wntrblm/Castor_and_Pollux/hardware/mainboard/gemini.png

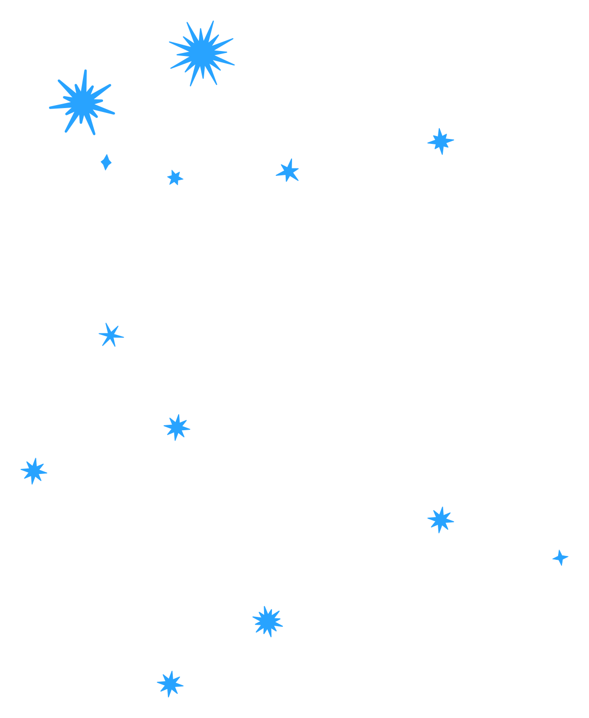
hardware/mainboard/gemini.png
