wntrblm/Castor_and_Pollux/hardware/interposer/interposer.step

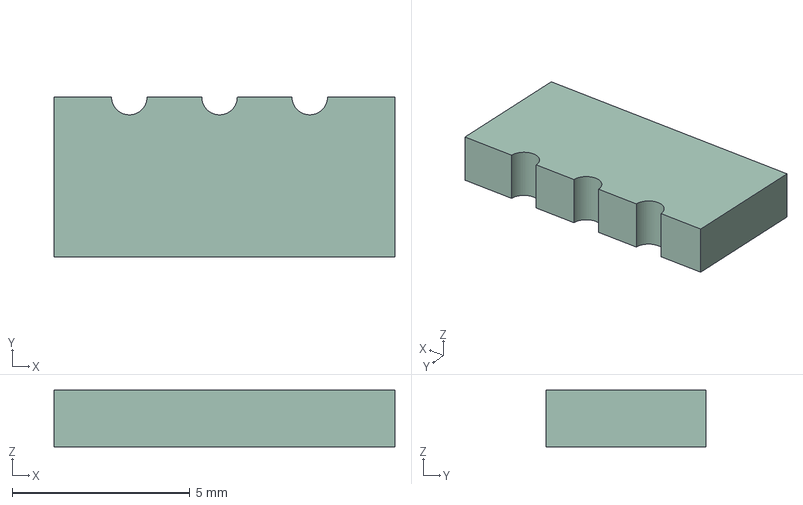
[picture p2: CAD file, 2023-03-20]
hardware/interposer/interposer.step
9.60 x 4.50 x 1.60 mm
