wntrblm/Castor_and_Pollux/hardware/jackboard/jackboard.step

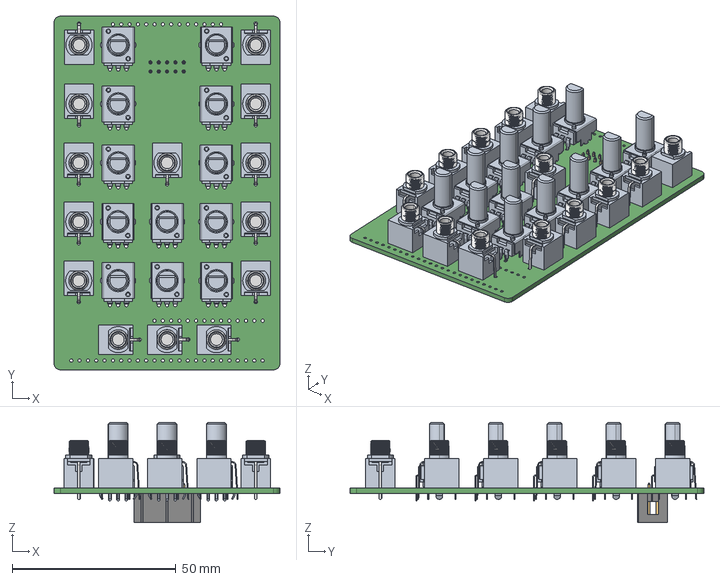
[picture p3: CAD file, 2020-07-21]
hardware/jackboard/jackboard.step
69.0 x 108.0 x 30.6 mm
