wntrblm/Castor_and_Pollux/user_guide/docs/index.md

# Manual

[Castor & Pollux][store page] is a Roland Juno-inspired oscillator. It contains two digitally controlled analog oscillators implemented using a faithfully modernized version of the original Juno 106 design. Like its inspiration, it can give you that wonderful 80's sound with independent and mixed ramp, pulse, and sub outputs. But the twins don't stop there- the second oscillator can be used to layer in thick detuned sounds, harmonically complex hard synced waveshapes, or as a fully independent second oscillator.

[TOC]

[store page]: https://winterbloom.com/store/winterbloom-castor-and-pollux

## Specifications

-   Available [assembled][store page] or as a [kit][kit store page]
-   14 HP
-   `+12 V @ 100 mA`, `-12 V @ 35 mA`
-   `25 mm` deep
-   2 separate oscillators
-   7 octave range
-   9 total outputs with waveform outputs and onboard mixers
-   Pitch CV input jacks (`0 V` to `6 V`) and pitch knobs (`-1` to `+1 octave`, configurable)
-   Pulse width CV input jacks and knobs
-   Hard sync
-   Hardware chorusing
-   Internal low-frequency oscillator (LFO)
-   [ModularGrid page][modulargrid page]

[kit store page]: https://winterbloom.com/shop/castor-and-pollux-kit
[modulargrid page]: https://www.modulargrid.net/e/winterbloom-castor-pollux

## Getting support and help

We want you to have a wonderful experience with your module. If you need help or run into problems, please reach out to us. Email is the best way for product issues, whereas Discord and GitHub are great for getting advice and help on how to customize your module or create new patches.

-   Send us [an email][email]
-   File a bug [on GitHub](https://github.com/wntrblm/Castor_and_Pollux/issues)
-   Reach out on our [Discord][discord]

## Version differences

Illustration of Castor & Pollux I and Castor & Pollux II

Castor & Pollux has two different versions in the wild with significant changes between them. Fortunately, both versions are fundamentally the same brains with different user interfaces. Changes made by Castor & Pollux II include:

-   Replacing the pitch trimpots with large knobs
-   Replacing the pulse width, LFO, and crossfade trimpots with knobs
-   Moving the input and output jacks to the bottom edge of the module
-   Moving the individual waveform outputs to a separate expander
-   Consolidating the two separate circuit boards into a single board
-   Adding additional [ESD] protection to all input jacks
-   Adding an additional LED

Both versions use the same firmware and behave the same way. This manual applies to both versions, however, the illustrations shown here depict Castor & Pollux II. We made sure that all interface elements use the same symbols and labels between the versions. If you run into trouble, don't hesitate to [reach out].

[ESD]: https://en.wikipedia.org/wiki/Electrostatic_discharge
[reach out]: #getting-support-and-help

## Installation

Illustration of power connection

To install this into your Eurorack setup, connect a Eurorack power cable from your power supply to the back of the module. **Note that even though there's a keyed power connector on the module, double check that the red stripe is on the side labeled `red stripe`!** Once you've connected the power cable, secure your module to your rack rails using screws.

## Overview

Castor & Pollux has two separate but _intertwined_ oscillators. It's possible to control each oscillator independently, but they truly shine when used together. Castor & Pollux's design is focused around the connection between these two oscillators and modulating their parameters using the internal LFO.

Illustration of Castor & Pollux's interface with elements for the separate oscillators highlighted

Castor & Pollux's front panel is arranged so that Castor's inputs, outputs, and controls are on the **left** whereas the corresponding elements are mirrored on the **right** for Pollux. The center contains controls for the internal LFO and crossfade mixer:

Each oscillator, ++"⍺"++ and ++"β"++, is controlled by its associated knobs and CV input jacks:

Illustration of the knobs and input jacks

-   The large pitch knob and pitch CV input control the oscillator's **pitch** (frequency).
-   The smaller pulse width knob and pulse width CV input control the oscillator's **pulse width**.

You can learn more about these inputs in the [pitch behavior](#pitch-behavior) section.

Each oscillator has a single output jack, ++"★"++, and corresponding mixing knobs:

Illustration of the oscillator's outputs

Each oscillator generates three waveshapes: _saw_, _pulse_, and _sub_. The three mixing knobs control how much of each waveshape is present in the oscillator's output. You can read more about the sound of each waveshape in the [waveshapes](#waveshapes) section.

Next, the _crossfade mixer_ combines the output of the two oscillators together:

Illustration of the crossfade mixer and its output jack

The crossfader's knob, ++"Σ"++, determines which oscillator is more prominent in the mix at the crossfade output, `♊️`. The [oscillator stacking](#oscillator-stacking) section has more details and sound samples of combining the oscillators together.

Next up, in the very middle there's the LFO knob, ++"φ"++:

Illustration of the LFO knob

This [internal LFO](#internal-low-frequency-oscillator) can be used to modulate several parameters in interesting ways depending on the [mode](#modes-tweaking).

Last, but not least, there is a single button in the center that's used for changing modes and enabling the tweak overlay:

Illustration of the button

You can learn more about the different modes and tweaking in the [modes & tweaking section](#modes-tweaking).

## First steps

If you're not sure where to start with Castor & Pollux this section has a few patches to get you up and running. Grab your patch cables and follow along.

### Patch one

First, dip your toes in by putting together this patch:

Illustration of the first patch

-   Turn all the knobs and trimpots fully counter-clockwise
-   Turn the ramp mix trimpot for Castor fully clockwise
-   Patch Castor's output jack to your rack's output or headphones module

You should hear a low, rumbly bass sound. Turn Castor's pitch knob (the big knob at the top left) and you'll hear Castor sweep through its range. This is called _coarse_ behavior and it's explained in more detail in the [pitch](#pitch-behavior) section.

You can keep playing around with this patch by moving the mix trimpots for each of the waveshapes to hear how they sound. You can also jump down to the [waveshapes](#waveshapes) section to learn more about those.

### Patch two

Ready for more? Try out this patch:

Illustration of the second patch

-   Turn Castor's pitch knob and pulse knob to 12 o' clock
-   Turn at least one of Castor's mix trimpots clockwise
-   Patch some V/oct CV from a sequencer, controller, or other source into Castor's pitch CV input jack.
-   Patch Castor's output jack to your rack's output or headphones module

Castor should now be playing notes based on the CV you're sending it. You can turn Castor's big pitch knob to tune/detune relative to the input. This is called _fine_ behavior and it's also explained in more detail in the [pitch](#pitch-behavior) section.

### Patch three

Okay, one last patch and you'll be ready for anything:

Illustration of the third patch

-   Turn Castor's pitch knob and pulse knob to 12 o' clock
-   Turn Pollux's pitch knob and pulse knob to 12 o' clock
-   Turn at least one of Castor's mix trimpots clockwise
-   Turn at least one of Pollux's mix trimpots clockwise
-   Turn the LFO knob fully counter-clockwise
-   Turn the crossfade knob to 12 o' clock
-   Patch some V/oct CV from a sequencer, controller, or other source into Castor's pitch CV input jack.
-   Patch the crossfade output jack to your rack's output or headphones module

This is where things get fun- at this point, Castor & Pollux should both be playing (roughly) the same pitch and they're both coming through the crossfade output jack. Now, slowly wiggle Pollux's pitch knob. This is the most basic form of [oscillator stacking](#oscillator-stacking) and it's your gateway to the big, raw, and fun sounds of Castor & Pollux.

Now that you have a feel for Castor & Pollux, check out the rest of the manual to learn all about its various features, behaviors, and sounds.

## Pitch behavior

Due to the intertwined nature of Castor & Pollux's oscillators, the effect of the pitch CV jack and knobs take on different _behaviors_ in different circumstances.

!!! fairy "Customization"
    You can modify Castor & Pollux's pitch behavior using the [settings editor](#editing-module-settings).

### Coarse

Illustration of coarse pitch behavior

When [nothing](#jack-detection) is patched into Castor's pitch CV jack, `Coarse` behavior is used. Castor's pitch is determined by its pitch knob which sweeps through six octaves and quantizes to the nearest semitone.

### Fine

Illustration of fine pitch behavior

If there is a signal patched into Castor's pitch CV jack, `Fine` behavior is used. The input CV should be between `0 V` and `6 V`. The pitch knob offsets the input CV by `±1 octave`. The pitch knob has a sort of ["virtual notch"](#tuning) at the 12 o' clock position to help you dial in the frequency you're looking for.

Pollux also uses `Fine` behavior but _follows_ Castor if nothing is patched into its pitch CV jack. Pollux doesn't ever use `Coarse` behavior.

### Multiply

Illustration of multiply pitch behavior

Finally, Pollux uses `Multiply` behavior when in [Hard Sync](#hard-sync) mode. In this case, Pollux follows Castor and the knob adds up to three octaves.

### Jack detection

Castor & Pollux detects whether a signal is patched into the pitch jacks by checking if the signal is above `0 V`. In many cases this works well, however, you may run into issues if you use a sequencer or controller that often sends `0 V` signals. Castor & Pollux will think that a jack isn't detected and erroneously switch to a different [pitch behavior](#pitch-behavior). If this is something you're running into you can turn off jack detection using the [settings editor](#editing-module-settings).

## Tuning

Castor & Pollux is an analog oscillator with a digital brain. It's calibrated during assembly to accurately track `1 V / octave` on the **pitch CV jacks** and you can use the **pitch knobs** to adjust the tuning of each oscillator.

To make tuning easier, Castor & Pollux provides two ways of using the pitch knob to dial in the perfect frequency.

<div class="card interactive">
    <div class="output">
        <label for="linear_tune">Linear response</label>
        <canvas id="linear_tune_canvas" width="640" height="50" class=""></canvas>
        <output id="linear_tune" name="linear_tune">440 Hz</output>
        <label for="non_linear_tune">Non-linear response</label>
        <canvas id="nonlinear_tune_canvas" width="640" height="50" class=""></canvas>
        <output id="non_linear_tune" name="non_linear_tune" class="teal">440 Hz</output>
    </div>
    <form id="tuning-form">
        <label for="tuning_slider">pitch knob</label>
        <input type="range" id="tuning_slider" name="tuning_slider"
                min="-1.0" max="1.0" step="0.001" value="0.0">
    </form>
</div>

First, the pitch knobs have a "virtual notch" because of their **non-linear** response: they're less sensitive in the middle of their range than the edges. It's usually easier to understand this visually, so try out the little illustration above and notice that with the non-linear response it's much easier to tune to frequencies around `440 Hz`. This non-linear response only happens when the oscillator is using the `Follow` [pitch behavior](#pitch-behavior). You can configure how strong this effect is using the [settings editor](#editing-module-settings).

Illustration of tweak mode pitch tuning

Second, the [tweak](#modes-tweaking) overlay allows extra-fine control over tuning. Holding down the button and turning the pitch knob allows you to apply an additional `±2.5 semitone` offset. This offset is applied to the oscillator regardless of the [pitch behavior](#pitch-behavior) or the current [mode](#modes-tweaking).

## Waveshapes

Just like the Juno, Castor & Pollux generates three waveshapes: ramp, pulse, and sub.

The ramp wave looks like this:

<div class="interactive">
    <canvas id="ramp" width="640" height="480" class="waveform teal"></canvas>
</div>

click the image to start and stop the animation
{.image-caption}

!!! fairy "Simulation vs reality"
    These are _simulations_ of perfect waveshapes. Castor & Pollux's waveshapes are generated by analog circuitry and they don't quite look _exactly_ like these examples. That's a good thing - the analog weirdness is what adds character to the module.

The ramp sounds like this:

<winter-audio-player title="ramp wave" src="resources/ramp_octaves.mp3"></winter-audio-player>

<winter-audio-player title="ramp with filter" src="resources/ramp_filtered.mp3"></winter-audio-player>

The pulse wave depends on the pulse width CV and knob. You can vary the pulse width in this animation to see how it affects the waveshape:

<div class="interactive">
    <canvas id="pulse" width="640" height="480" class="waveform purple"></canvas>
    <form id="pulse-form">
        <label for="pulse-width">pulse width</label>
        <input type="range" id="pulse-width" name="width"
                min="0" max="1.0" step="0.01" value="0.5" data-bind data-bind-type="float">
    </form>
</div>

You can also use [internal low-frequency oscillator](#internal-low-frequency-oscillator) to modulate the pulse width in [LFO PWM mode](#lfo-pwm).

Here are some examples of the pulse wave's sounds:

<winter-audio-player title="pulse wave" src="resources/square_octaves.mp3"></winter-audio-player>

<winter-audio-player title="pulse with pulse-width modulation" src="resources/square_pwm.mp3"></winter-audio-player>

<winter-audio-player title="pulse with filter" src="resources/square_filtered.mp3"></winter-audio-player>

Finally, there's the sub waveshape. It's a square wave that's one octave lower. Here's what it looks like:

<div class="interactive">
    <canvas id="sub" width="640" height="480" class="waveform red"></canvas>
</div>

And here are some sound samples of the sub waveshape:

<winter-audio-player title="sub wave" src="resources/sub_octaves.mp3"></winter-audio-player>

<winter-audio-player title="sub with filter" src="resources/sub_filtered.mp3"></winter-audio-player>

These waveshapes can be mixed together to produce much more complex and interesting variants - try playing with the sliders under this animation to see how it affects the waveshape:

<div class="interactive">
    <canvas id="mix" width="640" height="480" class="waveform teal2"></canvas>
    <form id="mix-form">
        <div class="slider">
            <input type="range" id="ramp_mix" name="ramp_mix"
                    min="0" max="0.5" step="0.01" value="0.5" data-bind data-bind-type="float">
            <label for="ramp_mix">ramp volume</label>
        </div>
        <div class="slider">
            <input type="range" id="pulse_mix" name="pulse_mix"
                    min="0" max="0.5" step="0.01" value="0.25" data-bind data-bind-type="float">
            <label for="pulse_mix">pulse volume</label>
        </div>
        <div class="slider">
            <input type="range" id="pulse_width_mix" name="pulse_width"
                    min="0" max="1.0" step="0.01" value="0.5" data-bind data-bind-type="float">
            <label for="pulse_width_mix">pulse width</label>
        </div>
        <div class="slider">
            <input type="range" id="sub_mix" name="sub_mix"
                    min="0" max="0.5" step="0.01" value="0.25" data-bind data-bind-type="float">
            <label for="sub_mix">sub volume</label>
        </div>
    </form>
</div>

Here are some sound samples of various mixes:

<winter-audio-player title="ramp & sub" src="resources/ramp_and_sub.mp3"></winter-audio-player>

<winter-audio-player title="sub & pulse" src="resources/ramp_and_square_with_pwm.mp3"></winter-audio-player>

<winter-audio-player title="various mixes" src="resources/waveform_mixing.mp3"></winter-audio-player>

## Oscillator stacking

Because Castor & Pollux has two oscillators, you can combine them together to build much more complex sounds. When there is no input into the second oscillator's pitch CV jack, it follows the pitch of the first oscillator. You can use the pitch knob of the second oscillator to _detune_ the second oscillator and cause interesting interactions with the first oscillator. You'll take your output from the **combined output** (marked by the symbol `♊︎`) and you can control the relative volume of the two oscillators using the **crossfader** (marked by the symbol `Σ`).

You can play around with this interactive animation to see how detuning and mixing changes the final waveshape:

<div class="interactive">
    <canvas id="stacked" width="640" height="480" class="waveform purple2"></canvas>
    <form id="stacked-form">
        <div class="slider">
            <input type="range" id="stacked_detune" name="detune"
                    min="-1" max="1" step="0.01" value="0.25" data-bind data-bind-type="float">
            <label for="stacked_detune">detuning</label>
        </div>
        <div class="slider">
            <input type="range" id="stacked_mix" name="mix"
                    min="0" max="1.0" step="0.01" value="0.5" data-bind data-bind-type="float">
            <label for="stacked_mix">crossfader (Σ)</label>
        </div>
    </form>
</div>

This animation just uses the ramp waveshape, but the crossfader takes the mix from each oscillator's mixer, so you can combine many different waveshapes. Here are some sound samples of oscillator stacking:

<winter-audio-player title="stacked complex waveforms" src="resources/stacked_complex.mp3"> </winter-audio-player>

<winter-audio-player title="stacked sub & ramp" src="resources/twilight.mp3"> </winter-audio-player>

<winter-audio-player title="stacked sub & pulse" src="resources/steps.mp3"> </winter-audio-player>

## Internal low-frequency oscillator

Castor & Pollux's built-in low-frequency oscillator can be used to modulate various parameters depending on the current [mode](#modes-tweaking).

Illustration of LFO waveshape

By default, the internal LFO is a straightforward triangle wave. However, the [settings editor](#editing-module-settings) allows you to change the LFO's waveshape between triangle, sine, sawtooth, and square, as well as combine a _second_ waveshape with the first to create interesting LFO effects.

## Modes & tweaking

Castor & Pollux has four different _modes_ that change the  module's overall functionality:

Illustration of modes

-   [Chorus](#chorus) mode, the default mode, uses the internal LFO to modulate Pollux's frequency. This is indicated with a *teal* animation.
-   [LFO PWM](#lfo-pwm) mode uses the internal LFO to modulate the pulse with of both oscillators. This is indicated with an *orange* animation.
-   [LFO FM](#lfo-fm) mode uses the internal LFO to modulate the frequency of both oscillators. This is indicated with a *green* animation.
-   [Hard Sync](#hard-sync) mode produces metallic sounds by syncing Pollux's ramp core to Castor's. This is indicated with a *pink* animation.

Illustration of tapping the button

To cycle between modes, **tap** the button in the middle and the module will play a short animation to show that it has switched modes.

Illustration of holding the button

On the other hand, **holding** the button turns on the tweak overlay. This gives you access to additional parameters depending on the mode. When moving in and out of the tweak overlay, the knobs get "latched" so that they don't immediately cause changes - similar how many synthesizers work when loading patches. The parameter only starts changing once you've moved the knob. In all modes, the pitch knobs control the extra-fine [tuning](#tuning).

### Chorus

Castor & Pollux's default mode is the _Chorus_ mode. This mode is inspired by the original Juno's analog chorus circuit, however, instead of applying the chorus affect _after_ sound generation, Castor & Pollux's chorusing works by varying the frequency of the second oscillator using its [internal low-frequency oscillator](#internal-low-frequency-oscillator). This means you have to [use both oscillators](#oscillator-stacking) to hear this effect and it works best if Pollux is _following_ Castor's pitch.

Illustration of chorus controls

The LFO knob, `φ`, determines the intensity of chorusing from none when fully counter-clockwise to its maximum at fully clockwise. The crossfade mixer, `Σ`, also has an impact on the intensity of the chorus.

Illustration of chorus tweak controls

When holding the tweak button, the LFO knob, `φ`, controls the LFO's frequency.

You can play around with this interactive animation to see how the chorusing amount changes the final waveshape. You'll need to click the animation to start it otherwise you won't really be able to see the chorusing effect.

<div class="interactive">
    <canvas id="chorusing_" width="640" height="480" class="waveform red2"></canvas>
    <form id="chorusing-form">
        <div class="slider">
            <input type="range" id="chorusing_amount" name="amount"
                    min="0" max="1" step="0.01" value="0.25" data-bind data-bind-type="float">
            <label for="chorusing_amount">chorusing amount (φ)</label>
        </div>
    </form>
</div>

Here are some sound samples of chorusing:

<winter-audio-player title="chorusing" src="resources/chorusing.mp3"></winter-audio-player>

### LFO PWM

LFO PWM mode uses the internal LFO to modulate the _pulse width_ of each oscillator. This only affects the _pulse_ [waveshape](#waveshapes).

Illustration of the LFO PWM controls

The LFO knob, `φ`, determines the _frequency_ of the internal LFO. Meanwhile, each oscillator's pulse width knob controls the depth of modulation from none when fully counter-clockwise to its maximum at fully clockwise. Any signal patched into the pulse width jack is summed with the knob.

Illustration of the LFO PWM tweak controls

When holding the tweak button, each oscillator's pulse width knob controls the _center_ of the pulse width modulation.

### LFO FM

LFO FM mode uses the internal LFO to modulate the _pitch_ for each oscillator. This is similar to the [Chorus mode](#chorus), except it applies to both oscillators instead of just Pollux.

Illustration of LFO FM controls

The LFO knob, `φ`, determines the _frequency_ of the internal LFO. Meanwhile, each oscillator's pulse width knob controls the depth of pitch modulation from none when fully counter-clockwise to its maximum at fully clockwise.

Unlike the LFO PWM mode, the pulse width jack has no impact on modulation.

Illustration of LFO FM tweak controls

When holding the tweak button, each oscillator's pulse width knob controls the oscillator's pulse width.

### Hard sync

[_Hard sync_][hard sync] is a feature seen in several synthesizer voices that have two or more oscillators. However, it's not a feature seen on the original Juno because each voice only had one oscillator. Luckily, Castor & Pollux has two oscillators!

Illustration of hard sync where the first waveform resets the second waveform

_Hard sync_ mode syncs Pollux's oscillator to Castor's frequency - Pollux's output retains the same _base frequency_ as Castor but the waveshape changes dramatically with Pollux's pitch. In other words, it'll sound like the same note but have a much different, usually metallic, timbre.

Since hard sync only affects Pollux, you'll have to use either Pollux's output or the crossfade output to hear the change in timbre.

Here are some sound samples of hard sync:

<winter-audio-player title="hard sync" src="resources/hard_sync.mp3"></winter-audio-player>

Hard sync mode's controls are the same as [chorus mode](#chorus) except that Pollux's pitch knob uses the [Multiply behavior](#pitch-behavior):

!!! fairy "Hey, listen!"
    Due to the way hard sync works, you shouldn't set the second oscillator to a _lower_ frequency than the first. It'll just result in the sound growing softer since the second oscillator doesn't have enough time to output a complete wave cycle.

[hard sync]: https://en.wikipedia.org/wiki/Oscillator_sync

## Expander

Illustration of C&P & expander next to each other

Castor & Pollux II includes a small expander that provides individual output jacks for each oscillator's [waveshapes](#waveshapes).

Illustration of connecting the expander to C&P

To use the expander, connect the small ribbon cable to the back of Castor & Pollux in the header labeled `Expander`. Connect the other end to the matching header on the back of the expander. Secure the expander to your case using screws.

!!! fairy "Lost cable?"
    Happens to the best of us. [Contact us][email] to get a replacement or grab a 10-pin 2x5 Socket-Socket 1.27mm IDC cable (also called a SWD cable) like these from [Adafruit][adafruit cable] and [SparkFun][sparkfun cable].

[adafruit cable]: https://www.adafruit.com/product/1675
[sparkfun cable]: https://www.sparkfun.com/products/15364

## Connecting with USB

You can connect Castor & Pollux to your computer using a standard micro USB cable, which lets you [edit settings](#editing-module-settings) and [update the firmware](#updating-the-firmware).

Illustration of connecting Castor & Pollux to USB

The micro USB port is located on the backside of the module. Once you've connected a cable, be careful not to put too much stress on the connector as it's possible to damage the connector with enough force.

!!! fairy "Power"
    Castor & Pollux II is happy to run on USB power when editing settings and updating firmware, but Castor & Pollux I needs power from your rack power supply while connected to USB.

## Editing module settings

Even though Castor & Pollux uses analog circuitry to make its beautiful sounds, there is a little microcontroller brain inside that's orchestrating everything. There are lots of settings you can tweak over USB, such as the LED brightness, the range of the pitch knobs, quantization, and more.

Connect your module to your computer using [a USB cable](#connecting-with-usb) and then head over to the [web-based settings editor](settings.md) to tweak to your heart's content. You don't need to install any software or drivers.

## Updating the firmware

1. [Download the latest firmware from GitHub][firmware release]. It's the `.uf2` file.
1. Connect your module to your computer using [a USB cable](#connecting-with-usb).
1. Place Castor & Pollux in bootloader mode by quickly pressing the `Reset` button twice. The reset button is the small button next to the USB port. Once in bootloader mode, you should see an external drive on your computer named `GEMINIBOOT`.
1. Copy the `.uf2` file from step one to the `GEMINIBOOT` drive. The module should restart by itself.

[firmware release]: https://github.com/wntrblm/Castor_and_Pollux/releases/latest

## Open source hardware & software

Castor & Pollux is completely open source and hacking is encouraged.

-   The [firmware][firmware source] is available under the [MIT License]. Note that the firmware uses some third-party libraries that are under different, but compatible terms. Read the full text of the license for more details.
-   The [hardware designs][hardware source] are available under the permissive [CERN-OHL-P v2] license, and is designed using [KiCAD], which is also free and open source. You can open the hardware files using KiCAD, or you can download a PDF of the [schematics].

Open Source Hardware Association mark Castor & Pollux is [certified open source hardware][oshwa certification].

[firmware source]: https://github.com/wntrblm/Castor_and_Pollux/tree/main/firmware
[hardware source]: https://github.com/wntrblm/Castor_and_Pollux/tree/main/hardware
[schematics]: https://github.com/wntrblm/Castor_and_Pollux/raw/main/hardware/mainboard/mainboard.pdf
[MIT License]: https://github.com/wntrblm/Castor_and_Pollux/tree/main/firmware/LICENSE
[CERN-OHL-P v2]: https://cern-ohl.web.cern.ch/
[KiCAD]: https://kicad.org/
[oshwa certification]: https://certification.oshwa.org/us001060.html

## Warranty, disclaimers, and limits

Modules purchased from Winterbloom have a warranty of six months from the date of purchase. This warranty covers any manufacturing defects in the module. It does not cover damage due to incorrect handling, storage, power, overvoltage events, or modifications.

Please [contact us][email] if you are experiencing issues with your module. Modules returned under warranty will either be refunded, replaced, or repaired at our discretion. You will be responsible for the cost of returning the module to Winterbloom.

Because Eurorack has a vast number of possible combinations of power supplies, modules, cases, and accessories, it is impossible for us to guarantee compatibility with every possible configuration. We make a reasonable effort to test modules with several power supplies, cases, and other modules.

We encourage tinkering, however, we will not refund, repair, or replace any products that have been modified.

We have stress tested Castor & Pollux under the following conditions. These are provided for reference only; we do not guarantee that the module will function under these conditions.

-   Continuous run time: at least `48 hours`
-   Overvoltage from power supply: at least `±18 V`
-   Reverse voltage from power supply: at least `±18 V`
-   Undervoltage from power supply: as low as `±10 V`
-   Over and under voltage on inputs: at least `±8 V`
-   Output connected to another output: at least `±8 V`
-   Output shorted to ground: at least `60 minutes`

## Errata

### Ramp table swap

**Affected units**
:   This applies to All Castor & Pollux II units shipped prior to February 7th, 2024. Castor & Pollux I units are not affected.

**Description**
:   Due to an error during calibration, the internal ramp calibration tables for the two oscillators are swapped. This table is used to correct the amplitude of the ramp waveform, so when the tables are swapped the waveform appears distorted.
<figure data-layered>
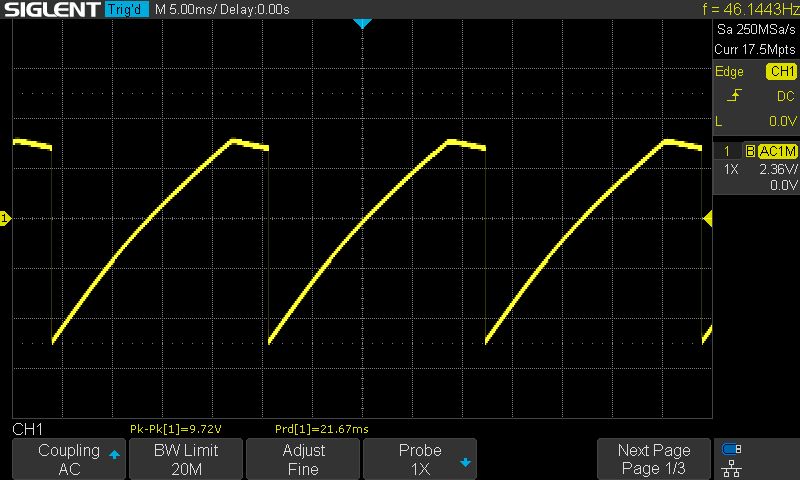
[picture p4: user_guide/docs/images/ramp-distorted.png]
Distorted
  
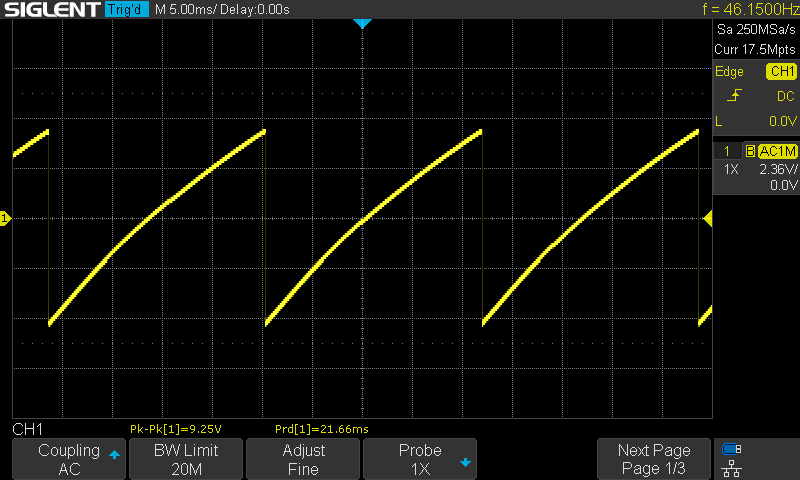
[picture p5: user_guide/docs/images/ramp-correct.png]
Correct
  
</figure>

**Corrective action**
:   This errata can be resolved with just a computer and USB cable. Connect your unit to your computer [via usb](#connecting-with-usb), open the settings editor using [this specific link](settings.md#ramp), press the "connect" button, then scroll all the way to the bottom and press the "swap ramp calibration" button. If this does not work for you, please reach out to us at support@winterbloom.com for assistance.

## Acknowledgments and thanks

Castor & Pollux would not be possible without the help of the Adafruit, support from Microchip, and the volumes of literature documenting and analyzing the Juno's DCO design. We would also like to acknowledge the following individuals for their outstanding support:

- Jeremy Blake
- Kris Kaiser
- Stephen McCaul
- Sarah Ocean
- Izaak Hollander

[discord]: https://discord.gg/UpfqghQ
[email]: mailto:support@winterbloom.com

<link rel="stylesheet" href="styles/waveforms.css">
<script type="module" src="scripts/waveforms.js"></script>
