wntrblm/Castor_and_Pollux/user_guide/docs/build.md

# Castor & Pollux kit build guide

[TOC]

## Before you build

Welcome to the build guide for Castor & Pollux's DIY kit. We hope you have a great time putting this module together and a wonderful time using it.

Please **read all instructions** thoroughly before starting. If you have questions or run into trouble please reach out to us on [discord] or drop us an email at support@winterbloom.com

This build is a **intermediate level** kit. You should be comfortable soldering through-hole components and working near surface mount components. If you're not, we encourage you to try out some other kits first, like our [Big Honking Button kit](https://winterbloom.com/store/winterbloom-big-honking-button-kit). Even if you've got some experience, we recommend taking a look at [Adafruit's guide to excellent soldering](https://learn.adafruit.com/adafruit-guide-excellent-soldering) to refresh your knowledge.

By the way, we program, test, and calibrate the main circuit board before sending it to you, so you don't have to worry about any of that- once you're done building you'll be good to go!

This build takes around **one hour** to complete.

[discord]: https://discord.gg/UpfqghQ

## Tools and materials required

Before jumping in, make sure you have:

* Safety glasses. Yes, really.
* Proper ventilation - at least open a window or two.
* A soldering iron, like [this one](https://www.adafruit.com/product/180).
* Solder, we can recommend [Adafruit's 60/40 **no-clean** rosin core solder](https://www.adafruit.com/product/145).
* A small flat head screwdriver, like [this one](https://lovemyswitches.com/2mm-flat-head-screwdriver-for-knob-set-screws/).

!!! fairy
    We suggest using solder with "no clean" flux. If you use a different kind of flux, be sure to carefully clean the flux residue off based on the guidelines provided by the manufacturer of your solder. Take special care with the LEDs and potentiometers, as they can be damaged by water and flux cleaners.

## Kit contents

Your kit should contain the following items. If any are missing please email us at support@winterbloom.com.

<winter-image-map src="../images/kit/kit-contents.svg">
    <winter-image-map-item id="faceplate">Faceplate</winter-image-map-item>
    <winter-image-map-item id="mainboard">Mainboard</winter-image-map-item>
    <winter-image-map-item id="expander-board">Expander board</winter-image-map-item>
    <winter-image-map-item id="expander-faceplate">Expander faceplate</winter-image-map-item>
    <winter-image-map-item id="rubber-bands">Rubber bands (2)</winter-image-map-item>
    <winter-image-map-item id="expander-cable">Expander cable</winter-image-map-item>
    <winter-image-map-item id="button">Tactile switch</winter-image-map-item>
    <winter-image-map-item id="cap">Tactile switch cap</winter-image-map-item>
    <winter-image-map-item id="power-header">Eurorack power header</winter-image-map-item>
    <winter-image-map-item id="jack-nuts">Nuts for 1/8" jacks (13)</winter-image-map-item>
    <winter-image-map-item id="jacks">1/8" jacks (13)</winter-image-map-item>
    <winter-image-map-item id="small-knobs">Small knobs (4)</winter-image-map-item>
    <winter-image-map-item id="big-knobs">Big knobs (2)</winter-image-map-item>
    <winter-image-map-item id="trimpots">Tall trimmer pots (6)</winter-image-map-item>
    <winter-image-map-item id="pots">9mm pots (6)</winter-image-map-item>
    <winter-image-map-item id="pot-washers-and-nuts">Washers and nuts for 9mm pots (6)</winter-image-map-item>
</winter-image-map>

- (1) Mainboard
- (1) Faceplate
- (1) Expander board
- (1) Expander faceplate
- (1) Expander cable
- (13) 1/8" jacks
- (13) Hex nuts for the 1/8" jacks
- (6) Tall trimmer pots
- (6) 9mm pots
- (6) Washers and nuts for the 9mm pots
- (4) Small knobs
- (2) Large knobs
- (1) Tactile switch
- (1) Tactile switch cap
- (1) Eurorack power header
- (2) Rubber bands

## Power header

Your first task is to solder the 10-pin Eurorack power connector to the mainboard.

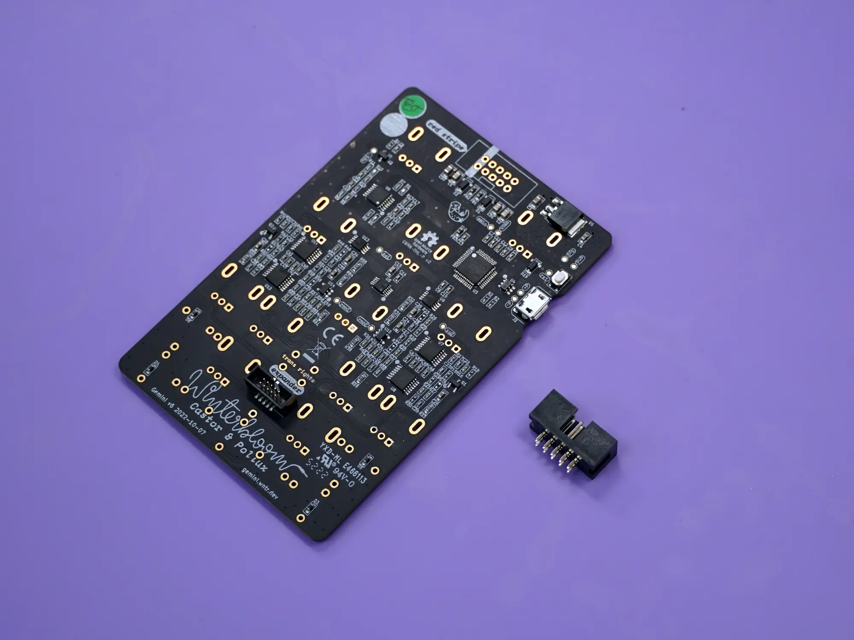
[picture p6: user_guide/docs/images/kit/4 - mainboard and power header.webp]
Power header and mainboard


The power connector goes on the **back** side of the board. When placing **note the notch in the outline on the board**. You'll need to make sure the **slot on the connector matches where the notch is on the outline**.

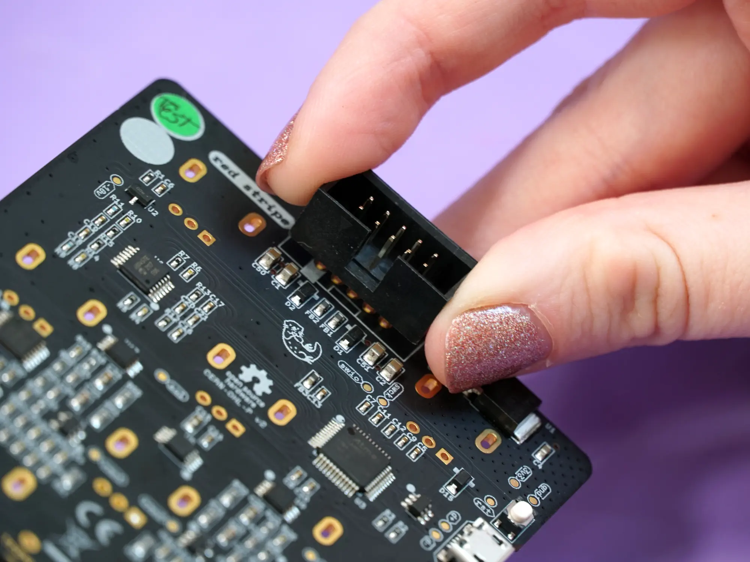
[picture p7: user_guide/docs/images/kit/5 - power header.webp]
Power connector placed


Once placed, make sure to push it flush against the board and then solder the 10 pins on the front side of the board. Be careful here and avoid touching the small components near the pins with your iron.

<winter-carousel>
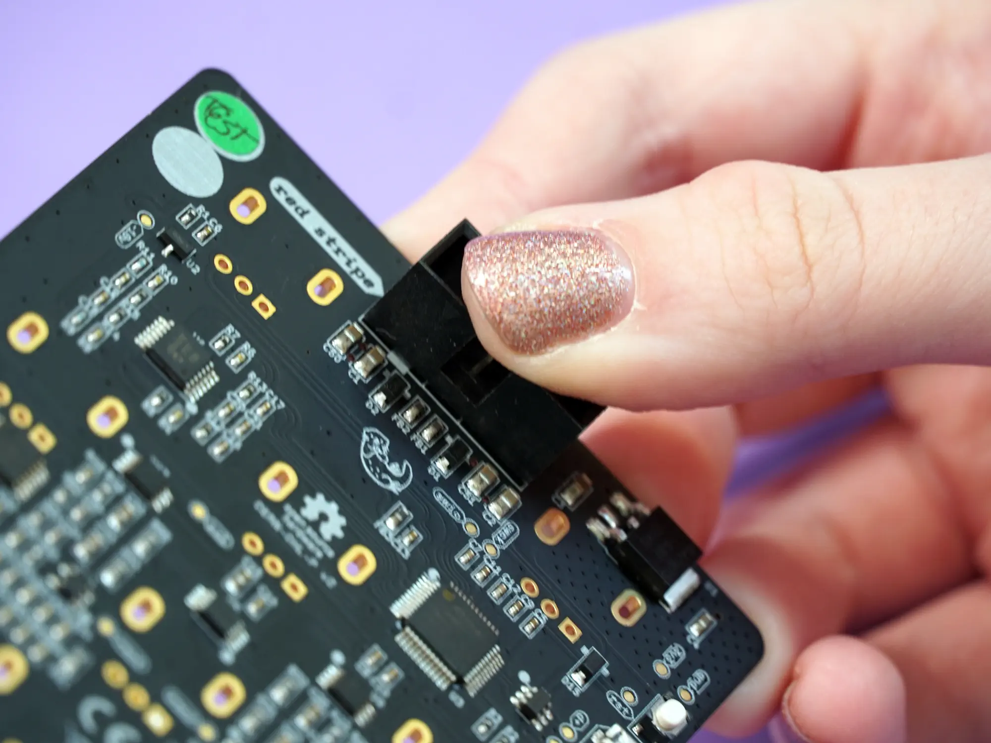
[picture p8: user_guide/docs/images/kit/6 - power header.webp]
  
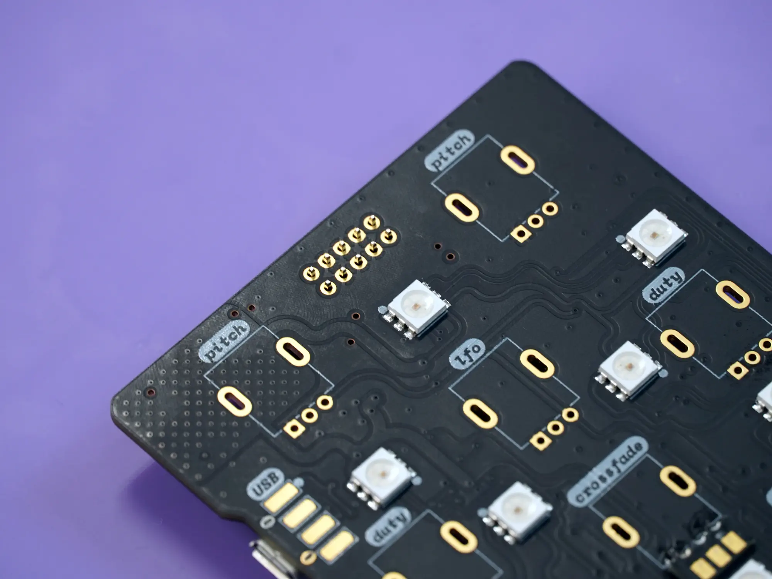
[picture p9: user_guide/docs/images/kit/7 - power header.webp]
  
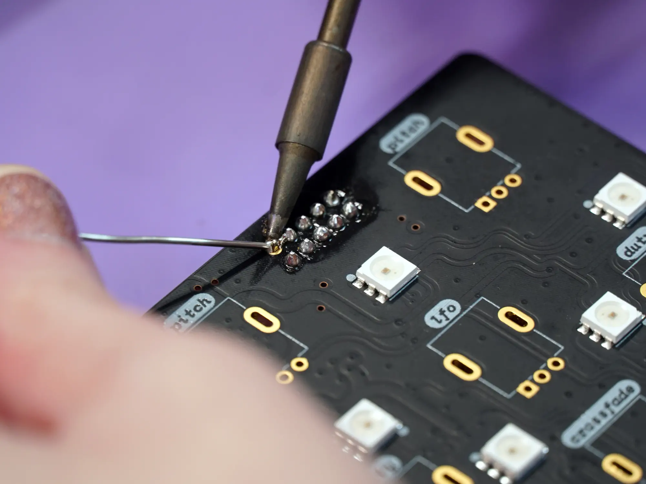
[picture p10: user_guide/docs/images/kit/8 - power header.webp]
  
</winter-carousel>

!!! warning "Watch out for those LEDs!"
    Avoid touching the LEDs with your iron- they really don't like being melted and they're very hard to replace.

## 9mm pots

The next task is placing and soldering the six 9mm pots on the mainboard.

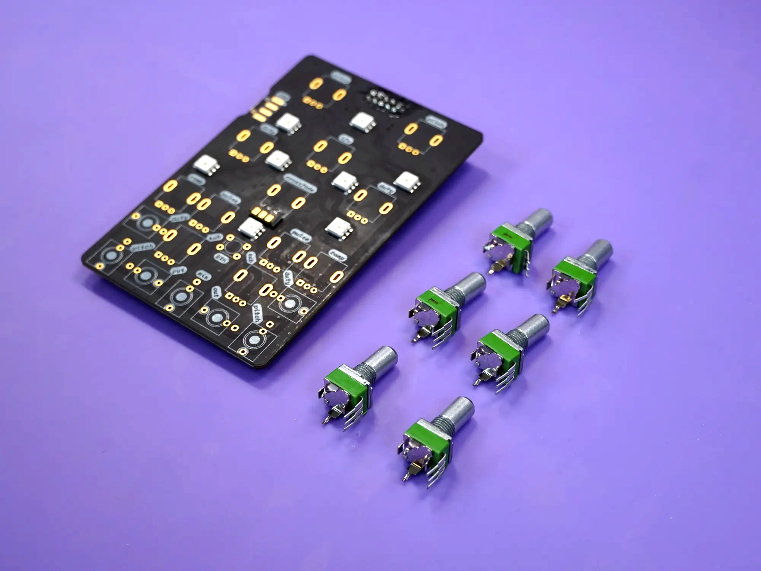
[picture p11: user_guide/docs/images/kit/11 - mainboard and pots.webp]
Pots and mainboard


This step requires **special care and attention** to make sure that the front panel aligns correctly. Please make sure everything is correct before soldering anything in place.

One of the six pots has been modified - its pins are shorter and bent outwards. Find this one and place it aside for the moment.

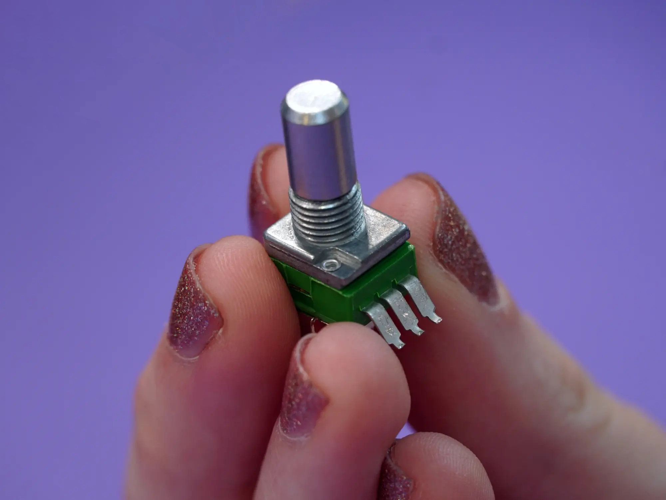
[picture p12: user_guide/docs/images/kit/10 - special pot.webp]
Special pot


Place five of the six pots onto the mainboard in the spots labeled `pitch`, `duty`, and `lfo`. You may need to bend or straighten the mounting legs on the pots to get them in place.

<winter-carousel>
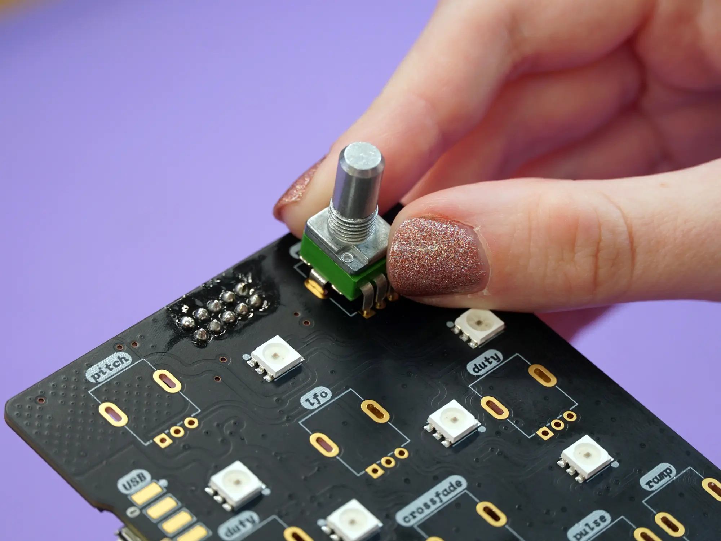
[picture p13: user_guide/docs/images/kit/12 - pots.webp]
  
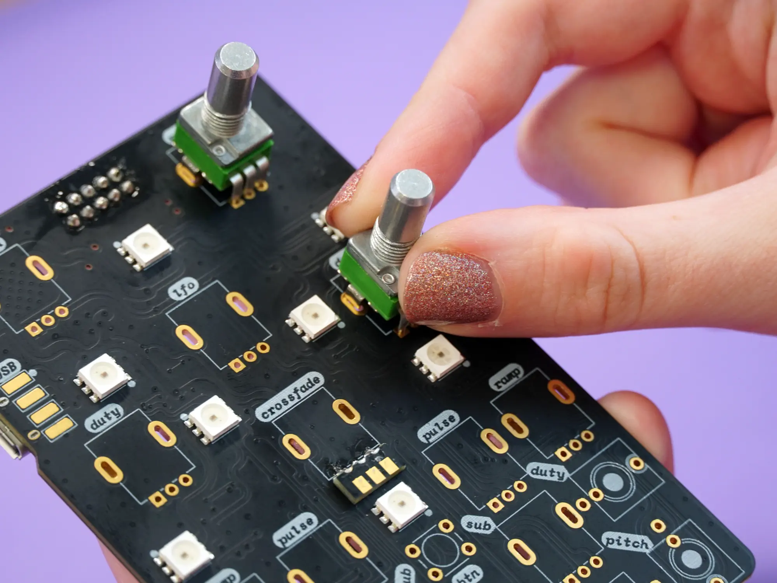
[picture p14: user_guide/docs/images/kit/13 - pots.webp]
  
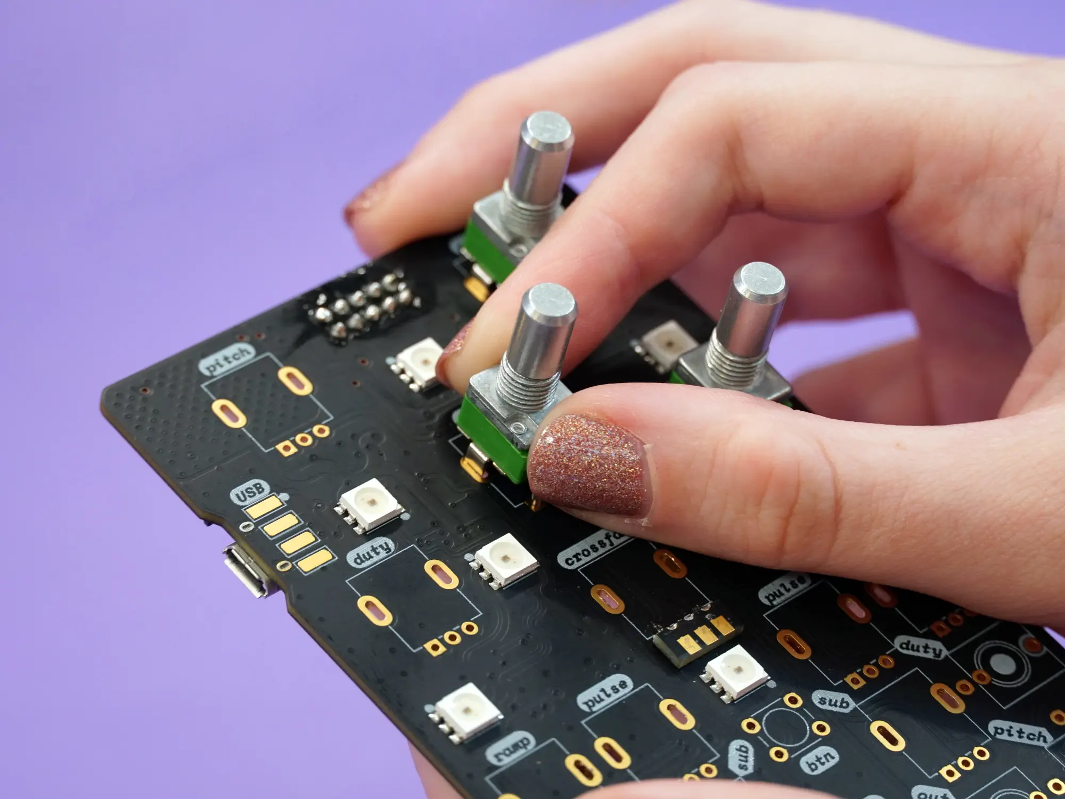
[picture p15: user_guide/docs/images/kit/14 - pots.webp]
  
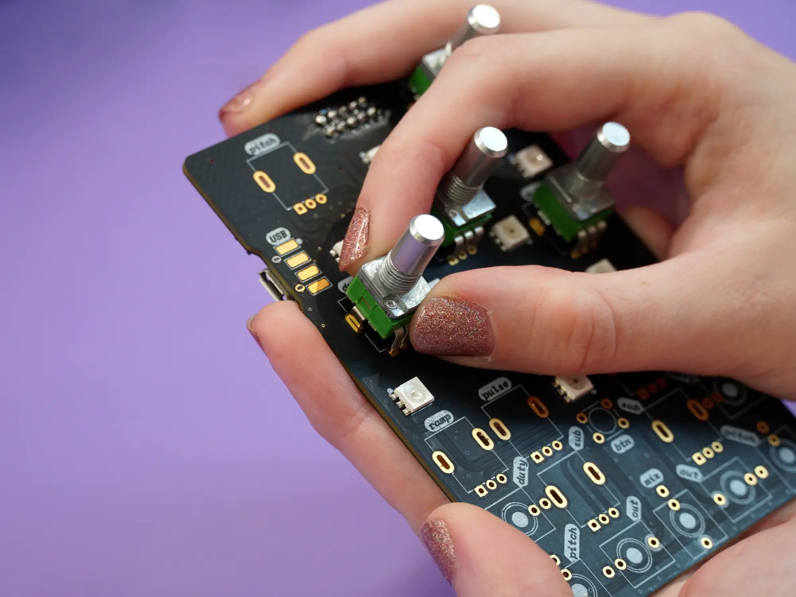
[picture p16: user_guide/docs/images/kit/15 - pots.webp]
  
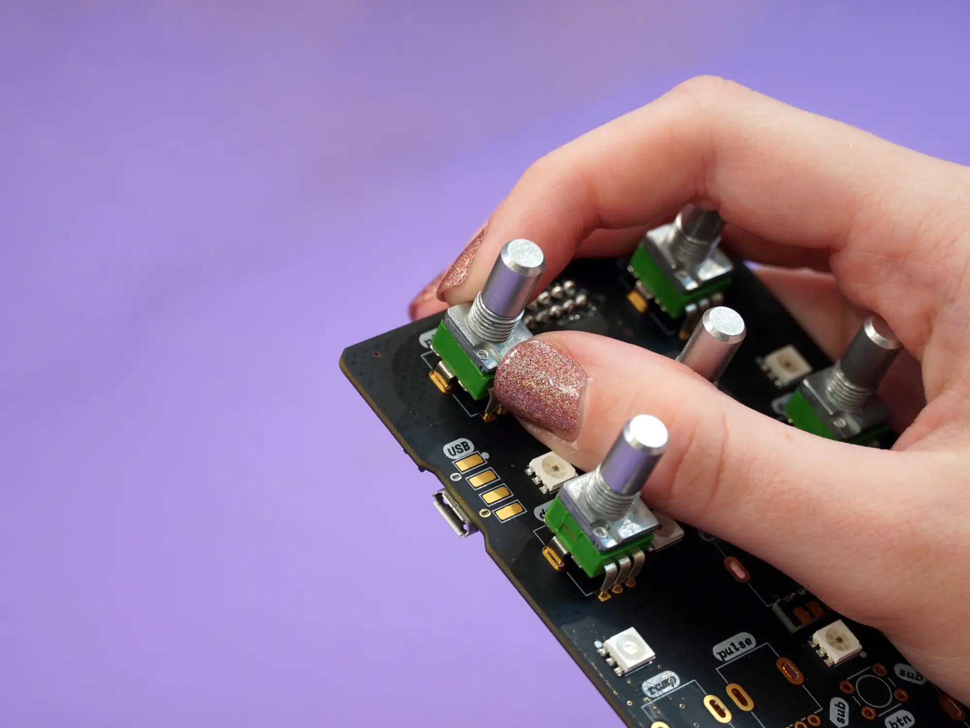
[picture p17: user_guide/docs/images/kit/16 - pots.webp]
  
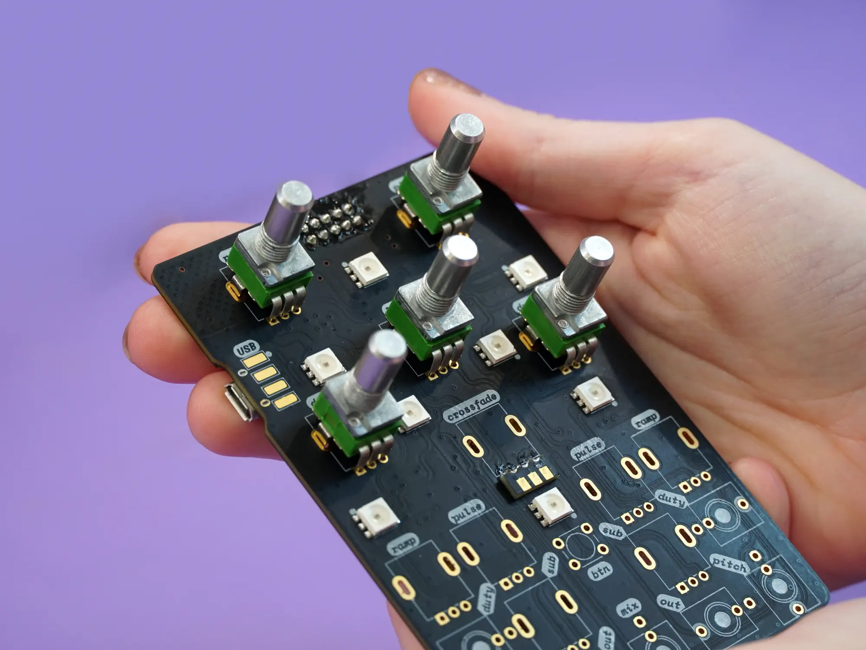
[picture p18: user_guide/docs/images/kit/17 - pots.webp]
  
</winter-carousel>

Take the remaining, modified pot and place it on the spot labeled `crossfade`. This pot will not be as secure as the others, but make sure the pins line up with the pads on the as board shown below.

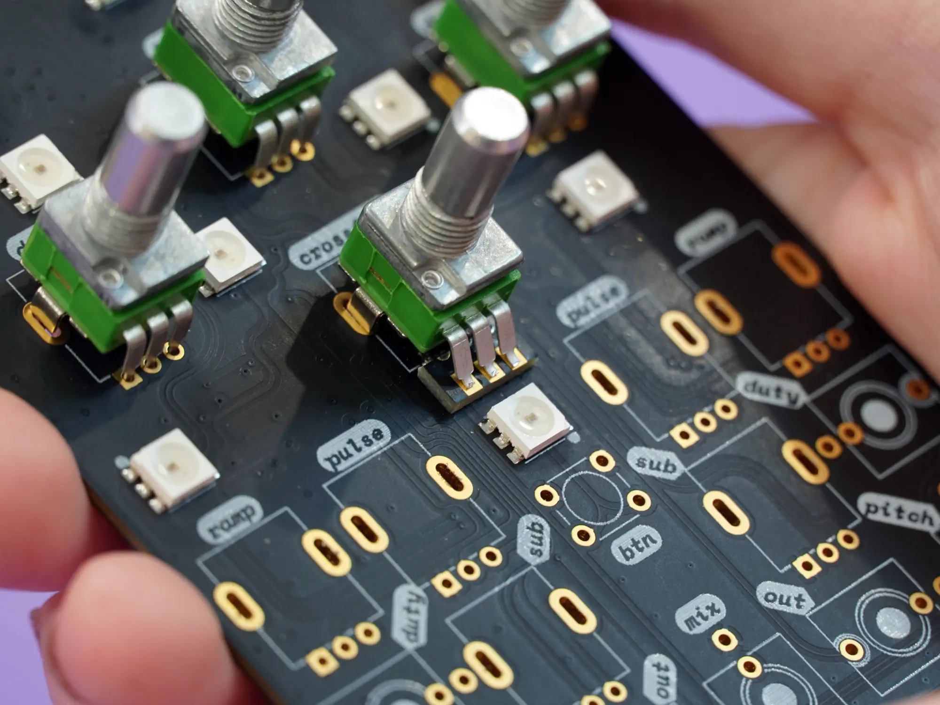
[picture p19: user_guide/docs/images/kit/18 - special pot.webp]
Special pot placed


Next, take one of the 1/8" jacks and place it into the spot at the center bottom edge of the board labeled `mix`:

<winter-carousel>
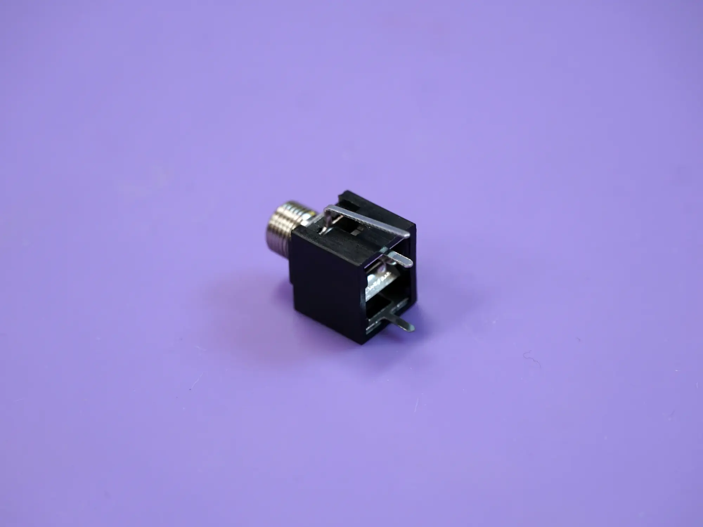
[picture p20: user_guide/docs/images/kit/19 - jack.webp]
  
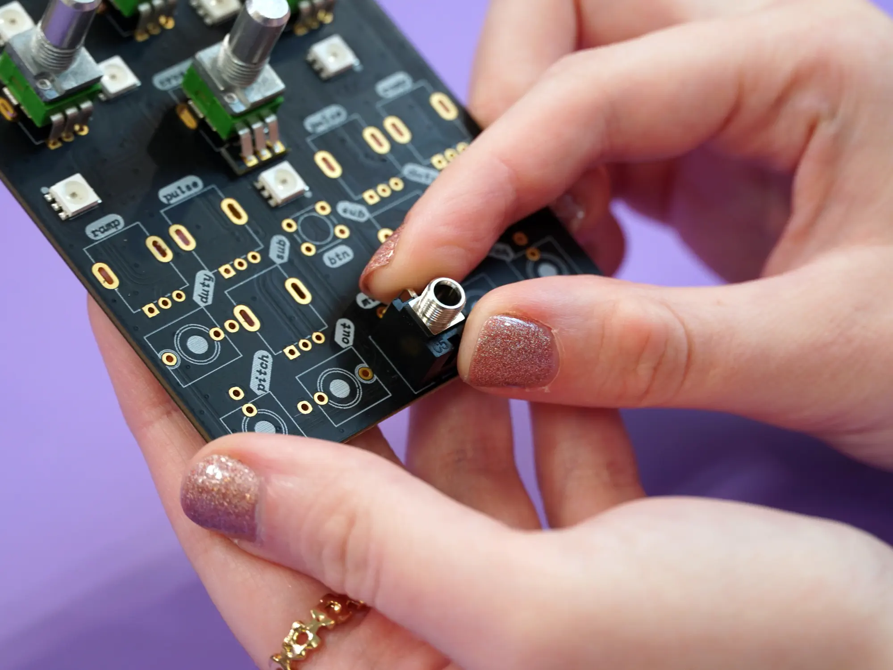
[picture p21: user_guide/docs/images/kit/20 - jack.webp]
  
</winter-carousel>

Next, carefully place the faceplate onto the front of the module. Make sure all of the pots and the jack are aligned and resting in their respective holes.

<winter-carousel>
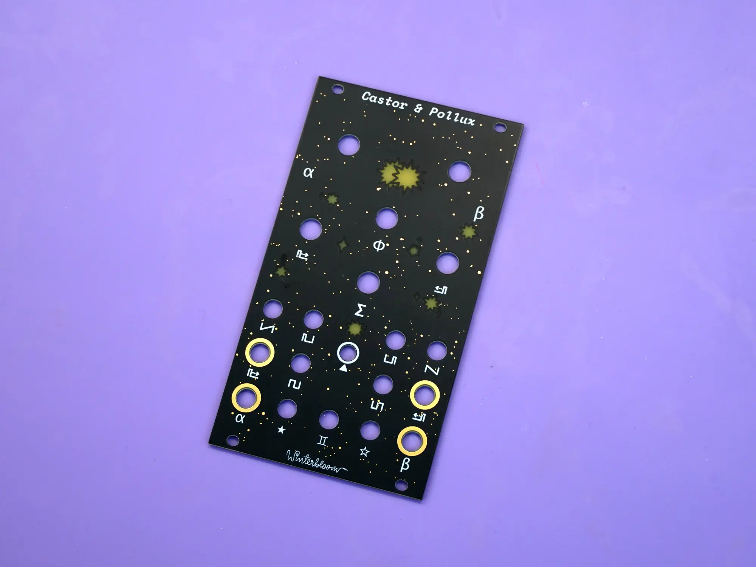
[picture p22: user_guide/docs/images/kit/21 - panel.webp]
  
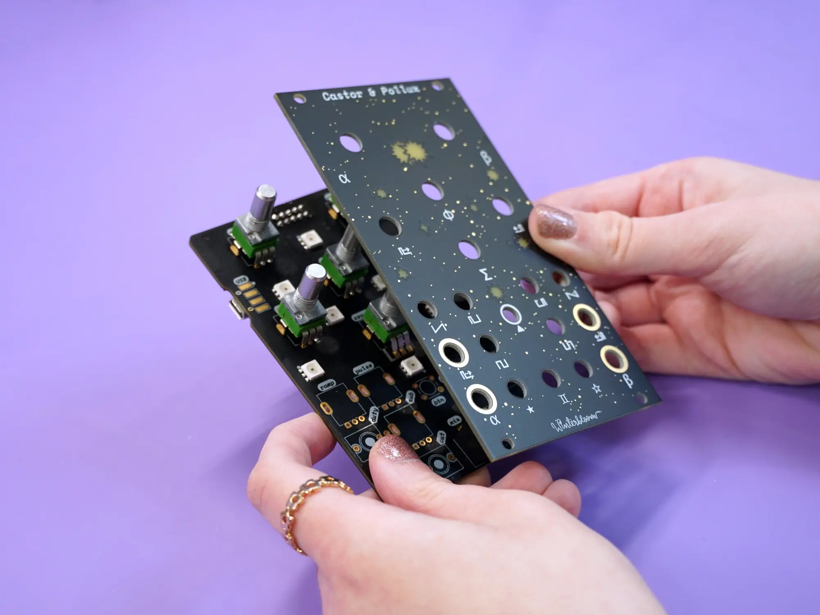
[picture p23: user_guide/docs/images/kit/30 - panel.webp]
  
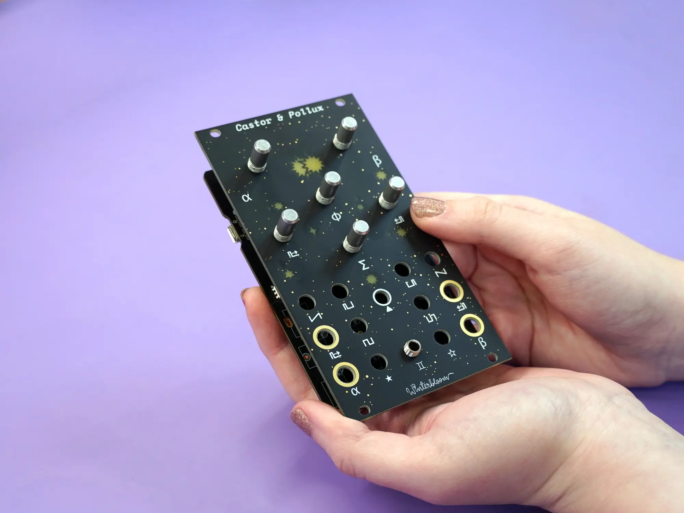
[picture p24: user_guide/docs/images/kit/22 - panel.webp]
  
</winter-carousel>

Take one of the rubber bands and wrap it around the board and faceplate twice to hold the faceplate in place during the next few steps.

<winter-carousel>
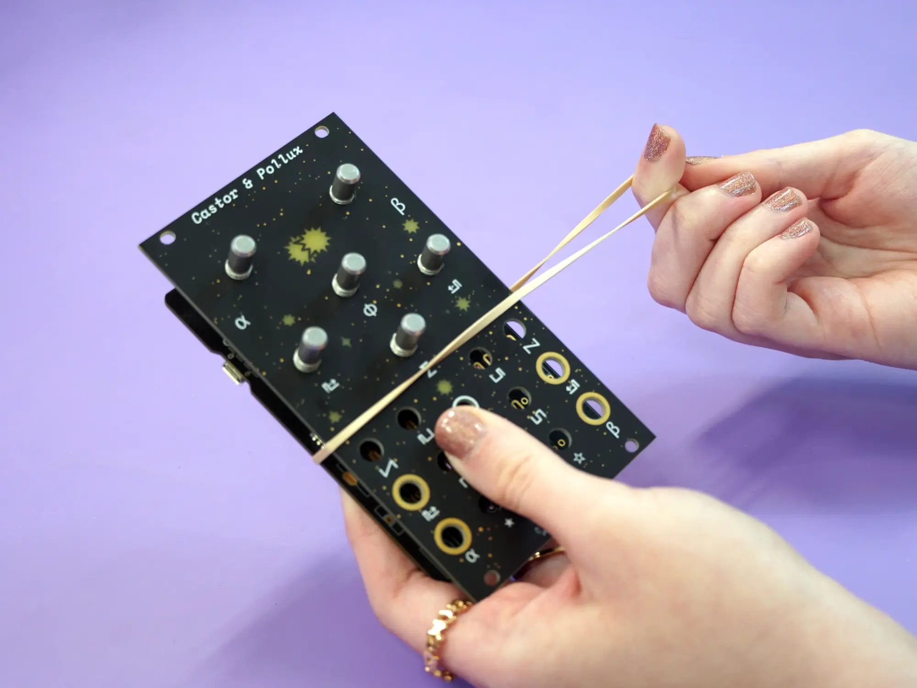
[picture p25: user_guide/docs/images/kit/23 - rubber band.webp]
  
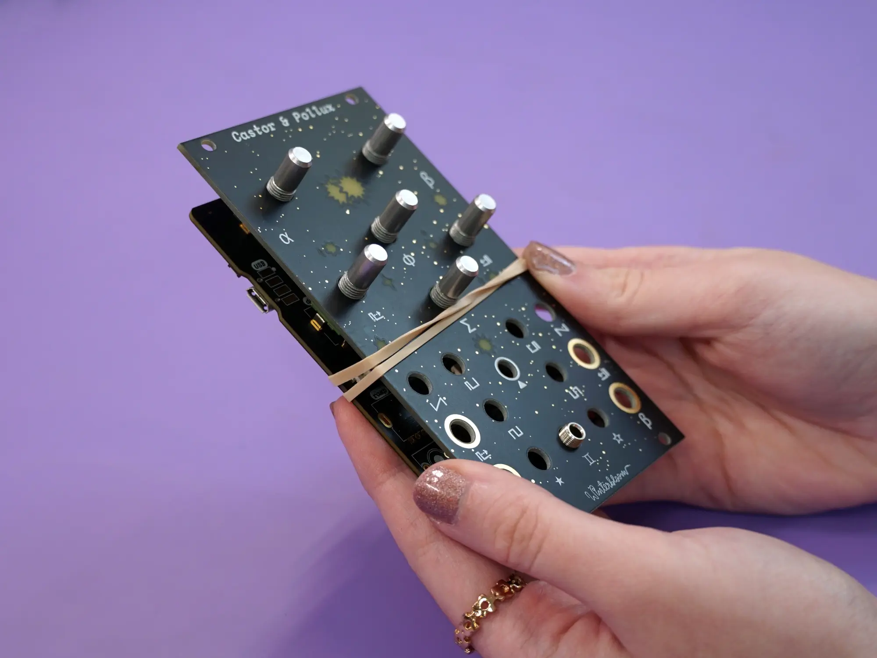
[picture p26: user_guide/docs/images/kit/24 - rubber band.webp]
  
</winter-carousel>

Flip the whole thing upside-down and solder the pots and jack in place.

<winter-carousel>
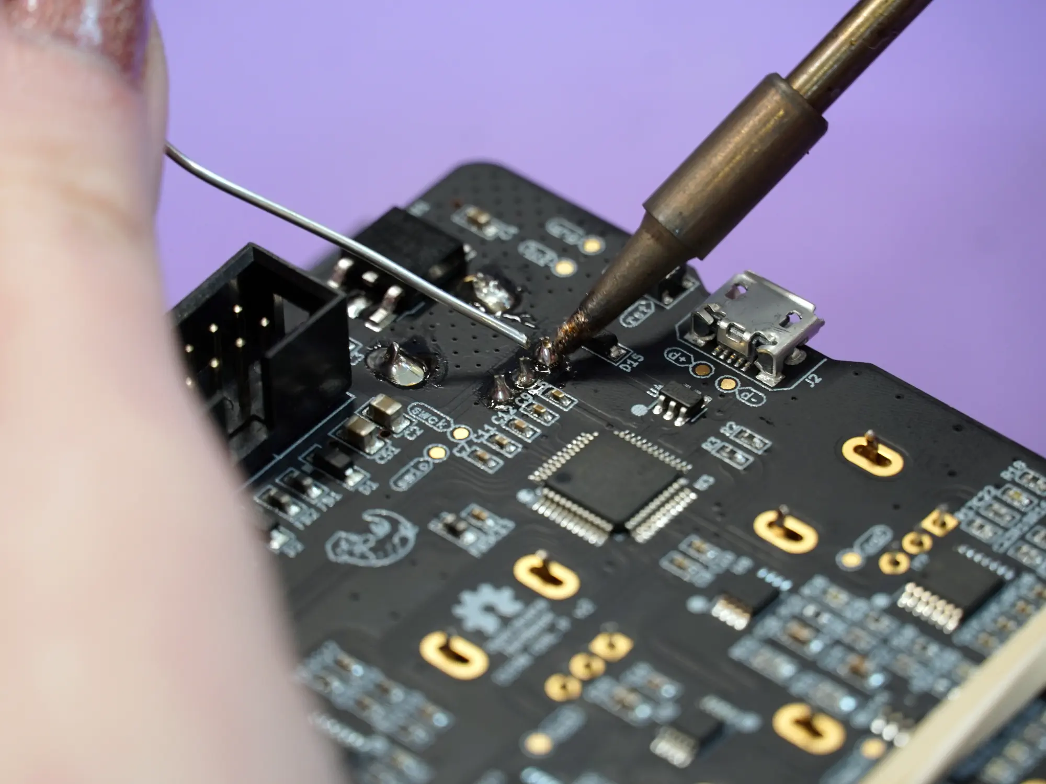
[picture p27: user_guide/docs/images/kit/25 - soldering.webp]
  
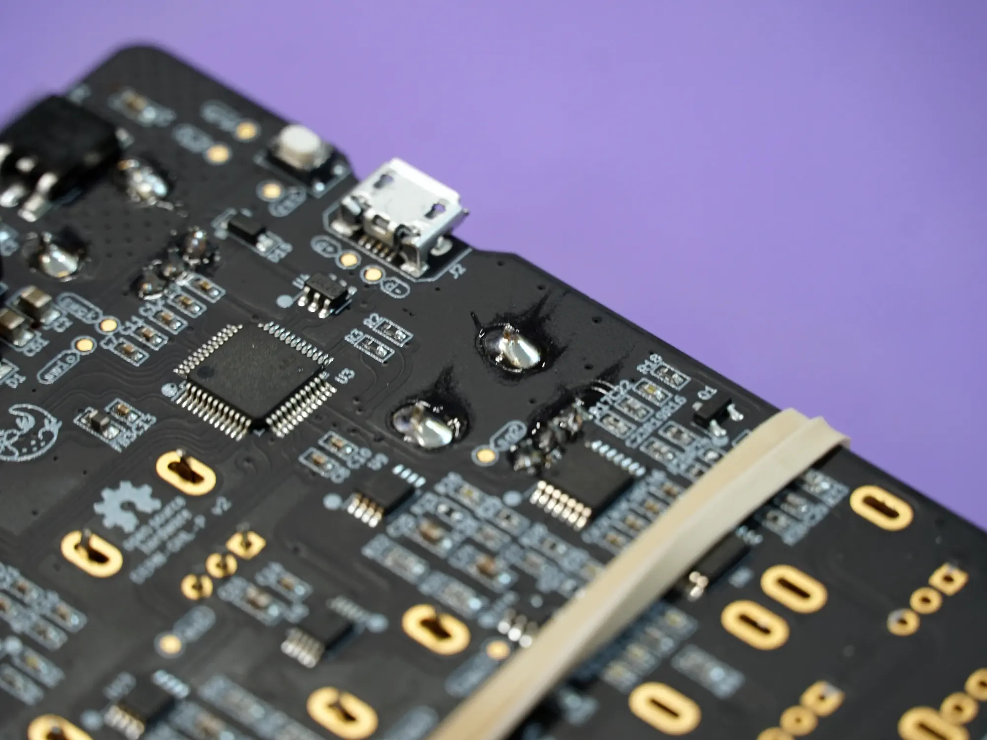
[picture p28: user_guide/docs/images/kit/26 - soldering.webp]
  
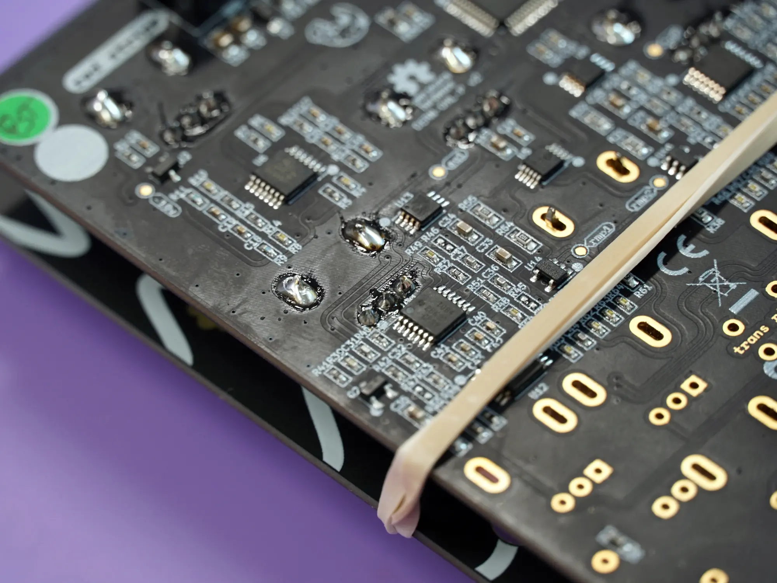
[picture p29: user_guide/docs/images/kit/27 - soldering.webp]
  
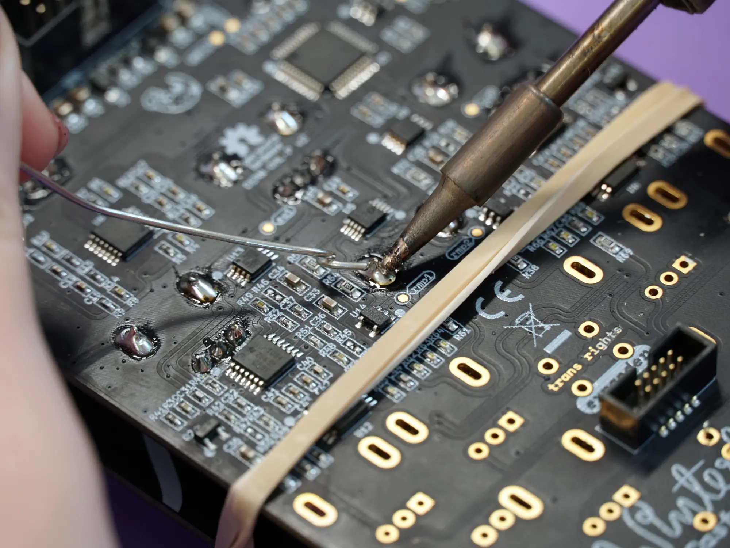
[picture p30: user_guide/docs/images/kit/28 - soldering.webp]
  
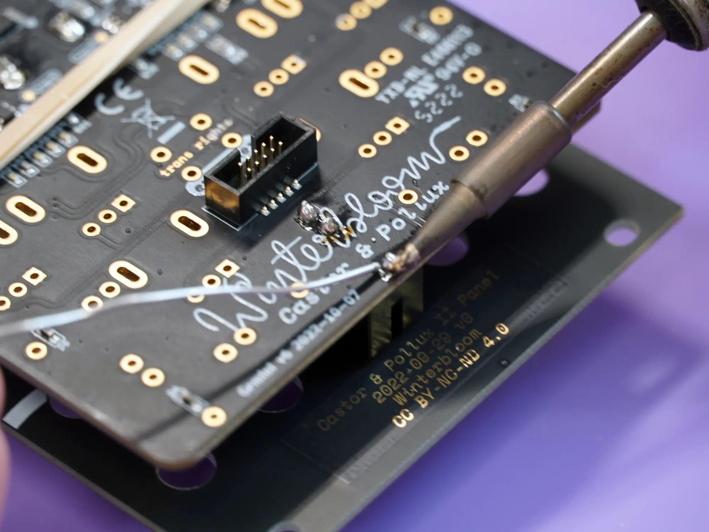
[picture p31: user_guide/docs/images/kit/29 - soldering jack.webp]
  
</winter-carousel>

!!! warning
    Take extra care not to hit any of the surface mount components with your iron.

Next, flip the assembly rightside-up and remove the rubber bands and faceplate.

Removing the faceplate

Finally, solder the legs of the modified pot to the pads on the board. Take care not to accidentally bridge the legs together. If you find that the legs are misaligned, you can flip the board back over and melt the solder on the mounting legs and twist it back into alignment.

<winter-carousel>
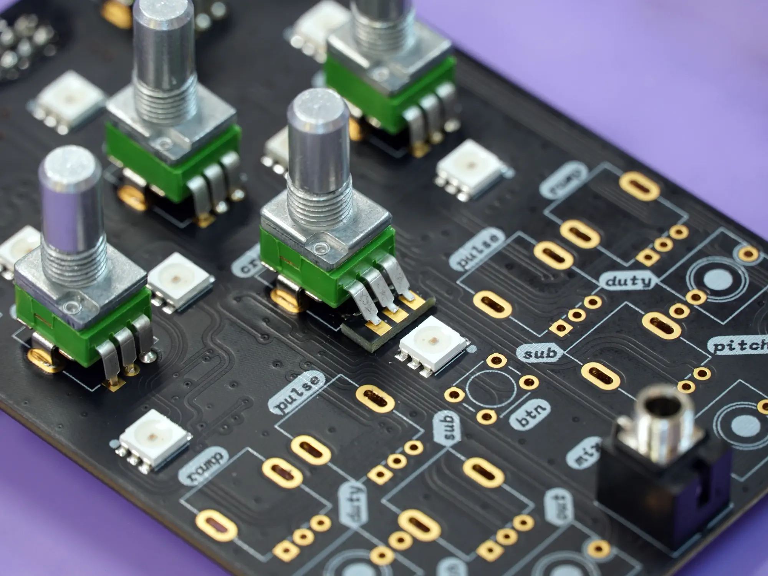
[picture p32: user_guide/docs/images/kit/31 - special pot.webp]
  
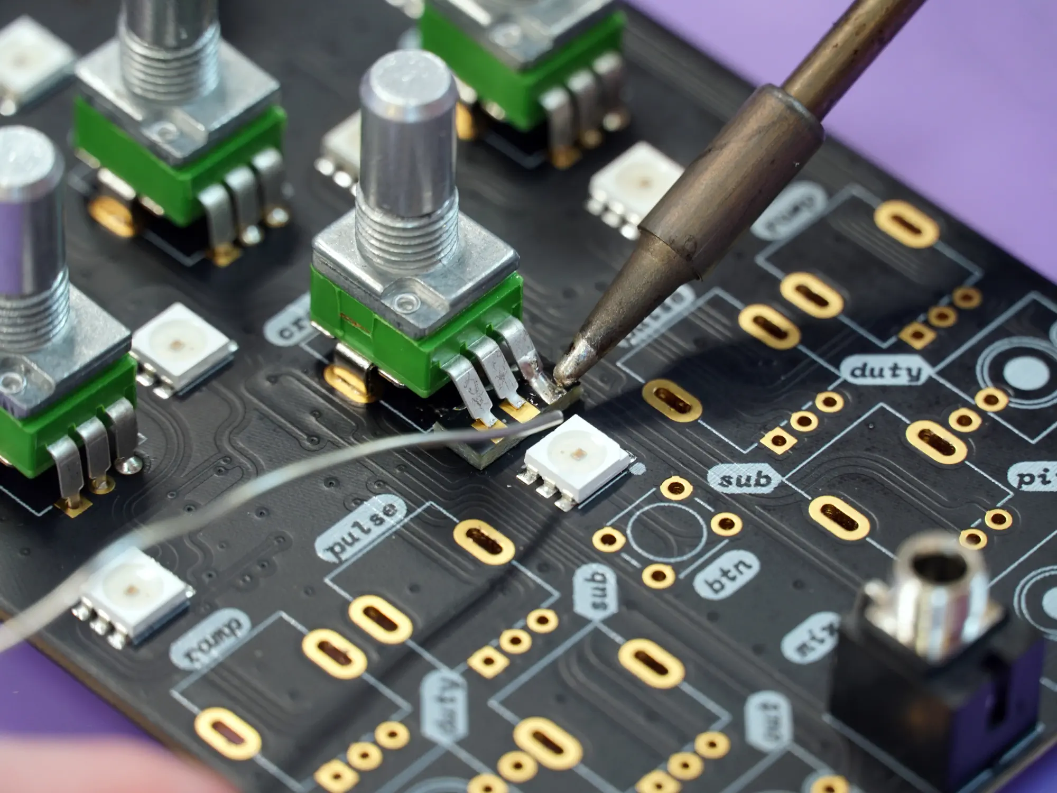
[picture p33: user_guide/docs/images/kit/32 - soldering special pot.webp]
  
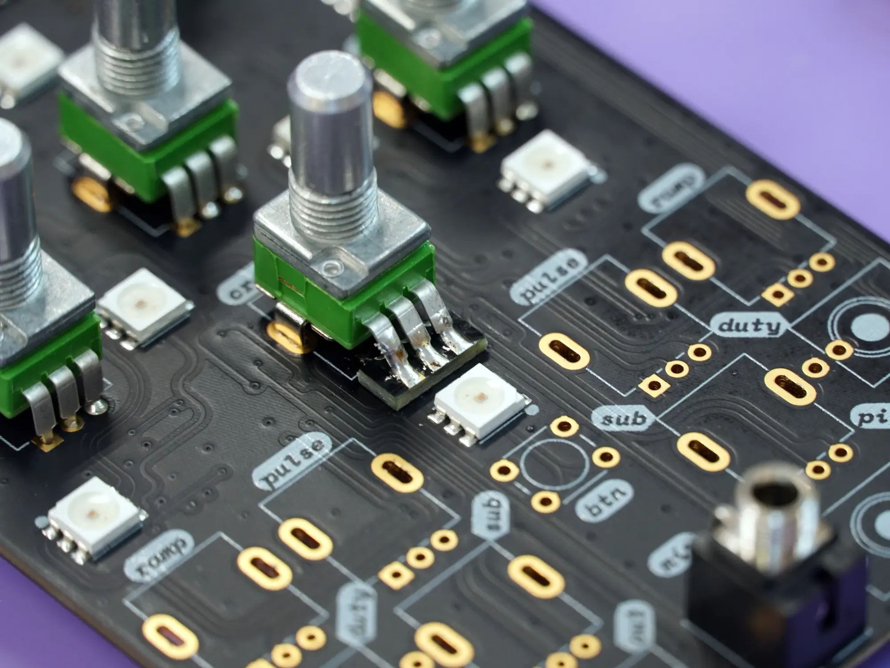
[picture p34: user_guide/docs/images/kit/33 - soldering special pot.webp]
  
</winter-carousel>

## Tactile switch

Next up is the tactile switch and its cap.

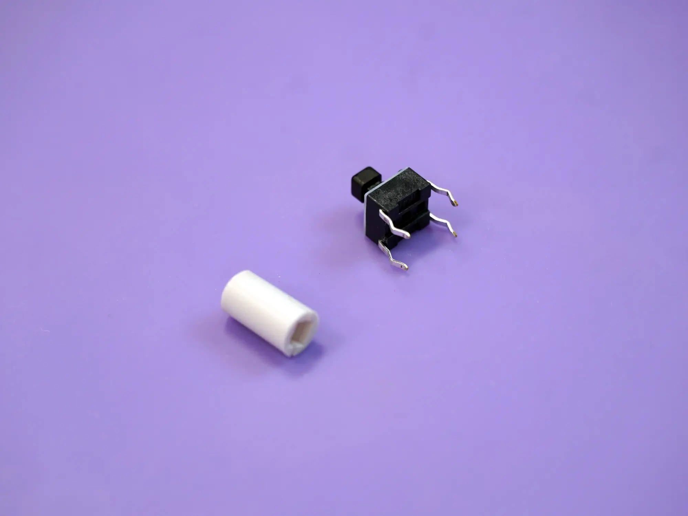
[picture p35: user_guide/docs/images/kit/34 - button.webp]
Tactile switch and cap


Place the tactile switch on the spot labeled `btn` on the mainboard. Make sure it's fully inserted against the board.

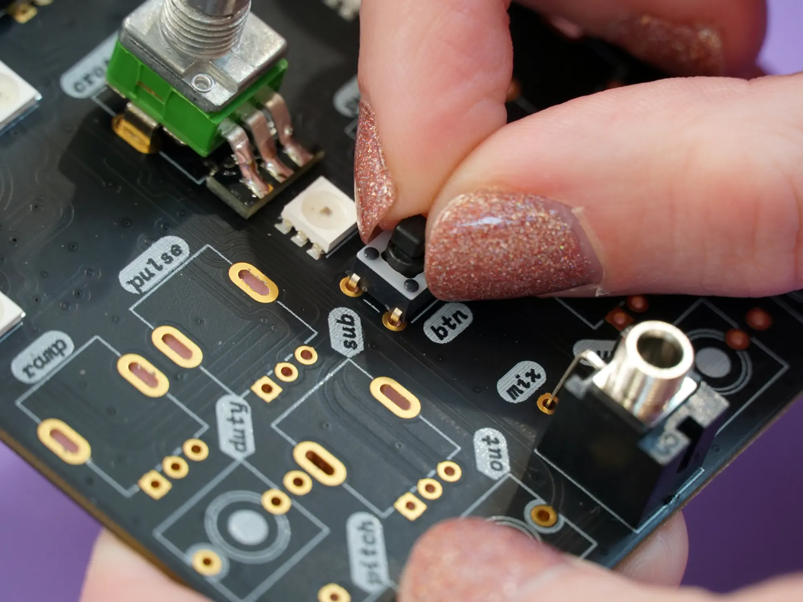
[picture p36: user_guide/docs/images/kit/35 - button.webp]
Tactile switch placed


Next, place the cap on top of the tactile switch and press in firmly to completely seat it on the switch.

<winter-carousel>
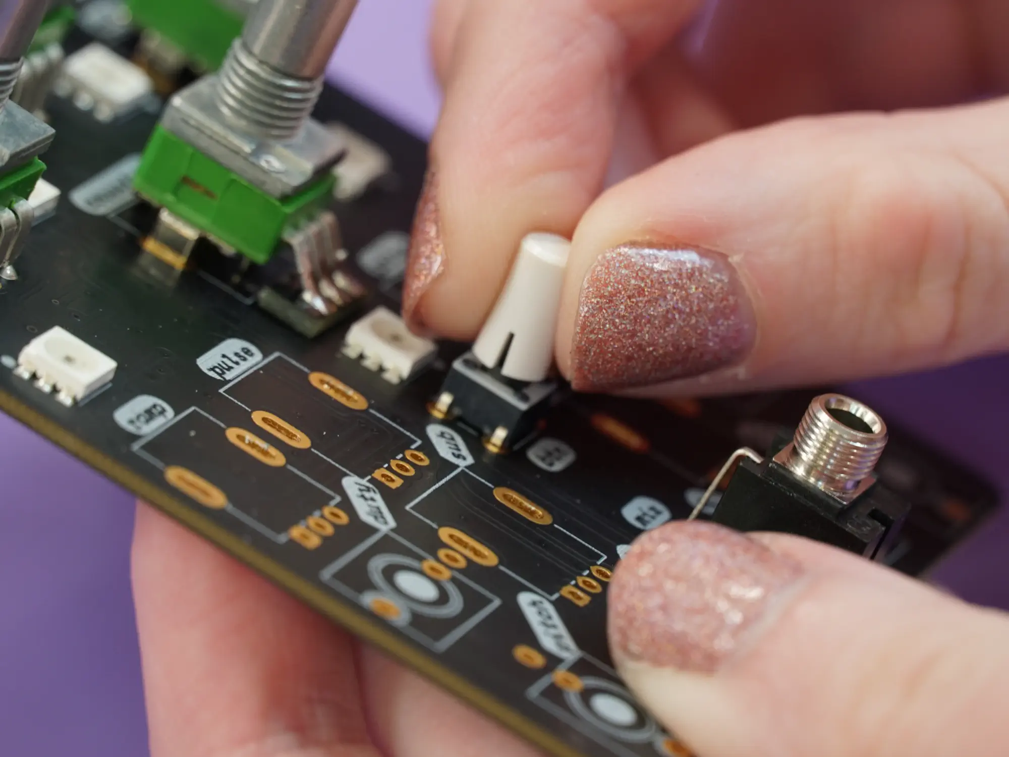
[picture p37: user_guide/docs/images/kit/36 - button.webp]
  
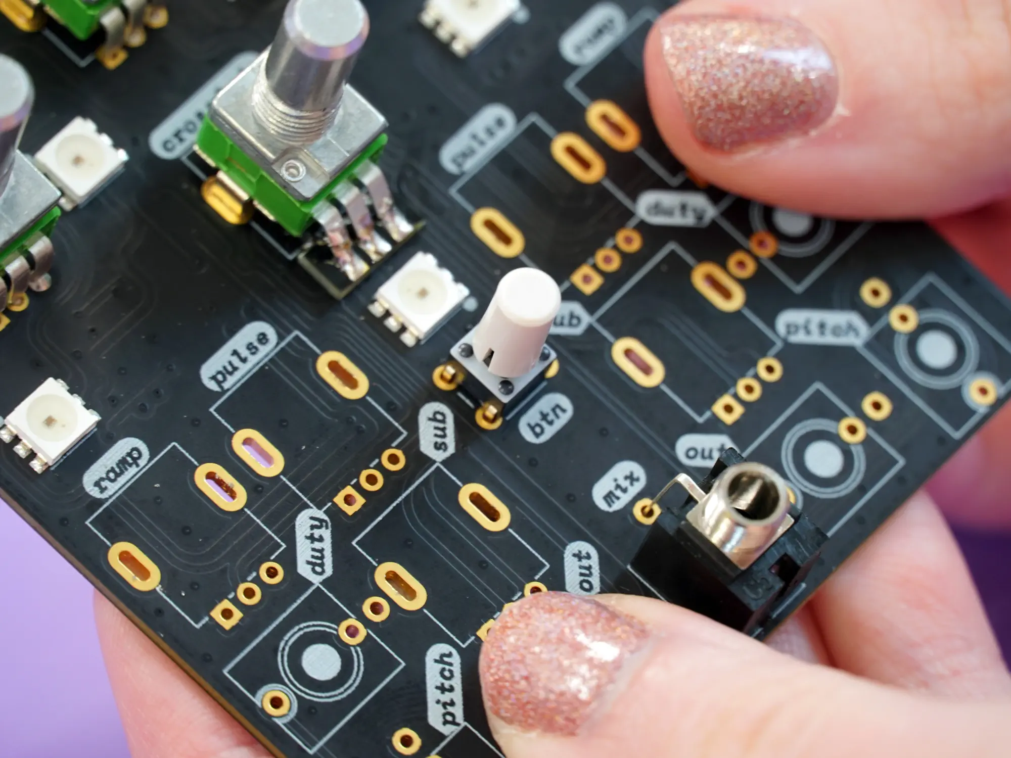
[picture p38: user_guide/docs/images/kit/37 - button.webp]
  
</winter-carousel>

## Jacks and trimpots

Next up is all six trimpots and six of the 1/8" jacks.

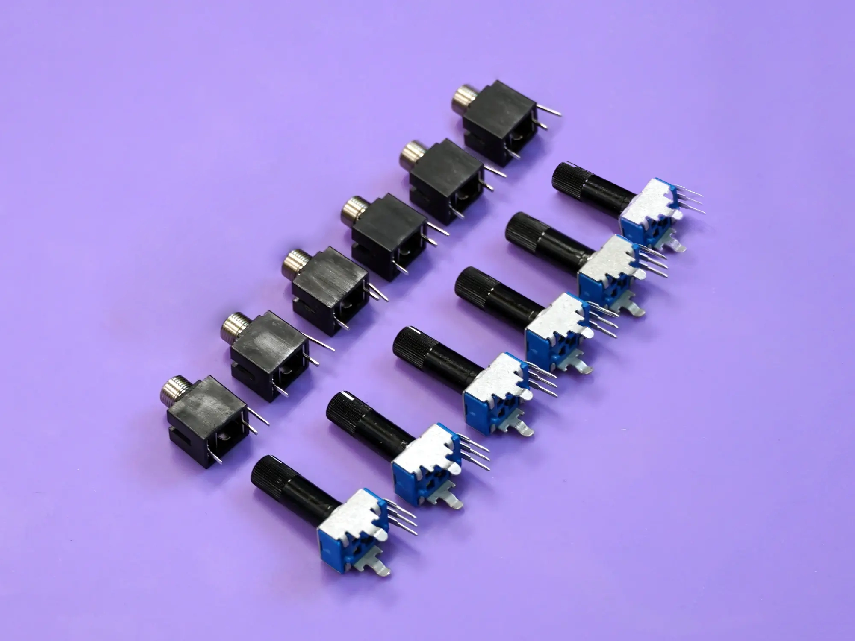
[picture p39: user_guide/docs/images/kit/38 - jacks and pots.webp]
Jacks and trimpots


Start from the **right** side of the board and place the pots and jacks for `ramp`, `pulse`, `duty`, `sub`, `pitch`, and `out`.

<winter-carousel>
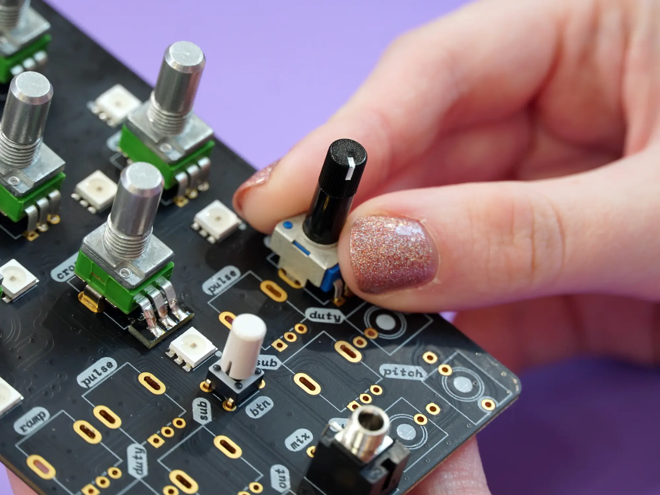
[picture p40: user_guide/docs/images/kit/39 - trimpots.webp]
  
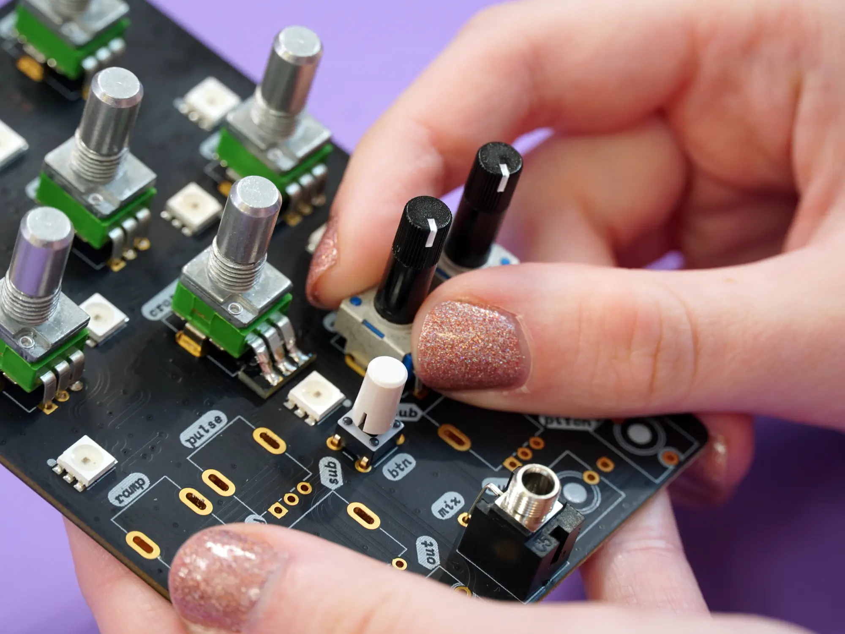
[picture p41: user_guide/docs/images/kit/40 - trimpots.webp]
  
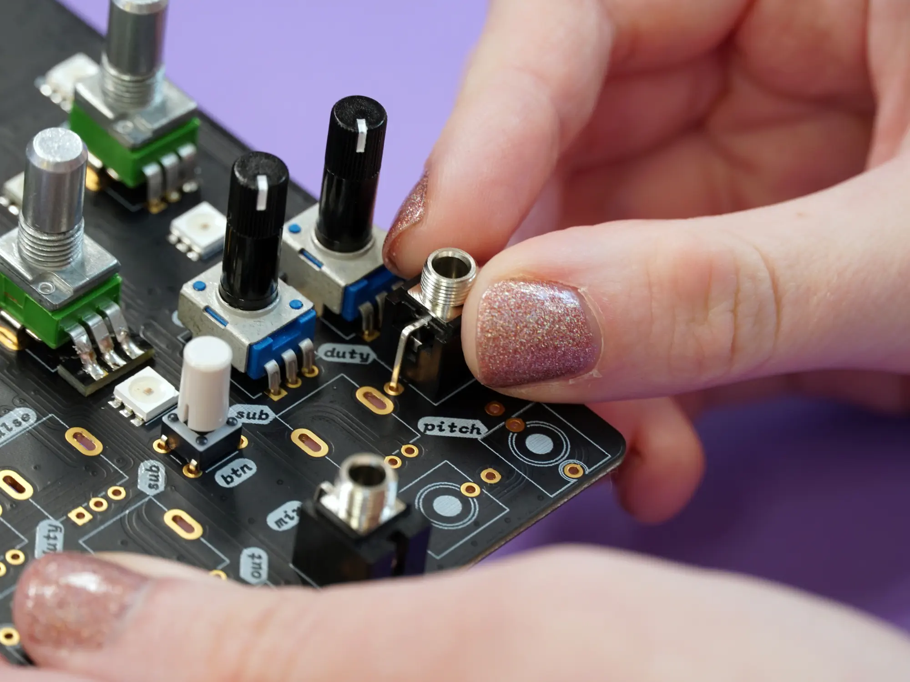
[picture p42: user_guide/docs/images/kit/41 - jacks.webp]
  
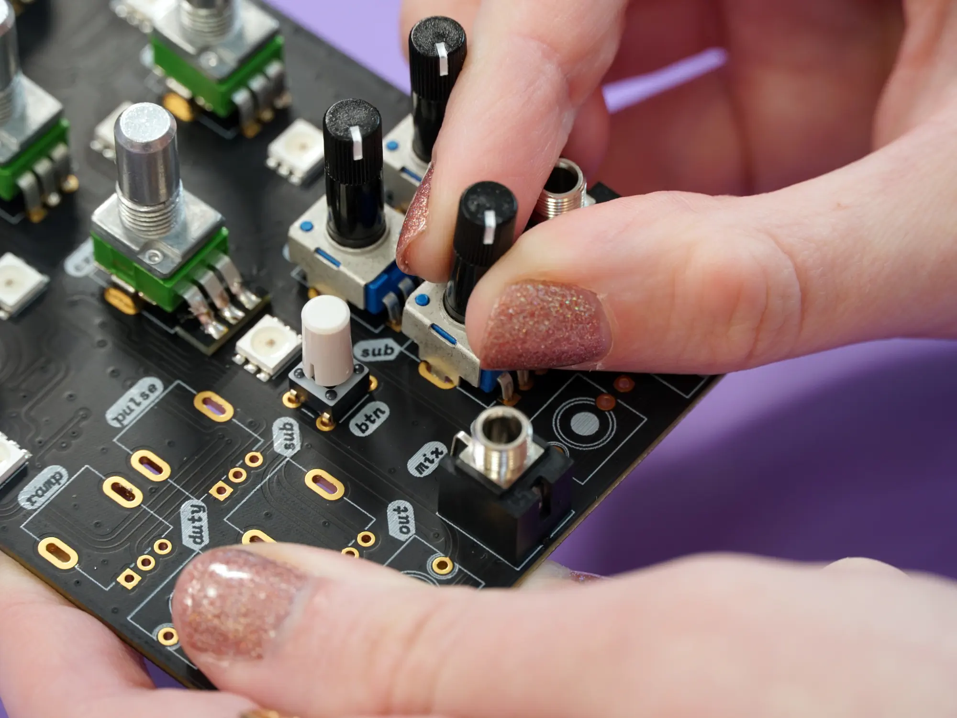
[picture p43: user_guide/docs/images/kit/42 - trimpots.webp]
  
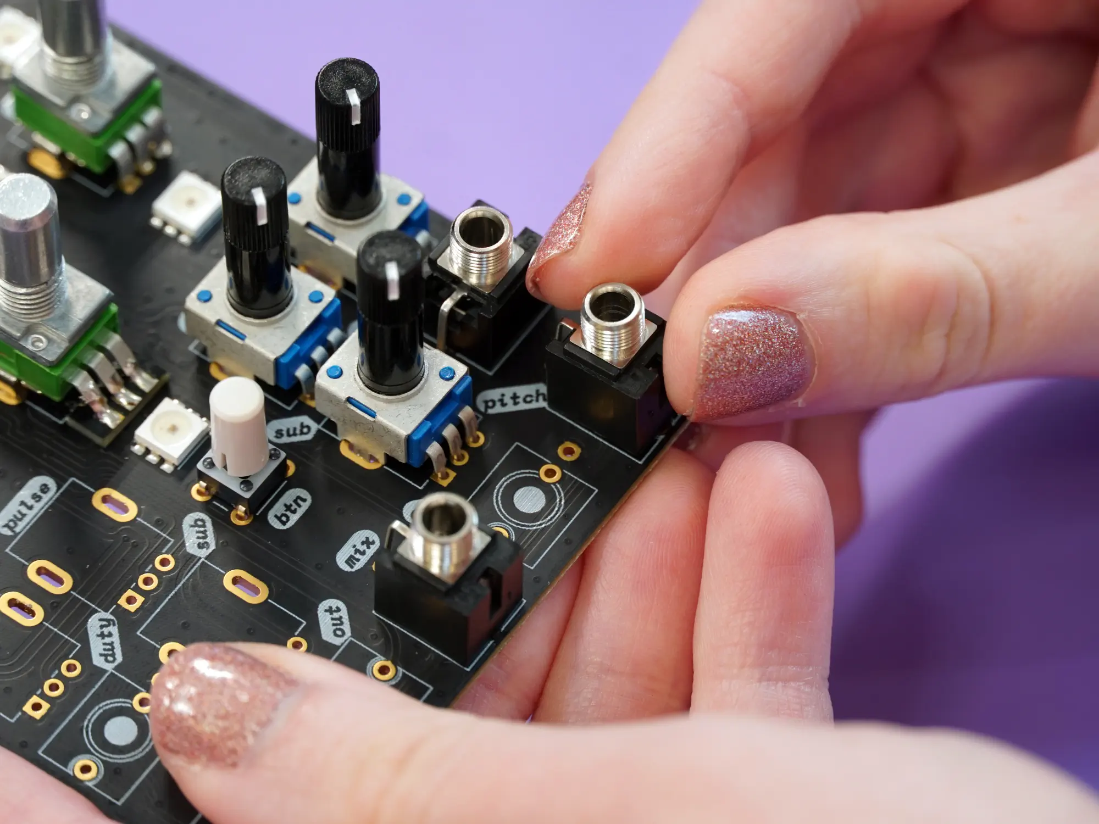
[picture p44: user_guide/docs/images/kit/43 - jacks.webp]
  
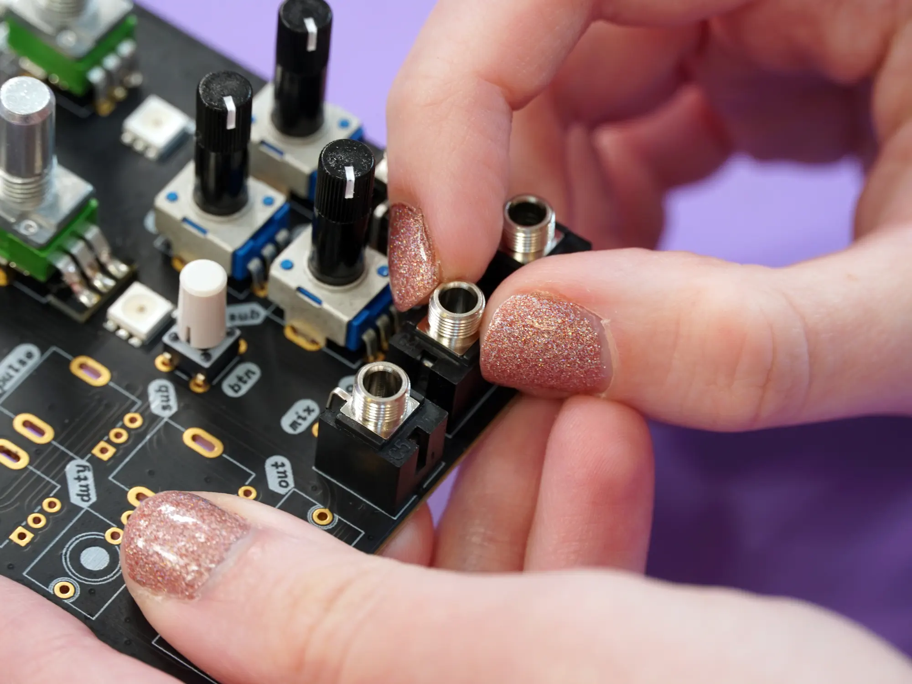
[picture p45: user_guide/docs/images/kit/44 - jacks.webp]
  
</winter-carousel>

Continue on the left side with the pots and jacks for `pulse`, `ramp`, `sub`, `duty`, `out`, and `pitch`.

<winter-carousel>
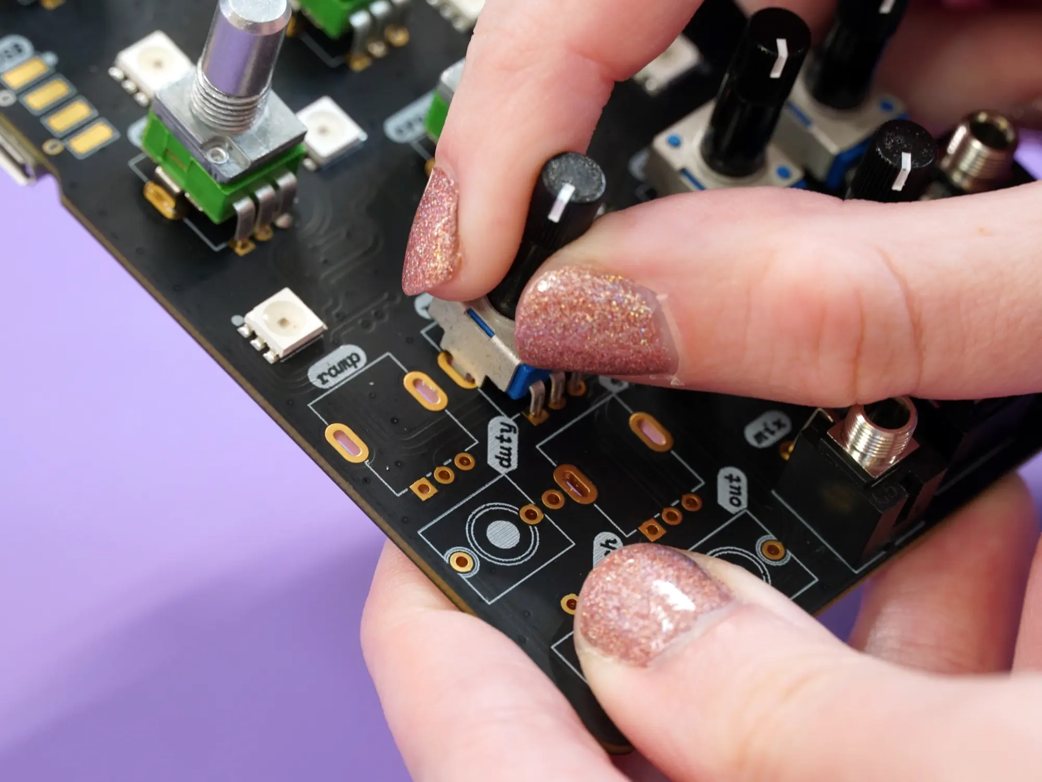
[picture p46: user_guide/docs/images/kit/45 - trimpots.webp]
  
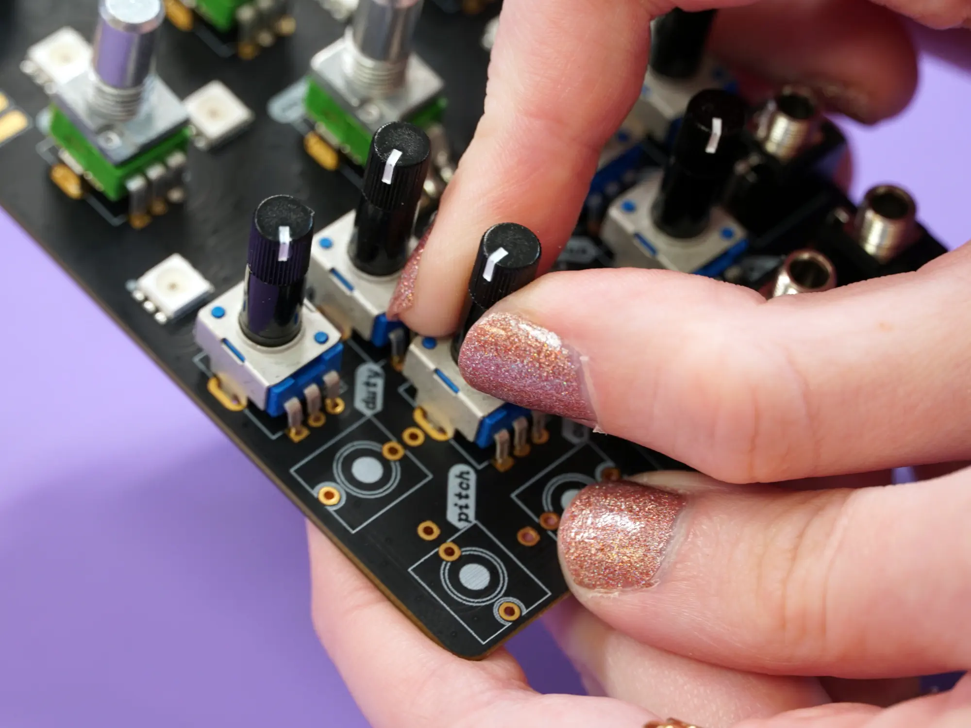
[picture p47: user_guide/docs/images/kit/46 - trimpots.webp]
  
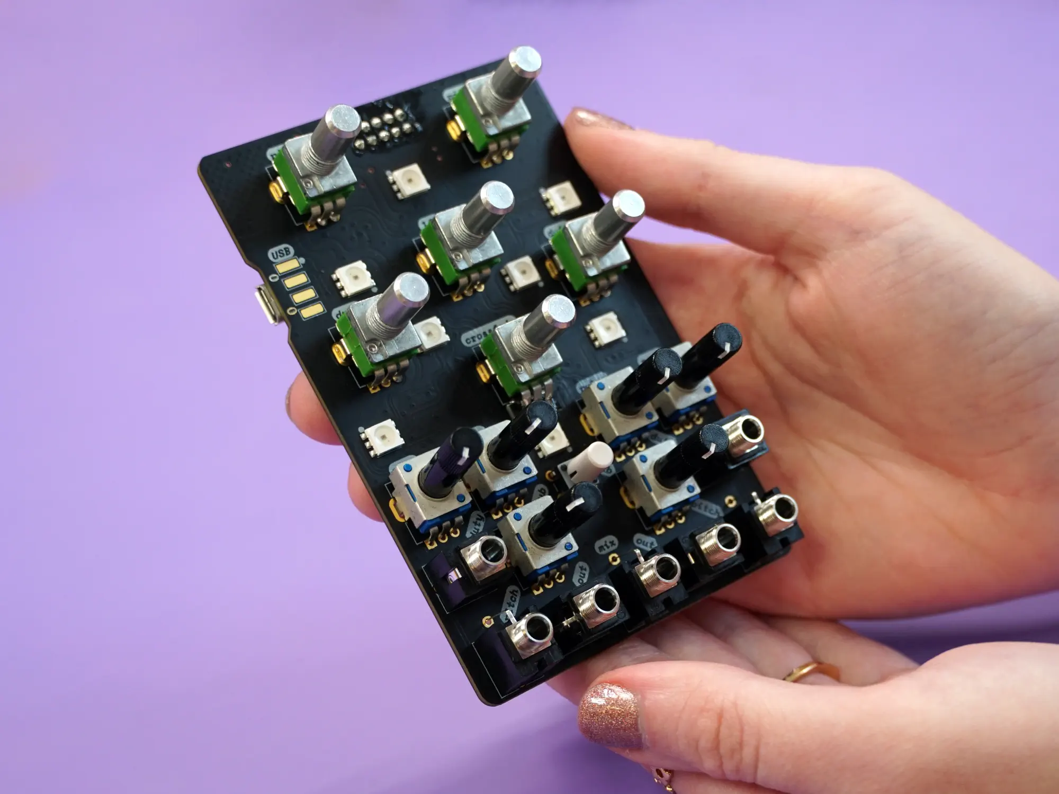
[picture p48: user_guide/docs/images/kit/47 - placements.webp]
  
</winter-carousel>

Next, place the faceplate and rubber band just as you did earlier.

<winter-carousel>
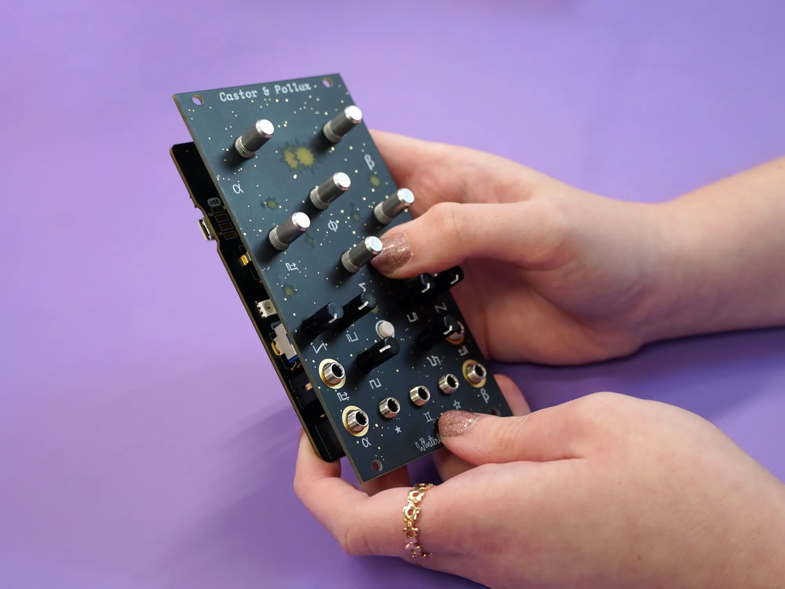
[picture p49: user_guide/docs/images/kit/48 - panel.webp]
  
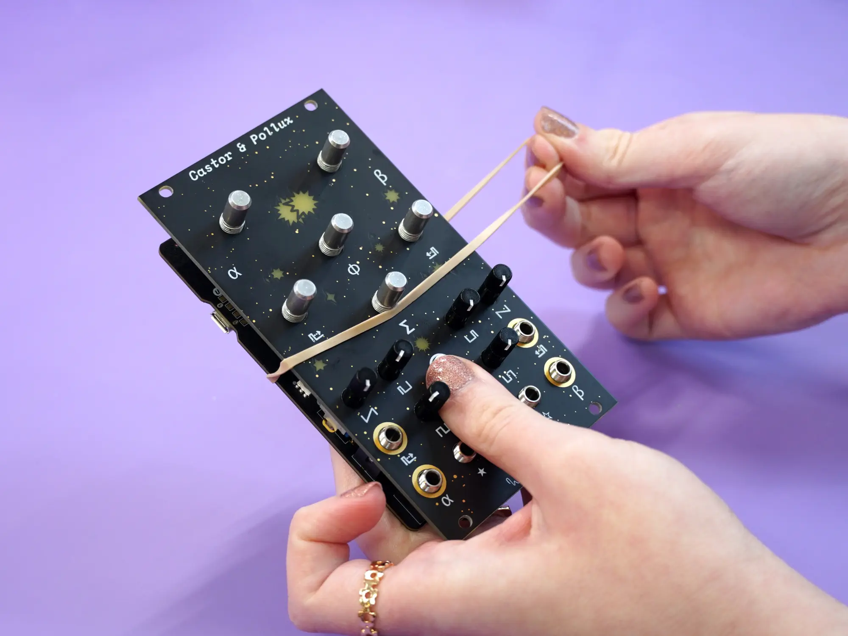
[picture p50: user_guide/docs/images/kit/49 - rubber band.webp]
  
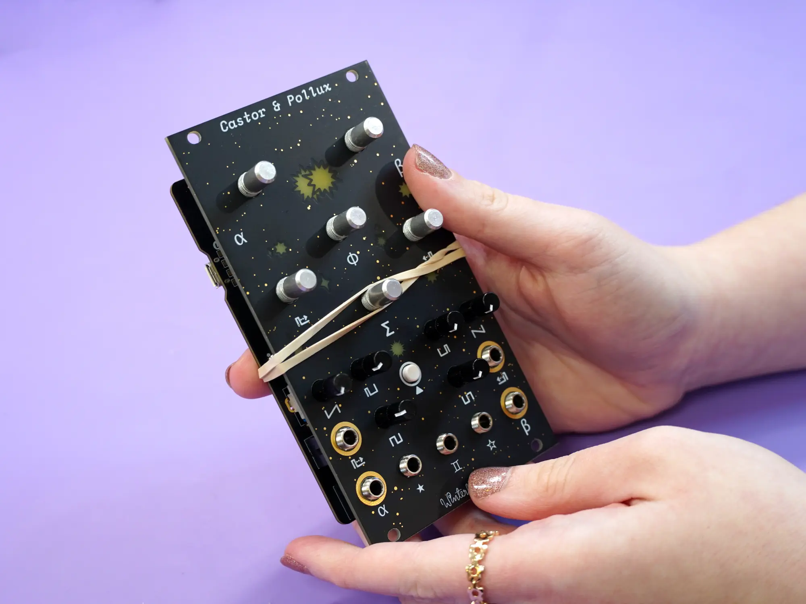
[picture p51: user_guide/docs/images/kit/50 - rubber band.webp]
  
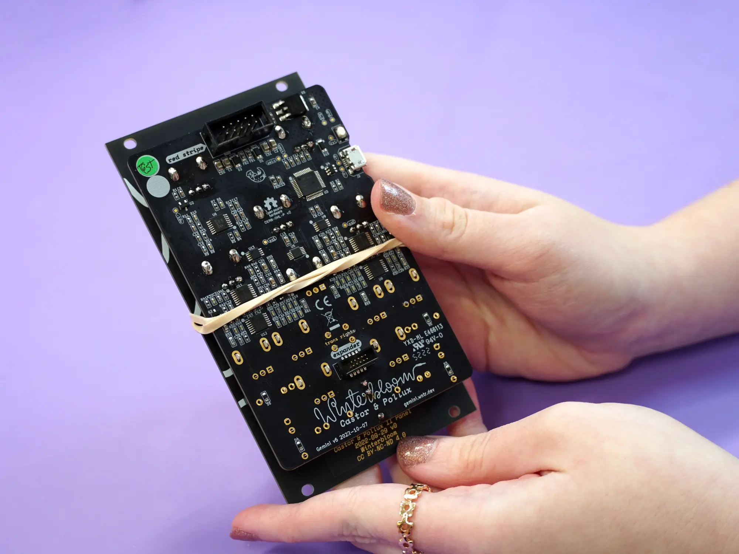
[picture p52: user_guide/docs/images/kit/51 - rubber band.webp]
  
</winter-carousel>

Flip the module upside-down and solder the pots and jacks into place.

<winter-carousel>
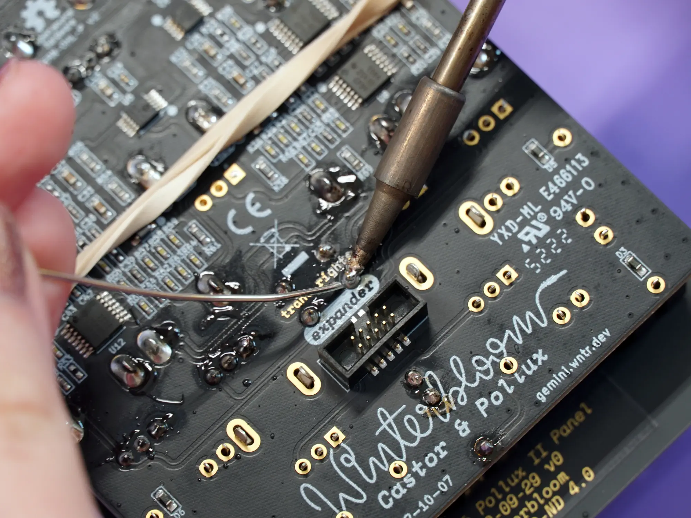
[picture p53: user_guide/docs/images/kit/52 - soldering.webp]
  
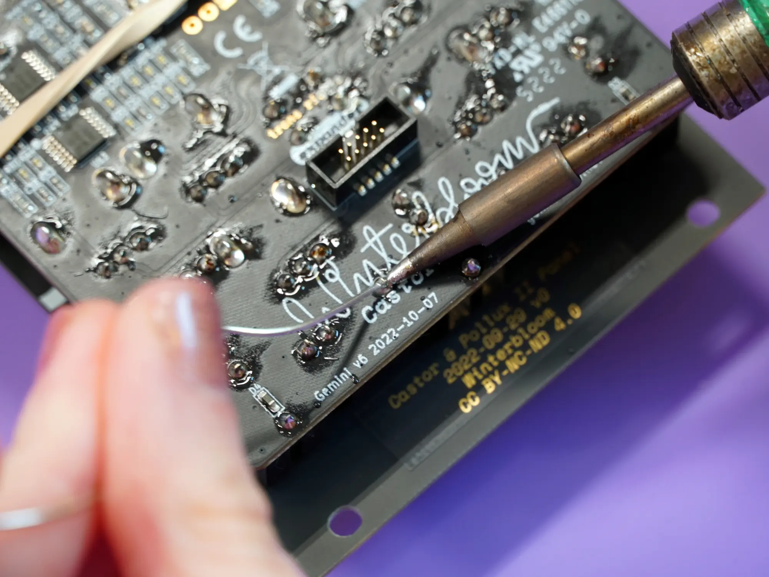
[picture p54: user_guide/docs/images/kit/53 - soldering.webp]
  
</winter-carousel>

## Nuts

Now that everything is soldered in place the next step is to secure the faceplate using nuts. Start with the six larger nuts and washers for the 9mm pots.

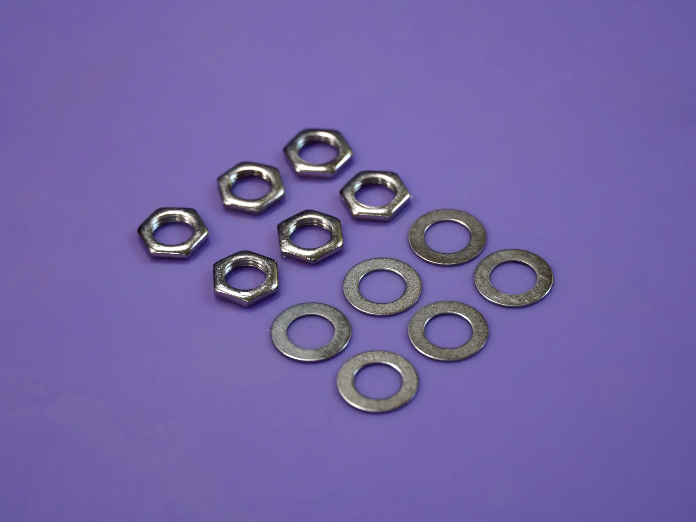
[picture p55: user_guide/docs/images/kit/54 - nuts and washers.webp]
9mm pot nuts and washers


Place a washer on the shaft of each of the six 9mm pots.

<winter-carousel>
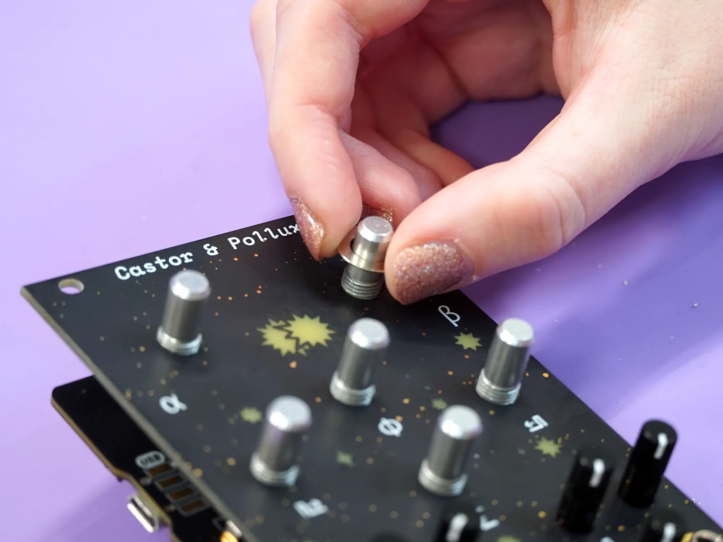
[picture p56: user_guide/docs/images/kit/55 - washer.webp]
  
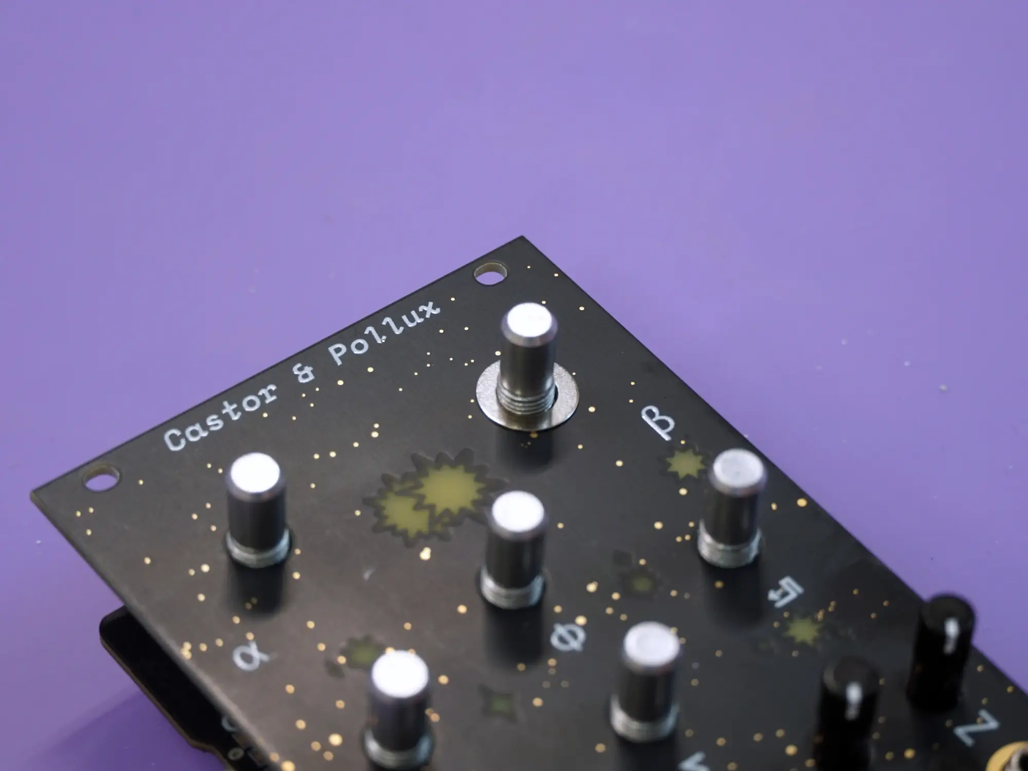
[picture p57: user_guide/docs/images/kit/56 - washer.webp]
  
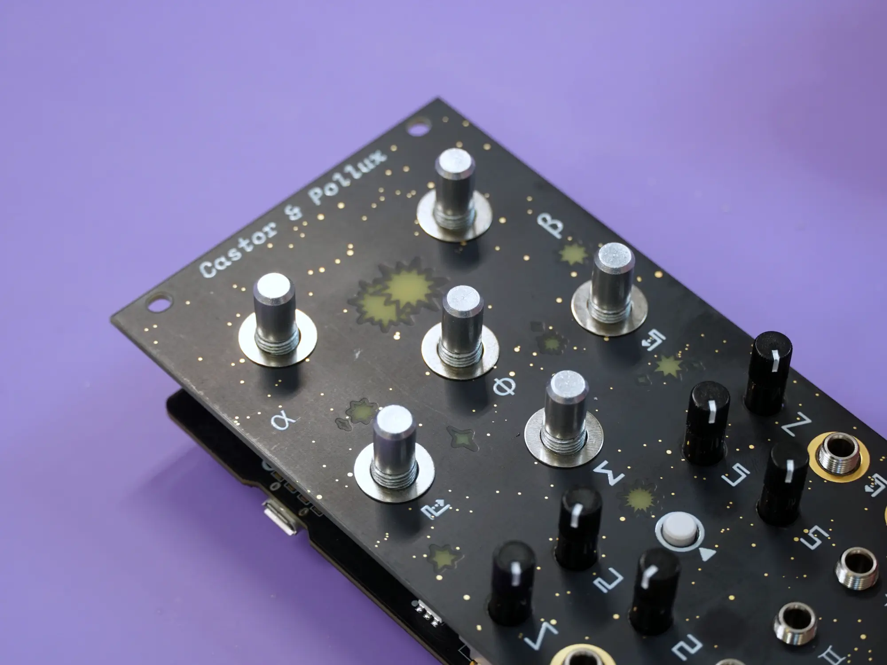
[picture p58: user_guide/docs/images/kit/57 - washers.webp]
  
</winter-carousel>

With the washers in place, place the nuts onto the shafts and tighten them in place.

<winter-carousel>
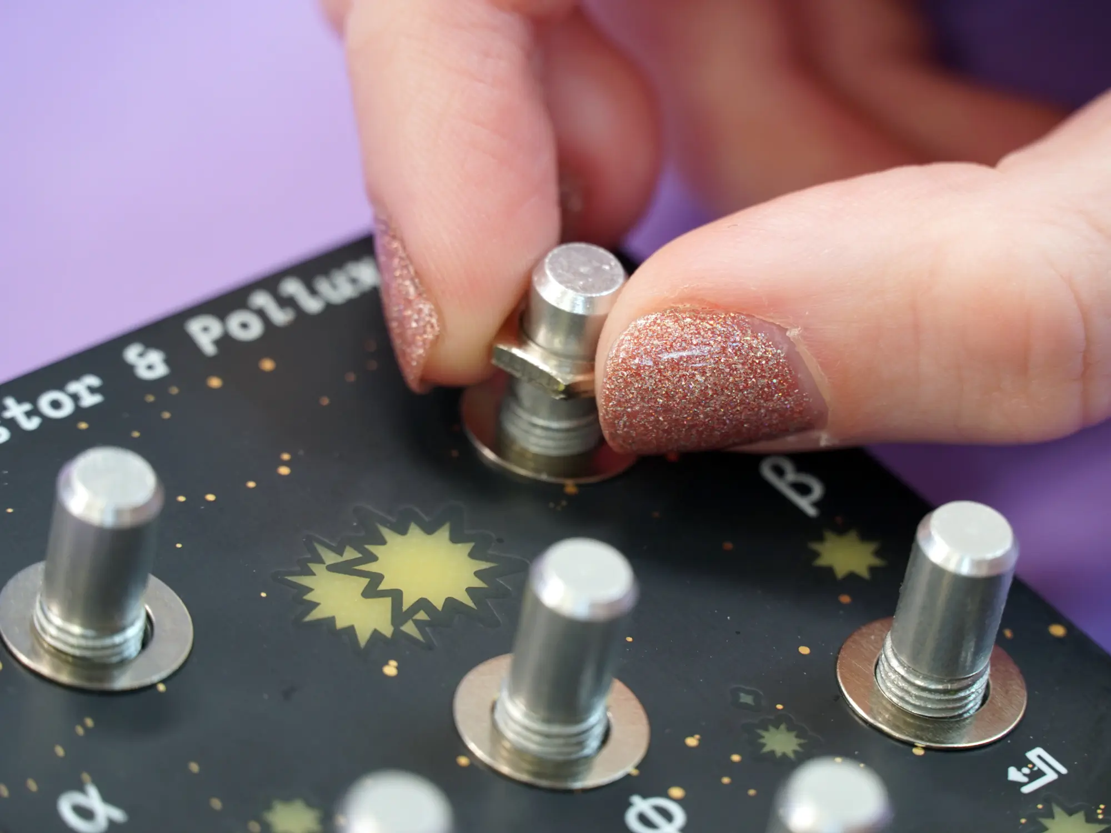
[picture p59: user_guide/docs/images/kit/58 - nut.webp]
  
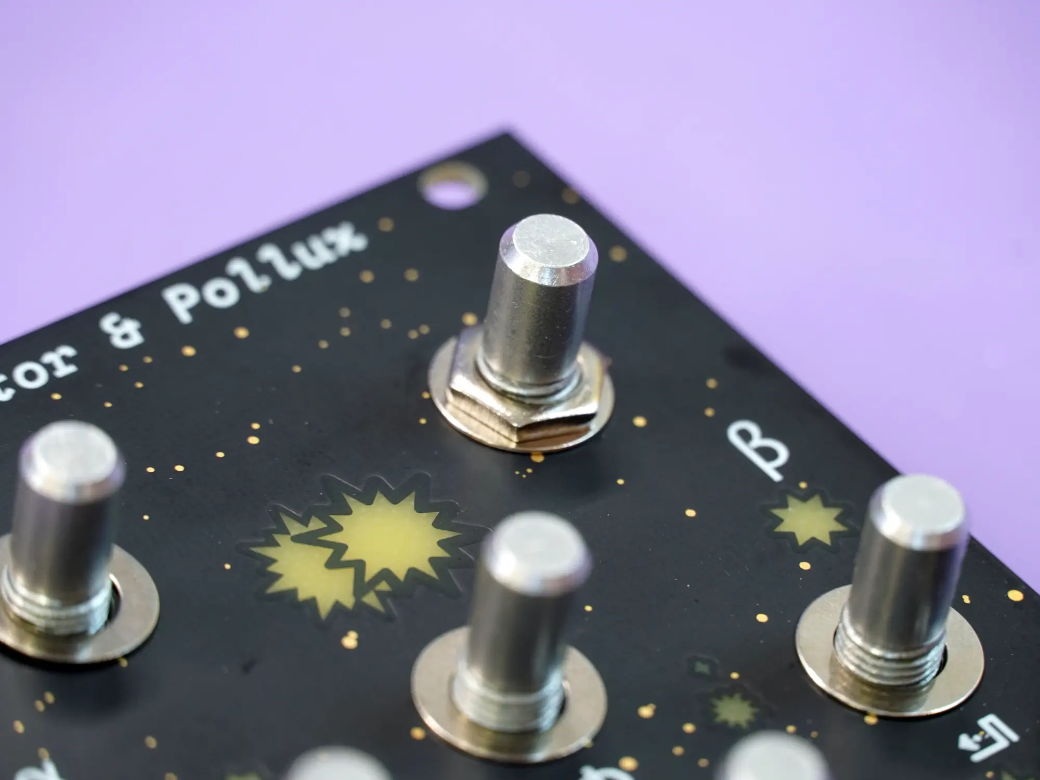
[picture p60: user_guide/docs/images/kit/59 - nut.webp]
  
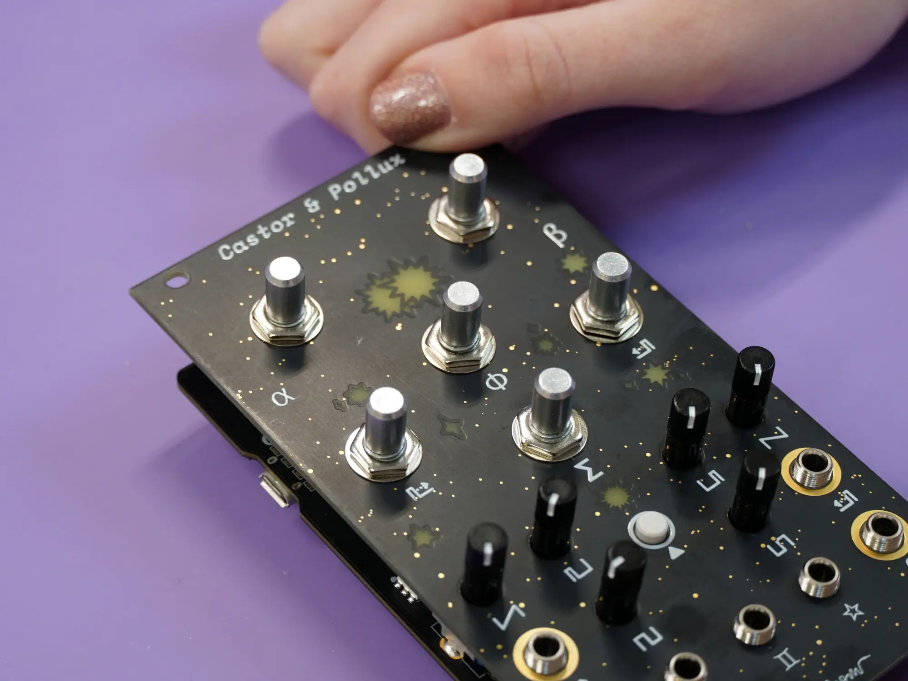
[picture p61: user_guide/docs/images/kit/60 - nuts.webp]
  
</winter-carousel>

Next up is the seven hex nuts for the 1/8 jacks.

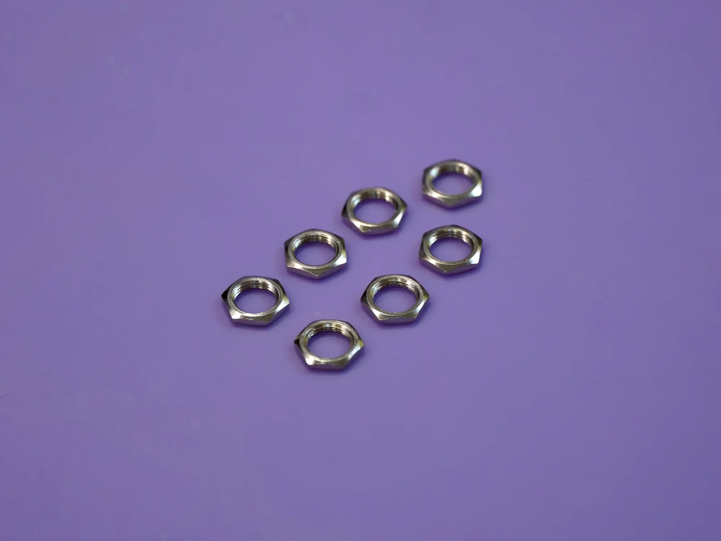
[picture p62: user_guide/docs/images/kit/61 - nuts.webp]
Hex nuts for 1/8" jacks


Place the nuts on each jack and tighten them in place.

<winter-carousel>
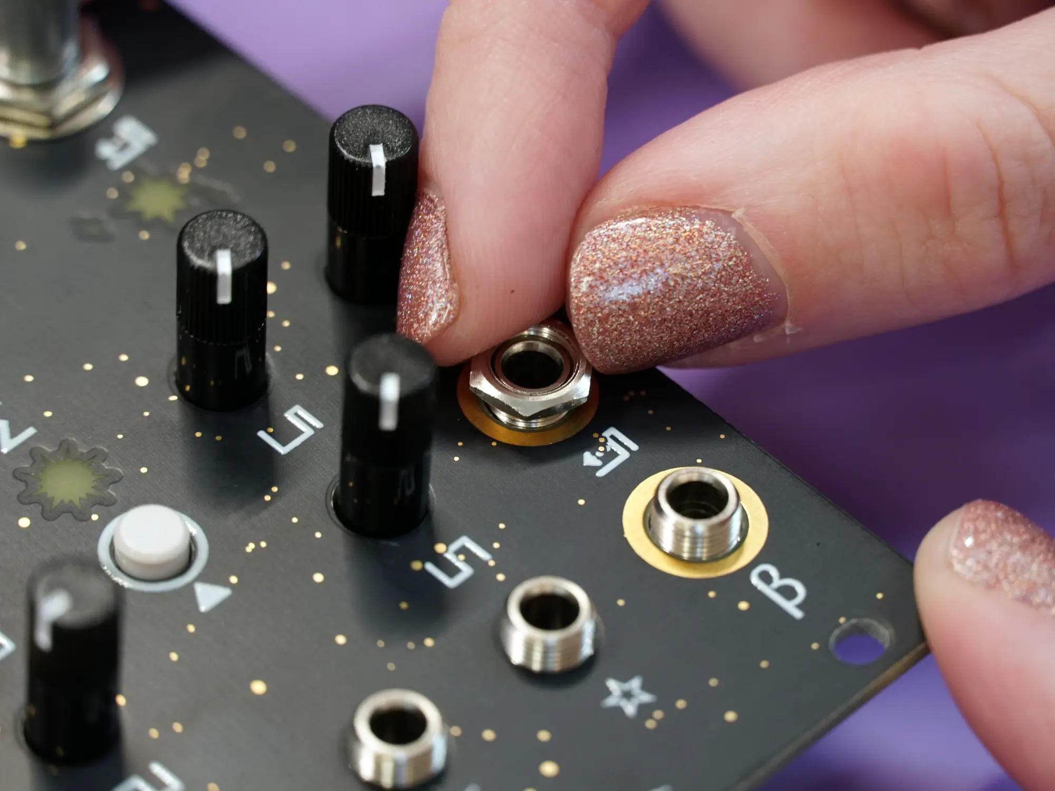
[picture p63: user_guide/docs/images/kit/62 - nut.webp]
  
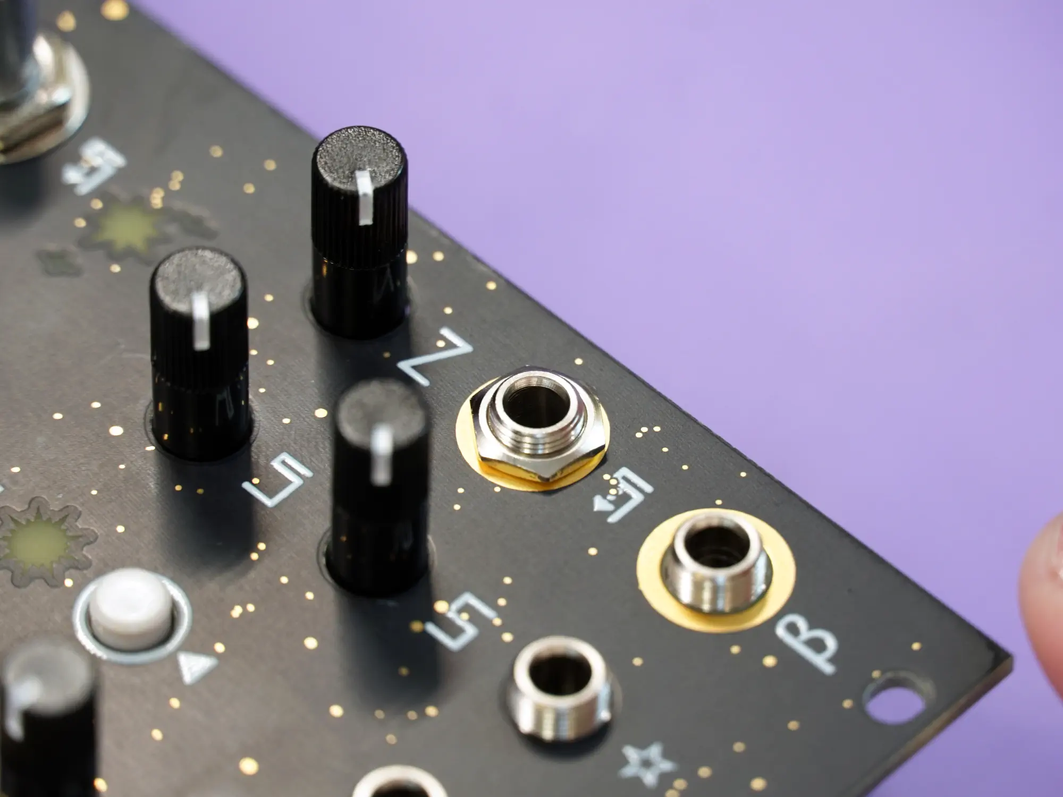
[picture p64: user_guide/docs/images/kit/63 - nut.webp]
  
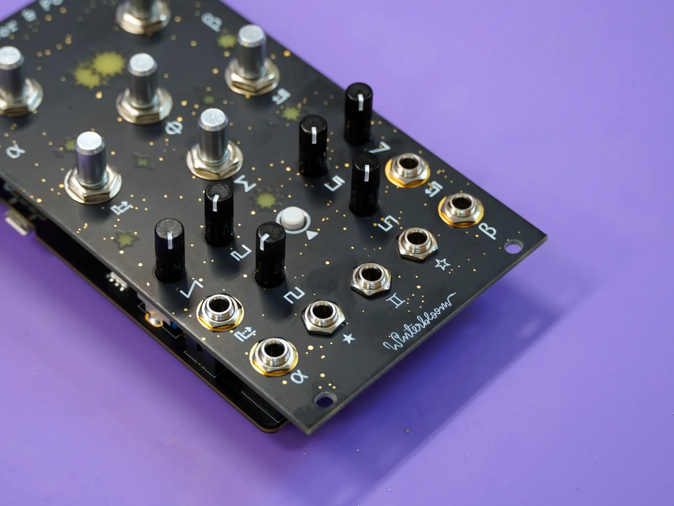
[picture p65: user_guide/docs/images/kit/64 - nuts.webp]
  
</winter-carousel>

## Knobs

The final step for the main module is attaching the six knobs.

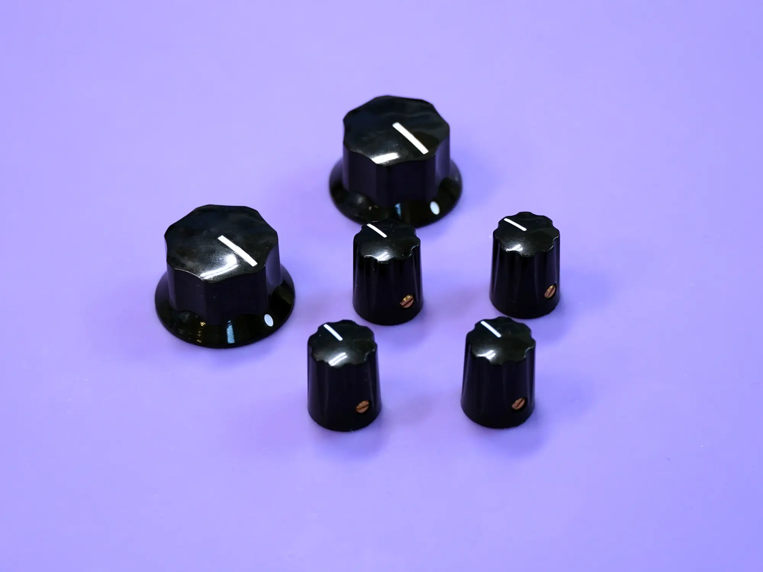
[picture p66: user_guide/docs/images/kit/65 - knobs.webp]
Two large knobs and two small knobs


Start by loosening the set screw on each of the knobs using a small flat head screwdriver.

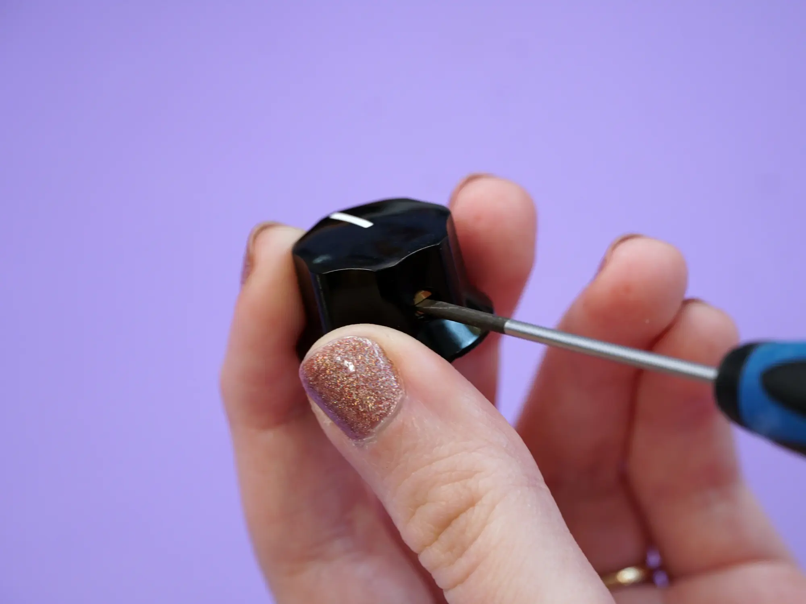
[picture p67: user_guide/docs/images/kit/66 - knob.webp]
Loosening the set screw


Next, turn all of the potentiometers fully counterclockwise. Place the two large knobs on the top two shafts with the indicator line at the 7 o' clock position. Tighten the set screws to secure the knobs in place.

<winter-carousel>
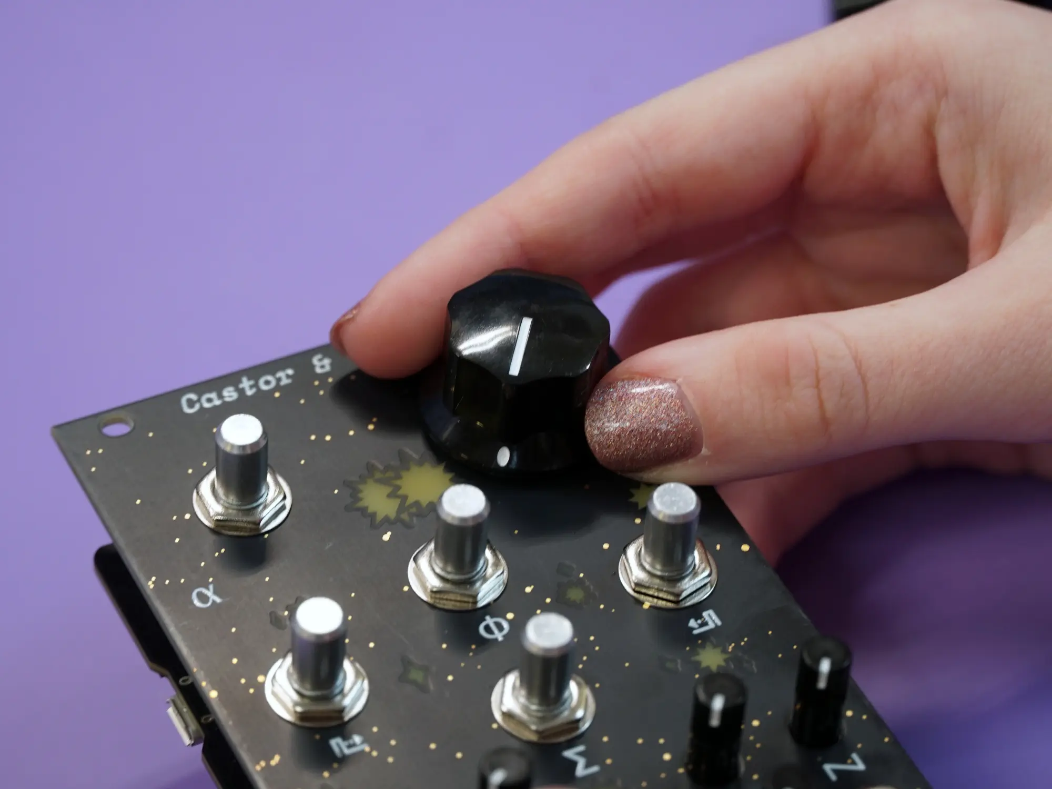
[picture p68: user_guide/docs/images/kit/67 - knob.webp]
  
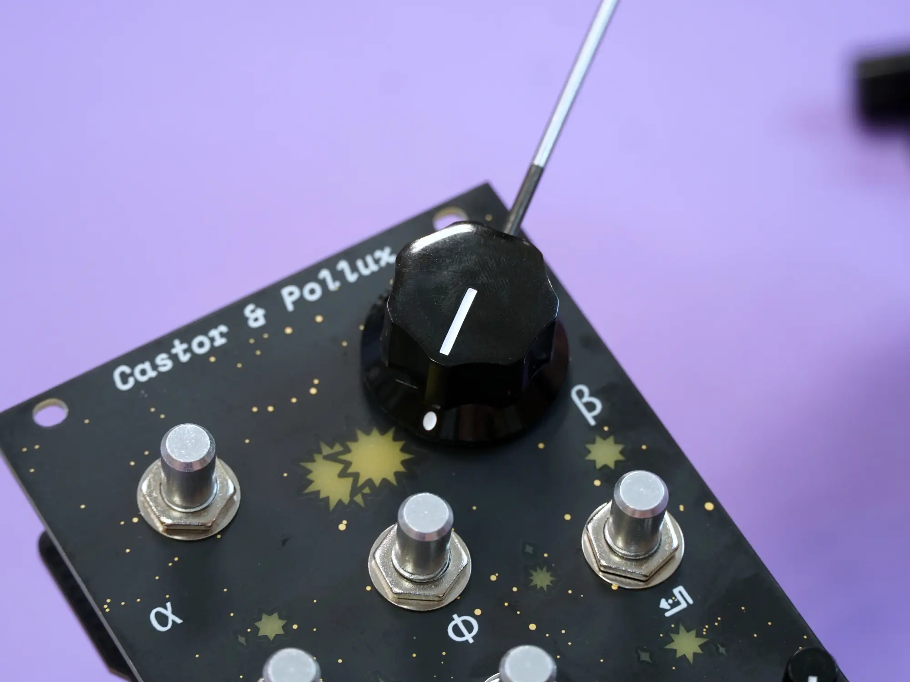
[picture p69: user_guide/docs/images/kit/68 - knob.webp]
  
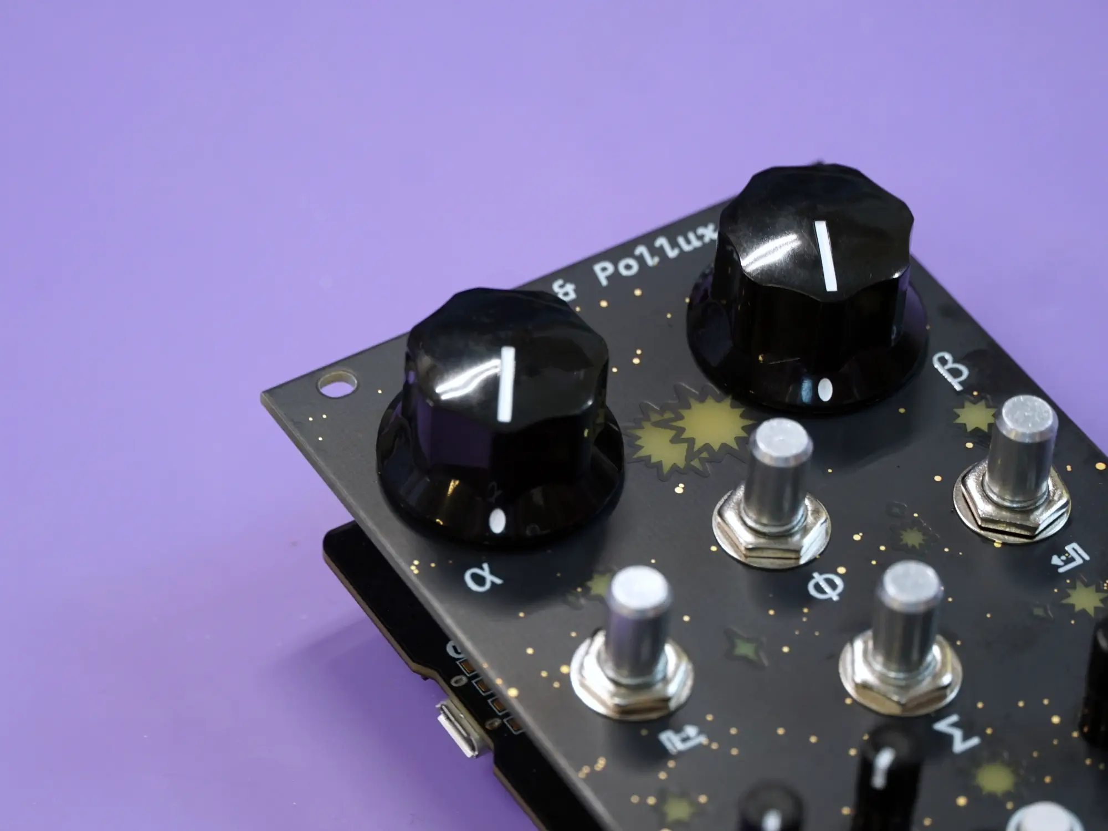
[picture p70: user_guide/docs/images/kit/69 - knobs.webp]
  
</winter-carousel>

Repeat the same process for the four smaller knobs.

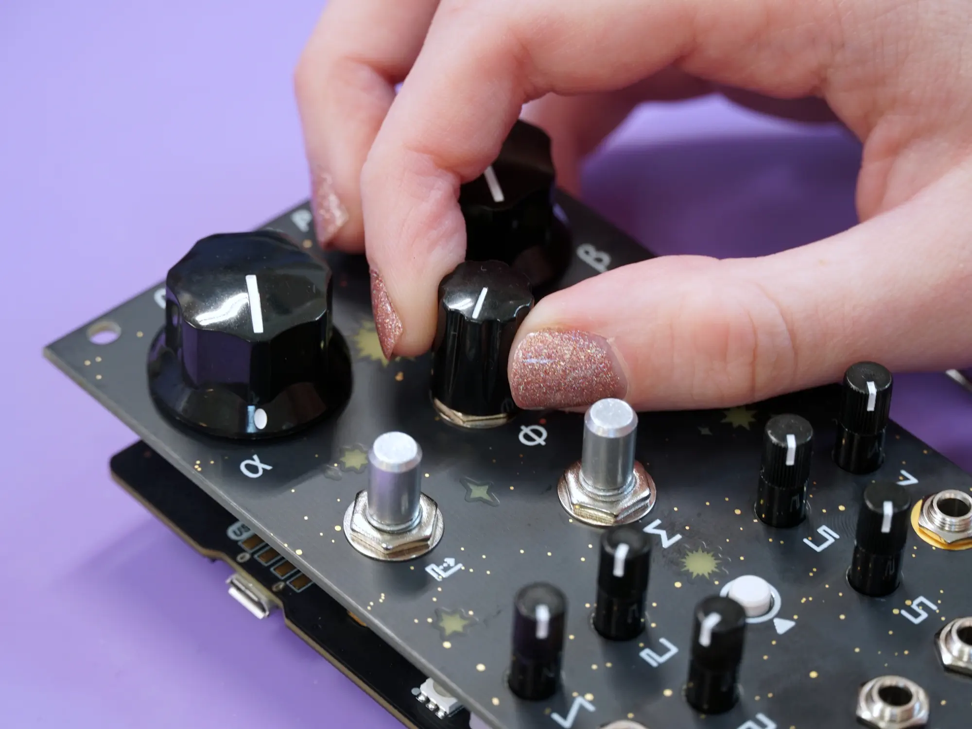
[picture p71: user_guide/docs/images/kit/70 - knob.webp]
Placing the smaller knobs


## Module completed

Congrats, you finished building your very own Castor & Pollux!

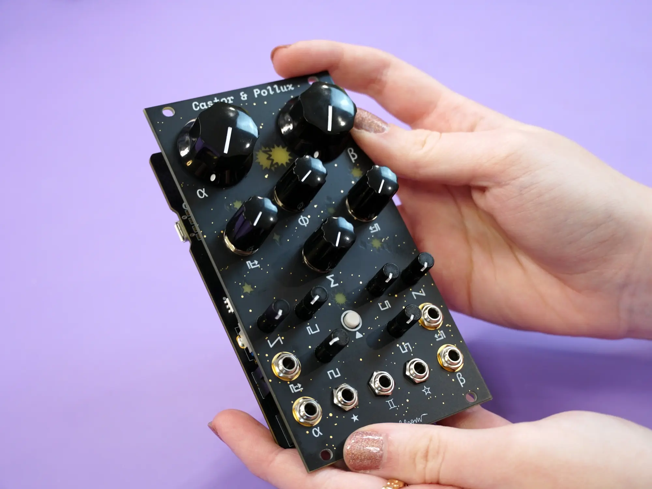
[picture p72: user_guide/docs/images/kit/71 - finished.webp]
Completed module


Continue reading to finish assembling the expander if you'd like. Don't forget to go check out the [User's Guide](index.md). We'd love to see your work, feel free to tag us on social media - we're `@wntrblm` on [Twitter](https://twitter.com/wntrblm) and [Instagram](https://instagram.com/wntrblm).

## Expander

To assemble the expander, you'll need the expander faceplate, six 1/8" jacks, six nuts for the jacks, and the expander board.

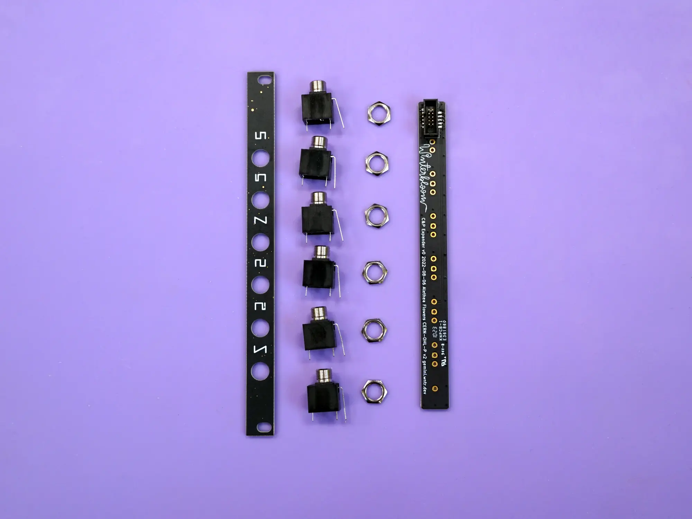
[picture p73: user_guide/docs/images/kit/72 - expander parts.webp]
Expander parts


Start by placing all six of the 1/8" jacks onto the front side of the expander board.

<winter-carousel>
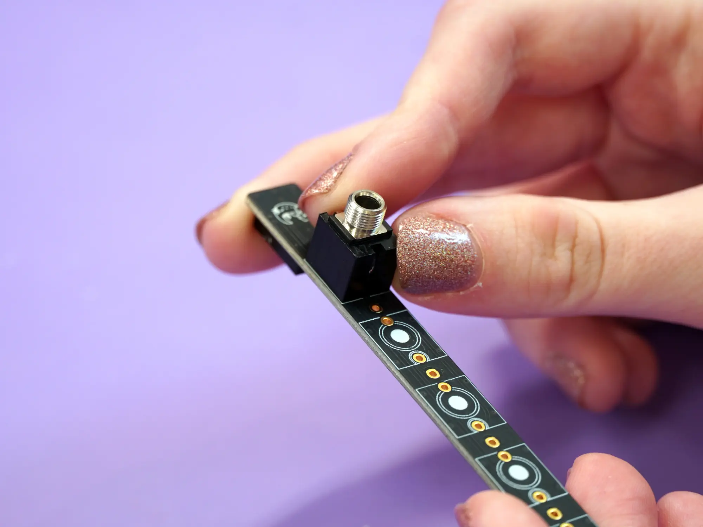
[picture p74: user_guide/docs/images/kit/73 - jack.webp]
  
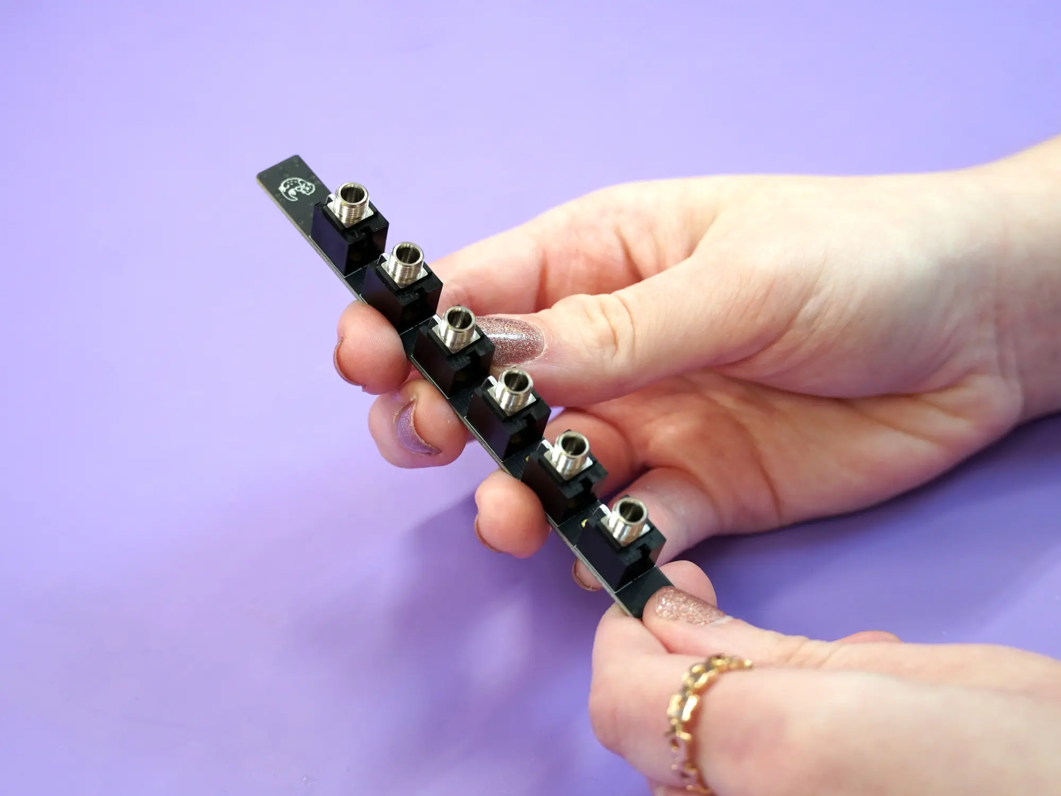
[picture p75: user_guide/docs/images/kit/74 - jacks.webp]
  
</winter-carousel>

Next, place the faceplate onto the jacks and temporarily hold it in place using a rubber band.

<winter-carousel>
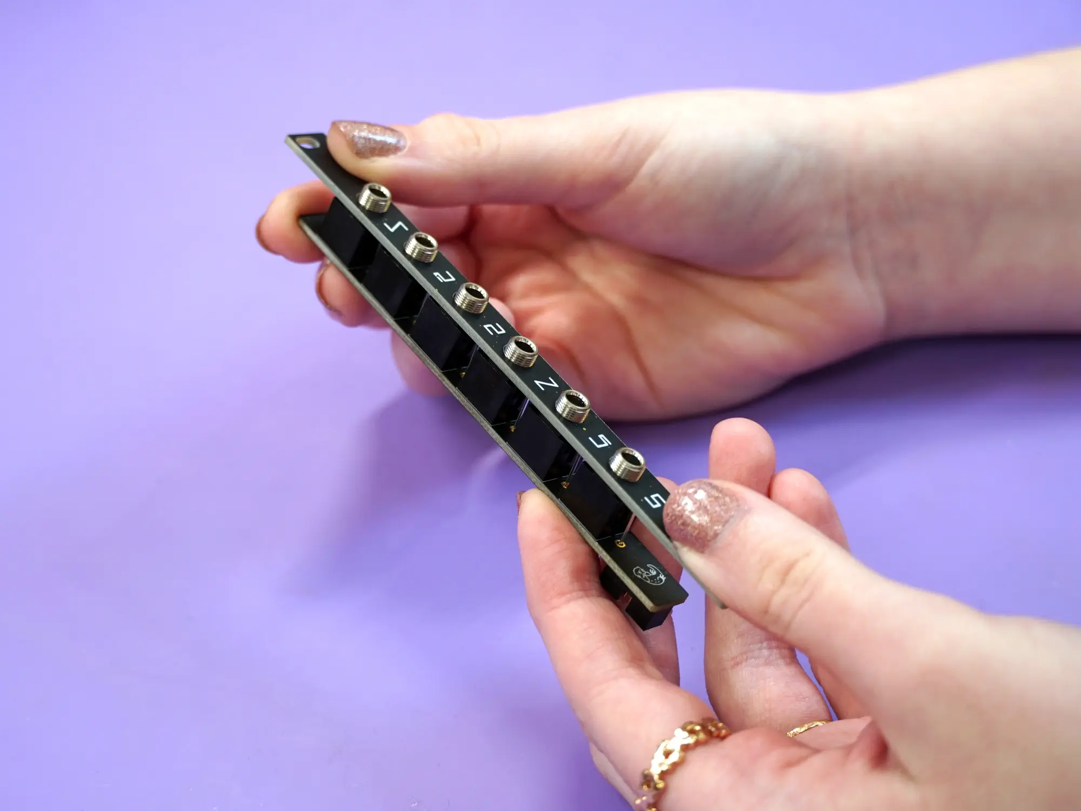
[picture p76: user_guide/docs/images/kit/75 - panel.webp]
  
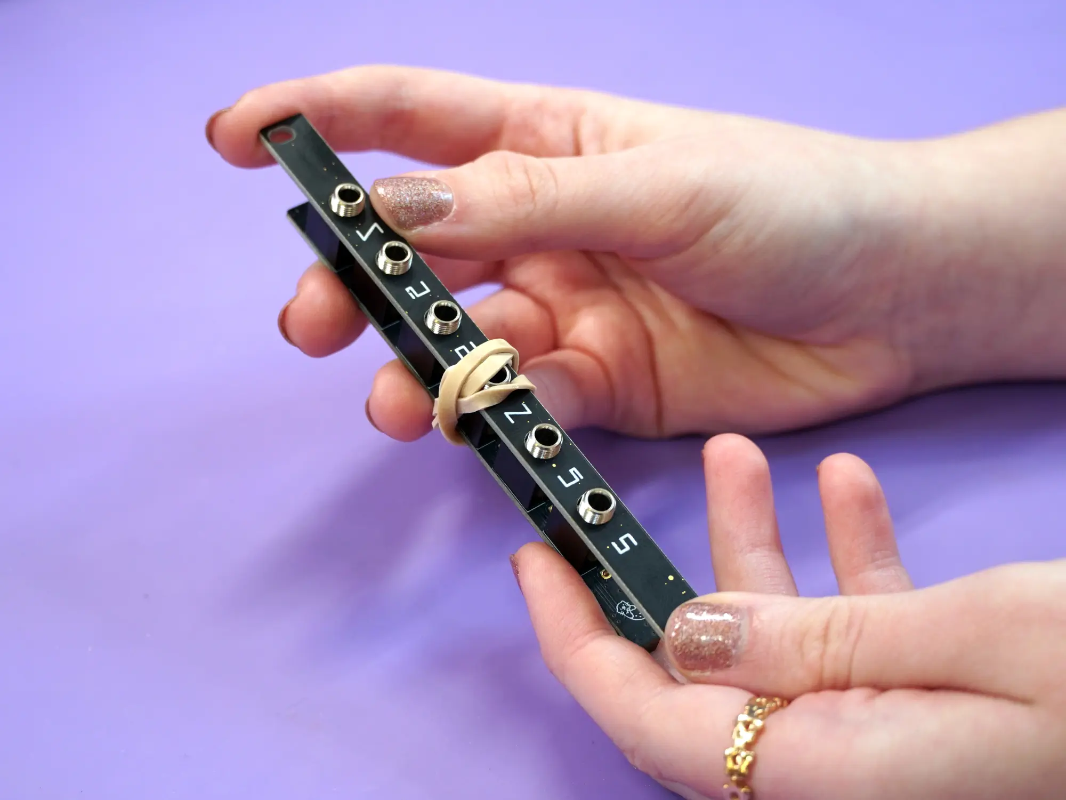
[picture p77: user_guide/docs/images/kit/76 - rubber band.webp]
  
</winter-carousel>

Flip it upside-down and solder all of the jacks into place.

<winter-carousel>
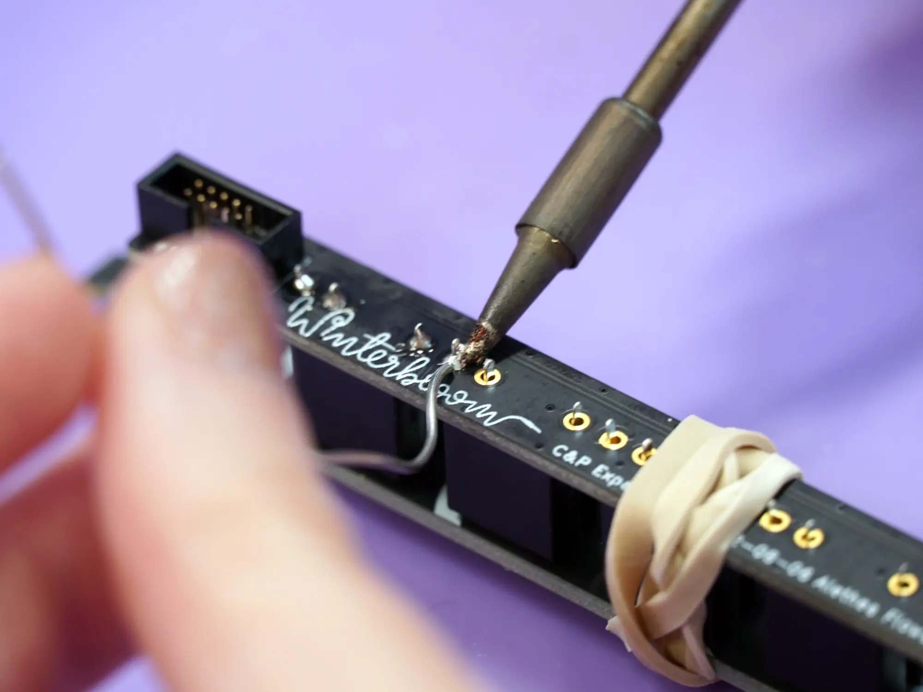
[picture p78: user_guide/docs/images/kit/77 - soldering.webp]
  
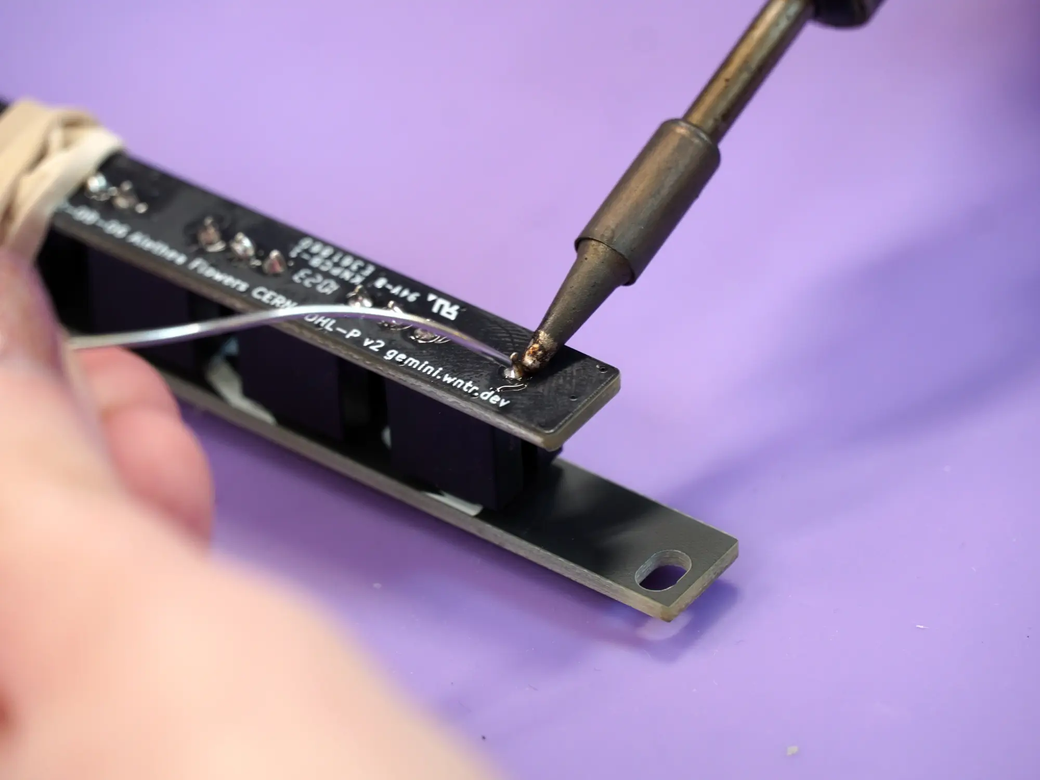
[picture p79: user_guide/docs/images/kit/78 - soldering.webp]
  
</winter-carousel>

Flip it rightside-up and secure the faceplate using the hex nuts.

<winter-carousel>
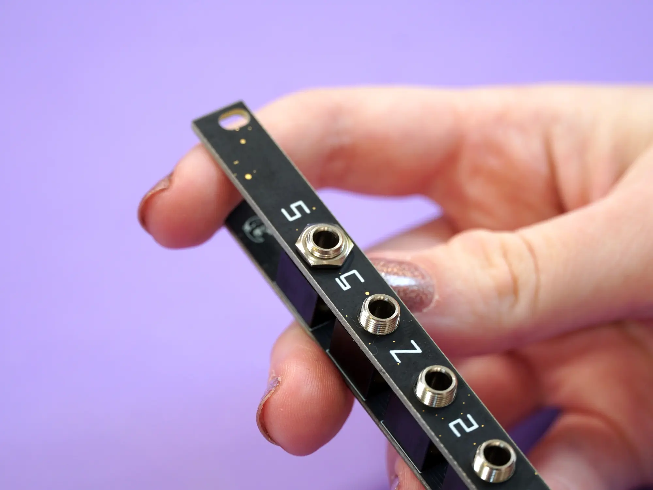
[picture p80: user_guide/docs/images/kit/79 - nut.webp]
  
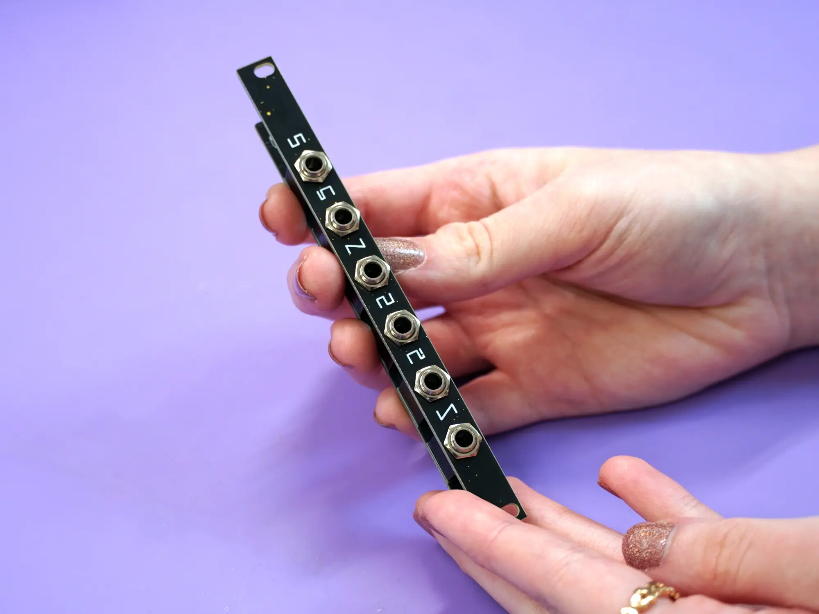
[picture p81: user_guide/docs/images/kit/80 - nuts.webp]
  
</winter-carousel>

& you're finished!

## All done

Congrats on building your very own Castor & Pollux, we hope you had a lovely time! Don't forget to go check out the [User's Guide](index.md). We'd love to see your work, feel free to tag us on social media - we're `@wntrblm` on [Twitter](https://twitter.com/wntrblm) and [Instagram](https://instagram.com/wntrblm).

If you have any feedback or ran into any issues, feel free to drop us an email at support@winterbloom.com or file a issue on [GitHub](https://github.com/wntrblm/Castor_and_Pollux).
