wntrblm/Castor_and_Pollux/user_guide/docs/images/kit/1 - marm.webp

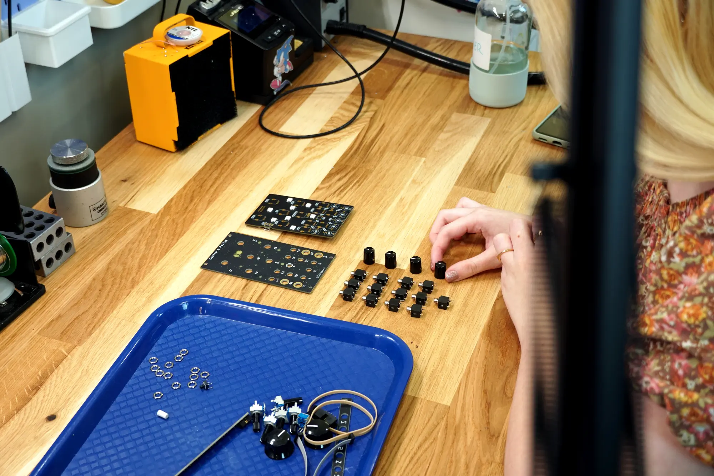
user_guide/docs/images/kit/1 - marm.webp
