wntrblm/Castor_and_Pollux/user_guide/docs/images/kit/2 - contents.webp

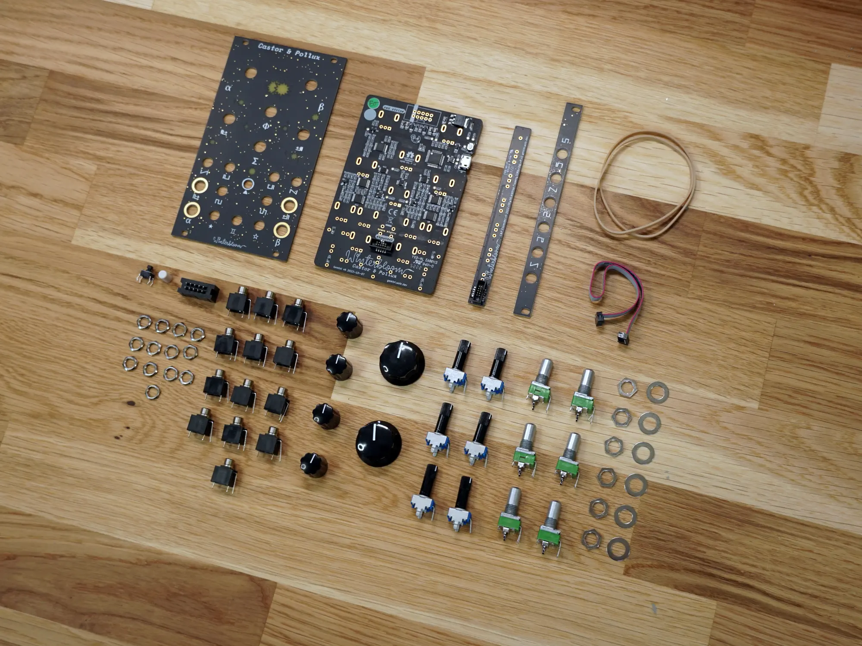
user_guide/docs/images/kit/2 - contents.webp
