wntrblm/Castor_and_Pollux/user_guide/docs/images/kit/9 - pots.webp

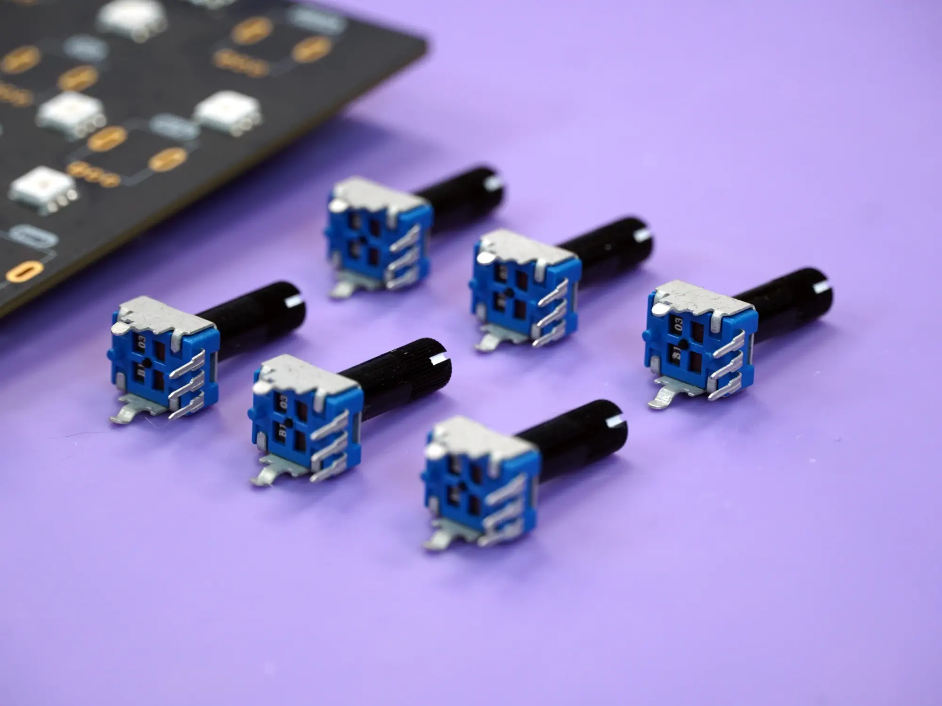
user_guide/docs/images/kit/9 - pots.webp
