wntrblm/Castor_and_Pollux/(threads)

Thread 11 (2021-03-07):

Allow base CV offset to be modified using the settings editor.

theacodes, 2021-03-07:
Right now, the base CV offset is fixed so that 0V = C2. It should be possible to edit this with the settings editor.

theacodes, 2021-06-10:
This is available in the June 10th, 2021 release

Closed 2021-06-10.

Thread 14 (2021-04-21):

Faint Castor ramp bleed into Pollux mix out

nebularnoise, 2021-04-21:
For context: this is a DIY build based on hardware v2 9/26/2020, *with* fixed transistor ramp core.

I've noticed that with all volume pots at zero, there is a faint bleed of castor's ramp in pollux's mix out.
I've yet to calibrate the unit, but this seems like pure analog spookery at play, here.

Please note that in the following report, part numbering follows latest schematic (3beb279a95de5f913ee39eabb3c62e39aa9bb90e as of today).
With preliminary probing, here's what I've tested:
- No bleed at pin 8 of U12
- Bleed after r47 (== net pollux_mix_out) -- this is the reference volume
- Bleed is fainter at pin 3 of U14a
- Bleed is equal at pin 1 of U14a

Setting Castor's ramp volume up, and playing with the crossfade knob can cancel out the bleed. This seems to indicate the bleed is 180° out of phase with the ramp output. Maybe netlist `castor_ramp_pre` is bleeding in ?

I'll tinker a bit further when I get the time.

theacodes, 2021-04-21:
On production hardware there is a *very* small (6mV peak-to-peak, about 500 parts per million out of the 12 V peak-to-peak output) noise that can be observed on `castor_mix_out`, `pollux_mix_out`, and `mix_out`. Part of the noise is influenced by Castor's oscillator frequency, but it is not anywhere near audible. From what I can tell, this is normal power supply ripple and parasitic capacitive coupling (`castor_ramp_out` and `pollux_mix_out` run parallel to each other, and also are adjacent on the pin header).

> Bleed is fainter at pin 3 of U14a

pin 3 of U14a is the output of a voltage divider that halves `pollux_mix_out`, so that tracks.

> Bleed is equal at pin 1 of U14a

pin 1 of U14a is the output of the amplifier and should be louder, so this tracks as well.

> This seems to indicate the bleed is 180°

The mixed waveforms are inverted.

> I'll tinker a bit further when I get the time.

Good luck! I'm happy to help where I can, but please keep in mind that we can only provide limited support for DIY builds.

nebularnoise, 2021-04-22:
> we can only provide limited support for DIY builds.
Of course! This issue was only to document what I found in my journey 😄

> 6mV peak-to-peak
Oh, on my unit, its muuuuch more than that.

This morning, I realised I had not properly cleaned the jackboard. I probed a puddle of flux and the bleed was there 🙃
I'll be back after cleaning everything thoroughly. Most likely the adjacent pin headers are capacitively coupled through the flux goo...

theacodes, 2021-04-22:
Oh, yeah. Flux can absolutely ruin your day in analog circuits like this.
Let me know how that works out.

On Thu, Apr 22, 2021, 2:48 AM Thibault Geoffroy ***@***.***>
wrote:

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

theacodes, 2021-04-22:
I'm going to close this for now since it doesn't affect production boards, but if there's anything else I can do, let me know.

nebularnoise, 2021-04-23:
It was 100% the flux.
The outputs are now perfectly silent when pots are down :pinching_hand: *chef's kiss*

theacodes, 2021-04-23:
Glad you got it sorted out 😎

On Fri, Apr 23, 2021, 4:06 PM Thibault Geoffroy ***@***.***>
wrote:

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

Closed 2021-04-22.

Thread 24 (2021-11-30):

Feature: quantized pitch control voltage input

theacodes, 2021-11-30:
This feature would allow configuring either (or both) pitch CV inputs to quantize to the nearest semitone.

## Implementation checklist

- [ ] Basic feature implementation, mostly already done in https://github.com/aquaticsarah/Castor_and_Pollux/commit/9e2452c67c6bfa1d0f7cf3d40c0199462d143fb3
- [ ] New settings fields to enable quantization for each oscillator. This requires a couple of changes in a few files- [this commit](https://github.com/wntrblm/Castor_and_Pollux/commit/3adf2cfb16b5d4ef8576dbcc3d75d76e84516e07) shows what's involved.
- [ ] Update the settings editor to have the fields. This isn't too bad, [this commit](https://github.com/wntrblm/Castor_and_Pollux/commit/604b5c776c3875597e637bfba2c00ae6ac23a93d) shows how it was done for the LFO feature, which was a lot more involved than this one.

## Possible follow-up features

These are nice to have, but not required to get this feature deployed. They can be added on later.

- Ability to specify a scale other than the chromatic scale.

/cc @aquaticsarah

theacodes, 2023-04-22:
This is done in V2's firmware, 04-22-2023.

Closed 2023-04-22.

Thread 28 (2022-07-04):

Add "Reset Module" button to settings editor

aquaticsarah, 2022-07-04:
It would super nice to have a button in the settings editor page to reset Castor & Pollux, ideally right underneath the "upload settings" button

That way, the user doesn't have to use the physical reset button on the module, which may be difficult to get to depending on how their rack is arranged

Closed 2022-07-06.

Thread 29 (2022-08-30):

Feature: Remapping of PWM CV Input as an FM CV Input

Izaakthegreat, 2022-08-30:
Request to be able to remap the current PWM in jack to be used for FM of each oscillator. Ideally this could be changed independently per oscillator (e.g. Castor could have PWM and Pollux could have FM) and could be enabled either through a button combination or through Gemini.
