wntrblm/Castor_and_Pollux/firmware/src/gem_config_rev5.h

/*
    Copyright (c) 2021 Alethea Katherine Flowers.
    Published under the standard MIT License.
    Full text available at: https://opensource.org/licenses/MIT
*/

#pragma once

#include "gem_adc.h"
#include "gem_i2c.h"
#include "gem_led_animation.h"
#include "gem_pulseout.h"
#include "gem_spi.h"
#include "wntr_gpio.h"

/*
    With the below settings the total time per ADC conversion is
    24.67 microseconds.

    With Gemini's 9 channels it takes at least 198 microseconds to measure
    all channels. There's a bit of added overhead because the CPU has to switch
    channels between each measurement. This means that the effective sample
    rate for Gemini is about 5 kHz.

    See: https://blog.thea.codes/getting-the-most-out-of-the-samd21-adc/
*/
static const struct GemADCConfig GEM_REV5_ADC_CFG = {
    // ADC clock can be *at most* 2,100 kHz.
    // Gemini has GCLK0 @ 48Mhz so 48MHz / 32 = 1,500 kHz ADC clock.
    .gclk = GCLK_CLKCTRL_GEN_GCLK0,
    .gclk_prescaler = ADC_CTRLB_PRESCALER_DIV32,
    // Max impedance is 17,617 kOhms
    .sample_time = 1,
    // Record and average 16 samples for each measurement.
    .sample_num = ADC_AVGCTRL_SAMPLENUM_16,
    .adjres = ADC_AVGCTRL_ADJRES(4),
};

static const struct GemADCInput GEM_REV5_ADC_INPUTS[] = {
    GEM_ADC_INPUT_INVERTED(A, 5, 5),  // Duty A
    GEM_ADC_INPUT(A, 10, 18),         // Duty A Pot
    GEM_ADC_INPUT_INVERTED(B, 9, 3),  // Duty B
    GEM_ADC_INPUT(A, 8, 16),          // Duty B Pot
    GEM_ADC_INPUT(A, 9, 17),          // Chorus pot
    GEM_ADC_INPUT(B, 2, 10),          // CV A Pot
    GEM_ADC_INPUT(B, 3, 11),          // CV B Pot
    GEM_ADC_INPUT(A, 7, 7),           // CV A
    GEM_ADC_INPUT(A, 6, 6),           // CV B
};

/*
    Configuration for the oscillator's input range
*/
static const struct GemOscillatorInputConfig GEM_REV5_OSC_INPUT_CFG = {
    .pitch_cv_min = F16(-0.5), .pitch_cv_max = F16(6.1)};

/*
    Configuration for the square wave outputs for each oscillator.

    Rev 5:
    TCC0 WO6 / PA12 for Castor
    TCC1 WO1 / PA11 for Pollux
*/
static const struct GemPulseOutConfig GEM_REV5_PULSE_OUT_CFG = {
    .gclk = GCLK_CLKCTRL_GEN_GCLK1,
    .gclk_freq = 8000000,
    .tcc0_pin = WNTR_GPIO_PIN_ALT(A, 12, F),
    .tcc0_wo = 6,
    .tcc1_pin = WNTR_GPIO_PIN_ALT(A, 11, E),
    .tcc1_wo = 1,
};

/*
    DAC I2C configuration
*/
static const struct GemI2CConfig GEM_REV5_I2C_CFG = {
    .gclk = GCLK_CLKCTRL_GEN_GCLK1,
    .gclk_freq = 8000000,
    .baudrate = 400000,
    .rise_time = 30,
    .wait_timeout = 10000,
    .sercom = SERCOM3,
    .apbcmask = PM_APBCMASK_SERCOM3,
    .clkctrl_id = GCLK_CLKCTRL_ID_SERCOM3_CORE,
    .pad0_pin = WNTR_GPIO_PIN_ALT(A, 16, D),
    .pad1_pin = WNTR_GPIO_PIN_ALT(A, 17, D),
};

/*
    Dotstar SPI configuration
*/
static const struct GemSPIConfig GEM_REV5_SPI_CFG = {
    .gclk = GCLK_CLKCTRL_GEN_GCLK0,
    .gclk_freq = 48000000,
    .baud = 8000000,
    .polarity = 0,
    .phase = 0,
    .sercom = SERCOM1,
    .apbcmask = PM_APBCMASK_SERCOM1,
    .clkctrl_id = GCLK_CLKCTRL_ID_SERCOM1_CORE,
    .dopo = 0x0, /* Pad 0 is data, pad 1 is clock */
    .sck_pin = WNTR_GPIO_PIN_ALT(A, 1, D),
    .sdo_pin = WNTR_GPIO_PIN_ALT(A, 0, D),
};

static const struct GemDotstarCfg GEM_REV5_DOTSTAR_CFG = {
    .count = 8,
    .spi = &GEM_REV5_SPI_CFG,
};

/*
    Animation configuration
*/
static const struct GemLEDCfg GEM_REV5_LED_CFG = {
    .hue_offsets =
        {
            0,
            8169,
            16338,
            24508,
            32677,
            40846,
            49016,
            57185,
        },
    .vertical_pos_index = {0, 7, 1, 2, 6, 3, 5, 4},
    .lfo_tweak_led = 0,
    .pitch_a_tweak_led = 7,
    .pitch_b_tweak_led = 1,
    .pwm_a_led = 5,
    .pwm_b_led = 3,
    .fm_a_led = 7,
    .fm_b_led = 1,
};

/*
    Revision 5 detection pin. On revisions 1-4, this pin is floating.
    On revision 5 this pin is tied to ground.
*/
#define GEM_REV5_PIN WNTR_GPIO_PIN(A, 27)
