wntrblm/Castor_and_Pollux/firmware/src/gem_adc_channels.h

/*
    Copyright (c) 2021 Alethea Katherine Flowers.
    Published under the standard MIT License.
    Full text available at: https://opensource.org/licenses/MIT
*/

#pragma once

/* Names for ADC inputs */
enum GemADCChannel {
    GEM_IN_DUTY_A = 0,
    GEM_IN_DUTY_A_POT = 1,
    GEM_IN_DUTY_B = 2,
    GEM_IN_DUTY_B_POT = 3,
    GEM_IN_CHORUS_POT = 4,
    GEM_IN_CV_A_POT = 5,
    GEM_IN_CV_B_POT = 6,
    GEM_IN_CV_A = 7,
    GEM_IN_CV_B = 8,
    GEM_IN_COUNT = 9,
};
