wntrblm/Castor_and_Pollux/firmware/src/gem_ramp_table_load_save.c

/*
    Copyright (c) 2021 Alethea Katherine Flowers.
    Published under the standard MIT License.
    Full text available at: https://opensource.org/licenses/MIT
*/

#include "gem_ramp_table.h"
#include "printf.h"
#include "wntr_assert.h"
#include "wntr_nvm.h"
#include "wntr_pack.h"
#include <stdbool.h>
#include <string.h>

/*
    Routines for loading/saving the ramp amplitude compensation table to/from
    NVM
*/

#define VALID_TABLE_MARKER 0x43
#define BUFFER_LEN 512
#define ENTRY_SIZE 8

extern uint8_t _nvm_lut_base_address;
extern uint8_t _nvm_lut_length;

/* This is inefficient in terms of RAM usage, but we've got plenty of space to spare.
   if in the future this becomes problematic, this can be refactored to read/write
   in pages instead of all at once.
*/
static uint8_t param_table_load_buf_[BUFFER_LEN];

/* Public functions. */

void gem_ramp_table_load() {
    /* Make sure these are equivalent - otherwise bail. */

    // NOLINTNEXTLINE(clang-diagnostic-pointer-to-int-cast)
    if ((uint32_t)(&_nvm_lut_length) != sizeof(param_table_load_buf_) / sizeof(param_table_load_buf_[0])) {
        printf("NVM LUT length is not equal to the NVM LUT buffer!\r\n");
        return;
    }

    // NOLINTNEXTLINE(clang-diagnostic-pointer-to-int-cast)
    wntr_nvm_read((uint32_t)(&_nvm_lut_base_address), param_table_load_buf_, BUFFER_LEN);

    if (param_table_load_buf_[BUFFER_LEN - 1] != VALID_TABLE_MARKER) {
        printf("No valid LUT table.\r\n");
        return;
    }

    uint16_t checksum = 0;
    for (size_t table_idx = 0; table_idx < gem_ramp_table_len; table_idx++) {
        gem_ramp_table[table_idx].castor_ramp_cv = WNTR_UNPACK_16(param_table_load_buf_, table_idx * ENTRY_SIZE + 4);
        gem_ramp_table[table_idx].pollux_ramp_cv = WNTR_UNPACK_16(param_table_load_buf_, table_idx * ENTRY_SIZE + 6);

        checksum ^= gem_ramp_table[table_idx].castor_ramp_cv;
    }

    printf("LUT table loaded from NVM, checksum: %04x\r\n", checksum);
}

void gem_ramp_table_save() {
    WNTR_ASSERT_DEBUG(BUFFER_LEN >= gem_ramp_table_len * 8 + 1);

    for (size_t table_idx = 0; table_idx < gem_ramp_table_len; table_idx++) {
        WNTR_PACK_16(gem_ramp_table[table_idx].castor_ramp_cv, param_table_load_buf_, table_idx * ENTRY_SIZE + 4);
        WNTR_PACK_16(gem_ramp_table[table_idx].pollux_ramp_cv, param_table_load_buf_, table_idx * ENTRY_SIZE + 6);
    }

    param_table_load_buf_[BUFFER_LEN - 1] = VALID_TABLE_MARKER;

    // NOLINTNEXTLINE(clang-diagnostic-pointer-to-int-cast)
    wntr_nvm_write((uint32_t)(&_nvm_lut_base_address), param_table_load_buf_, BUFFER_LEN);
}

void gem_ramp_table_erase() {
    memset(param_table_load_buf_, 0xFF, BUFFER_LEN);

    // NOLINTNEXTLINE(clang-diagnostic-pointer-to-int-cast)
    wntr_nvm_write((uint32_t)(&_nvm_lut_base_address), param_table_load_buf_, BUFFER_LEN);
}
