wntrblm/Castor_and_Pollux/firmware/src/tusb_config.h

/*
    Copyright (c) 2021 Alethea Katherine Flowers.
    Published under the standard MIT License.
    Full text available at: https://opensource.org/licenses/MIT
*/

#pragma once

// #define CFG_TUSB_DEBUG 0
#define BOARD_DEVICE_RHPORT_NUM 0
#define BOARD_DEVICE_RHPORT_SPEED OPT_MODE_FULL_SPEED
#define CFG_TUSB_RHPORT0_MODE (OPT_MODE_DEVICE | BOARD_DEVICE_RHPORT_SPEED)
#define CFG_TUSB_OS OPT_OS_NONE
#define CFG_TUD_ENDPOINT0_SIZE 64
#define CFG_TUD_CDC 0
#define CFG_TUD_MSC 0
#define CFG_TUD_HID 0
#define CFG_TUD_MIDI 1
#define CFG_TUD_VENDOR 0
// Give TinyUSB more memory for usb midi packets. We have the RAM to spare and
// this lets us send longer SysEx messages.
#define CFG_TUD_MIDI_RX_BUFSIZE 512
#define CFG_TUD_MIDI_TX_BUFSIZE 512
#define CFG_TUSB_ATTR_USBRAM
#define CFG_TUSB_MEM_ALIGN __attribute__((aligned(4)))
