wntrblm/Castor_and_Pollux/(commit log)

2020-07-21 Move jackboard.pretty
    [mcu.sch]
2020-07-26 First pass layout & component selection for mainboard
    [analogins.sch, c-5787834-1-c-3d.step, castor.sch, mainboard.kicad_pcb, mainboard.sch, mcu.sch, outputmixer.sch, power.sch]
2020-07-26 First pass layout for jackboard
    [jackboard.kicad_pcb, jackboard.sch]
2020-07-27 Move power rails to in1.cu
    [mainboard.kicad_pcb]
2020-07-27 Refine mainboard a bit more
    [mainboard.kicad_pcb]
2020-07-27 Remove mainboard-old
    [mainboard-old.kicad_pcb]
2020-07-27 Refine mainboard even more - ground planes, caps, oh my!
    [mainboard.kicad_pcb, mcu.sch, power.sch]
2020-07-30 Fixup ERC errors
    [castor.sch, mainboard.sch, mcu.sch, power.sch]
2020-07-30 Check passive ratings
    [analogins.sch, castor.sch, mcu.sch, outputmixer.sch, power.sch]
2020-07-30 Add silkscreen for notes section
    [mainboard.kicad_pcb]
2020-07-31 Re-route jackboard
    [jackboard.kicad_pcb]
2020-08-02 Update jackboard models
    [jackboard.kicad_pcb, ptv09a-4x20u-xxxx.stp, ptv09a-4x30u-xxxx.stp]
2020-08-02 Fix usb overhang, add swd pads on top copper
    [mainboard.kicad_pcb, mcu.sch]
2020-08-02 Move mounting hole
    [jackboard.kicad_pcb, jackboard.sch, mainboard.kicad_pcb]
2020-08-02 fix 3v3 fill
    [mainboard.kicad_pcb]
2020-08-08 Bumb schematics after generating gerbers and assigning alt mpns
    [analogins.sch, castor.sch, jackboard.kicad_pcb, mainboard.sch, mcu.sch, outputmixer.sch, power.sch]
2020-08-09 Add simple ADC proof of concept
2020-08-12 Move ADC config to configuration header
2020-08-12 Read multiple ADC channels
2020-08-12 Basic ADC input scanning
2020-08-12 Add adc result ready check
2020-08-12 Fix bug where setting the TCC1 CC was wrong
    [gem_pulseout.c, main.c]
2020-08-13 Add SEGGER RTT & printf
2020-08-13 Small adjustment to the ADC default averaging
2020-08-15 Enable REFCOMP for ADC
2020-08-15 Switch ADC clock to 1,500kHz, it seems to be more stable
2020-08-16 Fix potentiometer footprint
    [jackboard.kicad_pcb]
2020-08-16 Add basic i2c
2020-08-16 Handle i2c failure cases
    [gem_i2c.c, gem_i2c.h, main.c]
2020-08-16 Bump i2c baudrate up to 400kHz
2020-08-18 Add basic driver for the mcp4728
2020-08-18 Fixup some small typos
    [main.c]
2020-08-20 Fix small silkscreen issue
    [mainboard.kicad_pcb]
2020-08-20 Fix incorrect MPN for 10uF cap
    [analogins.sch, castor.sch, mcu.sch]
2020-08-20 Fix a few more mpns
    [analogins.sch, castor.sch, mcu.sch, outputmixer.sch, power.sch]
2020-08-20 Change footprint for 22uF cap to 0805 to use a cheaper MPN
    [mainboard.kicad_pcb, mainboard.sch, power.sch]
2020-08-23 Move to full speed USB device
2020-08-24 Disable scanning when doing a sync adc read
2020-08-24 Add read adc sysex command
2020-08-31 Update R4, R28 to 2.2k
    [castor.sch, mainboard.kicad_pcb]
2020-09-01 Fix bug in pulseout where the count register could be above the period register leading to incorrect PWM periods
    [gem_pulseout.c]
2020-09-01 Add factory scripts
    [calibration-table.csv]
2020-09-02 Update some part numbers
    [mainboard.kicad_pcb]
2020-09-02 Fix mixer pots wired backwards; switch to 5050 dotstars; add wntr.dev/gemini link and board revision version
    [jackboard.kicad_pcb, jackboard.sch]
2020-09-02 Add wntr.dev/gemini link
    [mainboard.kicad_pcb]
2020-09-02 Fixup pcb text items on jackboard
    [jackboard.kicad_pcb, jackboard.sch]
2020-09-02 Fixup text items on mainboard PCB
    [mainboard.kicad_pcb]
2020-09-02 Reduce mainboard size
    [mainboard.kicad_pcb]
2020-09-03 Add extra channel settings to the mcp4728 driver
2020-09-03 Change the RC differentiator capacitor to allow longer for discharging
    [castor.sch, power.sch]
2020-09-03 Change R70 from 100k to 1k
    [outputmixer.sch]
2020-09-03 Move output resistors outside of the feedback loop
    [castor.sch, mainboard.kicad_pcb]
2020-09-05 Write up a simple calibration program and update the calibration table with real-world measurements
    [calibration-table.csv]
2020-09-05 Change i2c frequency back to 400kHz
2020-09-05 Fix a bug where COUNT == PER could cause overflow
    [gem_pulseout.c]
2020-09-05 Update voice parameter table from calibration data
2020-09-06 Move Pollux's square generator to TCC1WO1
    [mainboard.kicad_pcb, mcu.sch]
2020-09-07 Update datestamps, version numbers, and order new boards
    [analogins.sch, castor.sch, jackboard.kicad_pcb, jackboard.sch, mainboard.kicad_pcb, mainboard.sch, mcu.sch, outputmixer.sch]
2020-09-08 Switch TCC to DIV8 instead of DIV16 for better timer resolution
2020-09-08 Update calibration table with voltage value and separate dac codes for castor & pollux
    [calibration-table.csv]
2020-09-08 Add quanitization to pitch CV
2020-09-08 Remove unused button/led i/o that's not present on production hardware
2020-09-08 Add enums for ADC channels names
2020-09-09 Add midi event callback functionality to make it easier to place the device into calibration mode.
2020-09-09 Update USB VID/PID
2020-09-12 Update voice param table
    [calibration-table.csv]
2020-09-12 Calculate input CV correctly
    [main.c]
2020-09-12 Change ADC averaging to 128 samples
2020-09-12 Disable interrupts while changing timers
2020-09-13 Only use 64 samples to improve loop time.
2020-09-13 Quantize Pollux's pitch knob to increase chance of achieving tuning between oscs
2020-09-13 Cleanup ADC input initialization
2020-09-13 Set count before setting period to avoid glitches
    [gem_pulseout.c]
2020-09-13 Use double-buffering on TCC registers to prevent glitching
    [gem_pulseout.c, gem_pulseout.h, main.c]
2020-09-16 Fix cross DI/DO line, make Pollux's CV normalize to 0v
    [jackboard.kicad_pcb, jackboard.sch]
2020-09-17 Increase pad size for jacks
    [jackboard.kicad_pcb]
2020-09-17 Swap phase jack for hard sync switch
    [jackboard.kicad_pcb, jackboard.sch]
2020-09-17 Mark switch footprint with cap size
    [jackboard.kicad_pcb]
2020-09-17 Add naive and untested SPI controller implementation
2020-09-17 Swap dotstar clk and data on mainboard (label only change, no hardware change)
    [mainboard.kicad_pcb, mainboard.sch, mcu.sch]
2020-09-17 Swap dotstar clk and data on jackboard
    [jackboard.kicad_pcb, jackboard.sch]
2020-09-18 Temporary implementation of ADC offset and gain correction
    [gem_adc.c, main.c]
2020-09-18 Set baud rate for SPI, try Dotstar test pattern (not working yet)
    [gem_spi.c, main.c]
2020-09-18 Use NVM settings for ADC and Dotstar settings.
2020-09-18 Switch to TCC1 for v1 hardware
2020-09-19 I have no idea what KiCAD did
    [mainboard.kicad_pcb]
2020-09-19 Reset ADC before configuration
    [gem_adc.c, gem_i2c.c]
2020-09-19 Reset SERCOM before using SPI
    [gem_spi.c]
2020-09-19 Reset TCCs before using them
    [gem_pulseout.c]
2020-09-20 Fix power connector
    [jackboard.kicad_pcb, jackboard.sch]
2020-09-21 Set ADC gain and offset error via shell
    [main.c]
2020-09-21 Update voice params for 24bit timers
    [calibration-table.csv]
2020-09-21 Get basic fix16 LED animation going
    [gem_adc.c, gem_i2c.c, gem_spi.c, gem_voice_params.c, main.c]
2020-09-22 Move one of the dotstars
    [jackboard.kicad_pcb]
2020-09-22 Use fix16 for CV -> voice param calculation.
    [gem_voice_params.c, main.c]
2020-09-22 Switch main loop completely to f16
2020-09-22 Slight tweak to LED pattern
2020-09-22 Move gem_sine to fix16
    [main.c]
2020-09-22 Move LED animations to their own file
2020-09-24 Add methods for correcting linear adc measurements
    [gem_adc.c, gem_adc.h]
2020-09-24 Get ADC channel from SysEx message
2020-09-24 Increase sample time (for now)
2020-09-24 Cleanup factory scripts, consolidate gemini interface into a single class, make calibration prorams overall just better.
2020-09-25 Make the pitch knobs ranges settings
2020-09-25 Fixup some issues found after testing calibration scripts on real hardware
2020-09-25 Fix missing fix16_from_int in CV calculations
    [main.c]
2020-09-25 Double check MPNs
    [mainboard.sch]
2020-09-25 Organize some of the source files into hw & drivers
2020-09-25 Add calibration mode LED
2020-09-25 Fix incorrect return in i2c
    [gem_i2c.c]
2020-09-27 Change phase in to hard sync button, remove unneeded parts, make v2 mainboard
    [analogins.sch, castor.sch, mainboard.kicad_pcb, mainboard.sch, mcu.sch, outputmixer.sch, power.sch]
2020-09-28 Reduce sample averaging to 32, add clampig on pitch cvs so they can't go below zero.
2020-10-01 Only update LEDs once every 16 milliseconds
2020-10-01 Make new LED animation
2020-10-01 Fix typo that was preventing pollux CV from working.
    [main.c]
2020-10-02 Sum the PWM CV and knobs
2020-10-02 Tweak the CV filter a bit
2020-10-02 Update mpns
    [castor.sch, mainboard.kicad_pcb, mainboard.sch, mcu.sch]
2020-10-04 I touched the kicad project, *shrug*
2020-10-04 Add hard sync button implementation
2020-10-05 Add programming board
    [progboard.kicad_pcb, progboard.sch]
2020-10-05 Fix hard sync button, add LED animation for hard sync
    [gem_led_animation.c, gem_led_animation.h, main.c]
2020-10-05 Add LEDs to the progboard
    [progboard.kicad_pcb, progboard.sch]
2020-10-06 Enable double promotion errors and fix a bunch
    [gem_led_animation.c, main.c]
2020-10-11 Add embedded-friendly printf to third_party
2020-10-11 Update sources to use the new printf
2020-10-11 Update progboard pcb after preparing gerbers
    [progboard.kicad_pcb]
2020-10-11 Ignore gerbers
2020-10-11 Adjust the frequency of LED sparkles
2020-10-11 Print more details about the settings at startup
2020-10-11 Fix USB serial number communication
    [gem_usb_descriptors.c]
2020-10-12 Fix errors found with higher optimizations
    [gem_usb_descriptors.c, gem_voice_params.c]
2020-10-13 Move the pitch calibration table and generation script into src, invoke the generator from the makefile.
    [pitch-calibration-table.csv]
2020-10-19 Apply ADC correction to knobs
    [gem_adc.c, gem_adc.h, main.c]
2020-10-19 Fix missing newlines in prints
2020-10-23 Fix incorrect lerp function
    [gem_voice_params.c, main.c]
2020-10-24 Update the led animation less often (once every 50ms)
2020-10-24 Adjust smoothing parameters, fix pollux knob code
    [main.c]
2020-10-24 Move settings printing code into gem_settings_print
2020-10-25 Fix not calling init() from main()
    [main.c]
2020-10-25 Add some missing static declarations
    [gem_adc.c]
2020-11-07 Adjust drill sizes for pogo pins
    [progboard.kicad_pcb, progboard.sch]
2020-11-07 Add a timeout to the i2c driver
2020-11-07 Fix potentional divide by zero
    [main.c]
2020-11-08 Use oscilloscope to automate ramp calibration
2020-11-08 Acknowledge LUT entry write sysex messages to avoid overflowing buffers
    [gem_sysex_commands.c]
2020-11-10 Add missing sol calibration code
2020-11-11 Finish up ADC calibration for factory setup
2020-11-13 Fix bug preventing the settings from being read over sysex
    [gem_sysex_commands.c]
2020-11-14 Don't print out the hex of the settings when saving it
2020-11-14 Add knob calibration
2020-12-04 Change TCC GCLK div to 1 for higher resolution frequency for pulse outs, update the param table and config to match.
    [pitch-calibration-table.csv]
2020-12-04 Push SPI buadrate up to 8MHz (SK9822 max is 40MHz!)
2020-12-14 Add git hook to ensure pdfs of schematics stay up to date
2020-12-22 Add button helper
2020-12-22 Use button helper in main, collect some common params into structs
2020-12-22 Factor out the pitch calculation, update some default settings
2020-12-22 Use fix16 clamp
2020-12-22 Use a macro for 12-bit clamping
2020-12-22 Add LED animation for tweak mode
2020-12-23 Fix clang format for the if_waggled macro
    [main.c]
2020-12-23 Add settings for pwm lfo
2021-01-11 Switch firmware to structy
2021-01-11 Fix some tidy warnings
    [gem_sysex_commands.c]
2021-01-12 Add pitch_knob_nonlinearity - make it easier to tune the oscillators
    [gem.h, gem_settings_load_save.c, main.c]
2021-01-13 Added SPDX identifiers, and fixed a couple of issues in the get_fw_size.py script (#1)
2021-01-14 Fix settings load not using a large enough buffer, fix settings save not encoding to the right offset
    [gem_settings_load_save.c]
2021-01-14 Work around gem_midi_sysex_send not automatically inserting the sysex start byte and fix chunk decoding for save_settings
    [gem_sysex_commands.c]
2021-01-21 Print out the build info on boot
2021-01-21 Allow fetching the serial number over sysex. Save calibration information locally
2021-01-21 Thoroughly document all applicable licenses
    [analogins.sch, castor.sch, jackboard.kicad_pcb, jackboard.sch, mainboard.kicad_pcb, mainboard.sch, mcu.sch, outputmixer.sch]
2021-01-23 Re-measure ADC error after doing calibration
2021-01-23 Make the ramp calibration output a little less noisy
2021-01-23 Fix some errors in the data handling in gem_sysex_commands
    [gem_sysex_commands.c]
2021-01-23 Fix knob error correction - fliping the adc input caused the error correction to be applied incorrectly
    [main.c]
2021-01-23 Add calibrations to gitignore
2021-01-23 Print out build ID during build
2021-01-24 Use a reference calibration instead of the spreadsheet data
2021-01-24 Avoid unnecessary calculations in LED animation
    [gem_led_animation.c]
2021-01-24 Make the ramp calibration prettier.
2021-01-24 Lower the step for the pitch illustration
2021-01-25 Update ramp calibration to use the update() method for Updateable
2021-01-25 Change the calibration mode animation
2021-01-25 Fixed bug where the ADC's non-linearity at the bottom of its range would cause the pitch knobs to glitch. Added timing to monitor updates.
    [gem_led_animation.c, gem_led_animation.h, main.c]
2021-01-26 Add Micro Trace Buffer support
2021-01-26 Replace DEBUG_TRAP with wntr_assert
    [gem_settings_load_save.c, gem_sysex_commands.c]
2021-01-26 factory: Change the log level for measurements in ADC calibration
2021-01-26 factory: take more samples when doing knob calibration
2021-01-26 factory: simplify ramp calibration procedure by using two scope channels and add special handling for some of the lower frequencies since their waveforms are distorted
2021-01-26 factory: fix jlink script so it properly resets the device after programming
2021-01-26 factory: create libgemini.calibration_stats which can generate reference calibration data based on past calibrations.
2021-01-28 Change generate_voice_params_table.py to use reference calibration instead of the spreadsheet data
2021-01-28 Remove unused data/pitch-calibration-table.csv
    [pitch-calibration-table.csv]
2021-01-30 Address some feedback from Microchip
    - Don't needlessly clear the RESREADY flag.
    - Don't needlessly enable the RESREADY interrupt every time scan_next_channel is called.
    - Cancel any in-progress conversion in gem_adc_read_sync()
2021-01-30 Cleanup some comments in the schematic
    [mcu.sch, outputmixer.sch, power.sch]
2021-02-01 Switch from Make to Ninja
2021-02-01 Fixup GitHub actions to run Ninja (#7)
    [configure.py]
2021-02-01 Create hardware revision mainboard v3
    This addresses an issue with the ramp oscillators using the wrong type of transistor.
    [analogins.sch, castor.sch, mainboard.kicad_pcb, mainboard.sch, mcu.sch, outputmixer.sch, power.sch]
2021-02-01 hardware: finalize BOM for v3, change 200kOhm resistors to 0603.
    [analogins.sch, castor.sch, mainboard.kicad_pcb, mainboard.sch, mcu.sch, outputmixer.sch, power.sch]
2021-02-01 factory: Add fallback calibration for revised oscillators
2021-02-01 firmware: re-generate voice_param_table from fallback/reference calibration; add libgemini/oscillators to hold common methods for osc behavior
    [configure.py]
2021-02-02 firmware: use full 3.3v range of the DAC for charge voltage
2021-02-03 factory: fallback calibration follows oscillators.calibration_note_range()
2021-02-03 factory: refactor ramp calibration based on experience with new oscillator design
2021-02-03 firmware: use new ramp calibration data layout, adjust GemVoiceParam_from_cv to interpolate across voltage and period, use integer division instead of fix16 division
    [gem_voice_param_table_load_save.c, gem_voice_params.c]
2021-02-03 firmware: add note about slightly non-linear nature of DAC charge codes
2021-02-04 factory: new ramp calibration strategy using manual setpoints
2021-02-04 factory: make shell set the PWM duty cycle to 50% while sweeping notes
2021-02-04 firmware: fix writing, loading, and saving dac code table
    [gem_sysex_commands.c, gem_voice_param_table_load_save.c]
2021-02-05 factory: add adc read helper to shell
2021-02-05 factory: re-do ADC calibration implementation
    ADC calibration is now done directly though the ADC and a separate calibration is done through the Analog Front End (AFE) to account for errors needed for the CV inputs.
2021-02-05 factory: use re-worked ADC calibration
2021-02-05 docs: update settings editor for new cv calibration fields
2021-02-05 hardware: new revision of programming board with more comprehensive test points
    [progboard.kicad_pcb, progboard.sch]
2021-02-06 hardware: finalize v3 of mainboard for production
    [analogins.sch, castor.sch, mainboard.kicad_pcb, mainboard.sch, mcu.sch, outputmixer.sch, power.sch]
2021-02-06 hardware: finish up mpn assignments for mainboard
    [analogins.sch, castor.sch, mainboard.sch, mcu.sch, outputmixer.sch, power.sch]
2021-02-07 firmware: properly apply CV ADC error correction.
    [main.c]
2021-02-07 factory: use better time division changes for the oscilloscope in ramp calibration
2021-02-07 factory: change the adc error calculation to stop once the upper and lower cross
2021-02-07 factory: use multiple channels on Sol to make ADC/AFE calibration easier
2021-02-08 firmware: refactor oscillator update logic into gem_oscillator.h/c
    Additionally, cleanup main and give contextual comments for the core logic.
    [gem.h, gem_adc.h, gem_oscillator.c, gem_oscillator.h, main.c]
2021-02-08 hardware: matched hierachical symbol directions with signal directions. (#8)
    The hierarchical symbols now show the signal directions. Output pointing away from the circuit block and inputs pointing in.
    [analogins.sch, castor.sch, mainboard.sch, mcu.sch, outputmixer.sch]
2021-02-08 firmware: avoid two unnecessary calculations of the ramp CV
    [gem_oscillator.c, gem_oscillator.h, main.c, test_lookup_tables.c]
2021-02-09 hardware: update board outline to satisfy manufacturing constraints
    [mainboard.kicad_pcb]
2021-02-09 factory: regenerate reference ramp calibration
2021-02-10 firmware: nudge the knob's range so that the pitch knobs can better cover the full range.
2021-02-10 factory: change the channel used to calibrate the ADC
2021-02-10 factory: fix Sol channels for ADC/AFE calibration, initialize Gemini before oscilloscope in ramp calibration
2021-02-13 firmware: bump the pitch knob range multipler up just a lil bit
2021-02-14 docs: Add the ability to restore ADC calibration from factory backup
2021-02-17 factory: speed up ADC/AFE re-measuring process
2021-02-18 firmware: only apply ramfunc annotation when compiling for ARM
2021-02-19 factory: revert incorrect change to calibration point calculation
2021-02-21 factory: lower the number of measurement points for the ADC calibration
2021-02-22 firmware: Add soft reset sysex command
    [gem_sysex_commands.c]
2021-02-22 firmware: Fix bug where non-linear tuning knob response wasn't actually being applied.
    [gem_oscillator.c, gem_test.h, test_oscillator.c]
2021-02-22 firmware: Skip look-up table for knob bezier calculation.
    [gem_oscillator.c]
2021-02-22 firmware: split the "hello" sysex command into one to get the build ID and one to enter calibration mode
2021-02-22 factory: use new sysex command for calibration mode.
2021-02-22 firmware: track idle cycles instead of ADC milliseconds, since the ADC samples faster than 1ms
2021-02-24 firmware: Replace test.mk with a wintertools.buildgen script
    [configure.py]
2021-02-27 hardware/progboard: Add dedicated jack for interfacing with knob inputs
    [progboard.kicad_pcb, progboard.sch]
2021-03-01 firmware: Add sysex command to reset into the bootloader
    [gem_sysex_commands.c]
2021-03-05 hardware: increase the programming board's outline thickness to push the copper fills back from the board edge
    [progboard.kicad_pcb]
2021-04-09 factory: Small tweaks to the monitor and calibration scripts.
2021-04-21 firmware: Check bootloader write protection fuses during initialization
    Previously, we assumed that the SAMD UF2 bootloader would *always* set
    the bootloader write protection fuses, however, it turns out that it
    only sets it in two cases:
    1. The fuses have completely bogus values (`0xFFFFFFFF`)
    2. The bootloader self-updates via UF2
    Since our boards have factory fuses set and we install the bootloader
    via flashing a `.bin` file, neither of these cases ever happened. This
    left the bootloader write protection disabled which could lead to the
    bootloader getting corrupted by spurious writes. We actually observed
    this behavior by stress testing power cycles.
    This change checks fuses on startup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
2021-04-21 firmware: Use the brown-out detector to ensure a stable operating voltage before running
    [gem.h, main.c]
2021-04-21 hardware: added values & datasheet for pots in schematic (#13)
    [jackboard.sch]
2021-04-22 firmware: Add struct access for the software calibration fuses
2021-05-16 firmware: Fixup tests and tidy
    [configure.py, gem_ramp_table_load_save.c, gem_settings_load_save.c]
2021-05-19 fix typo (#18)
    assembled -> assembly in Castor & Pollux user guide
2021-05-24 factory: enable using a gamepad for adjusting calibration; do a better job of guessing DAC code using the slope of previous codes
2021-05-26 hardware: Add a jig for the programming board
2021-05-29 hardware: Add CE and WEEE logos to mainboard
    [mainboard.kicad_pcb]
2021-06-10 firmware: Add base CV offset setting firmware: Apply base CV offset setting to both oscillators firmware: Add method to upgrade older settings data firmware: Remove chunking of sysex commands user gu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
    [gem_oscillator.c, gem_oscillator.h, gem_settings_load_save.c, gem_sysex_commands.c]
2021-06-13 hardware: assign new MPNs for mainboard BOM
    [analogins.sch, castor.sch, mcu.sch, outputmixer.sch, power.sch]
2021-06-14 hardware: mark version 4 of the mainboard
    [analogins.sch, castor.sch, mainboard.kicad_pcb, mainboard.sch, mcu.sch, outputmixer.sch, power.sch]
2021-06-20 factory: Print the build id when the firmware is updated by monitor
2021-06-21 hardware: export mainboard PDF in black & white to avoid KiCAD color issues
2021-07-08 hardware: Remove unneeded parts on the jackboard
    [jackboard.kicad_pcb, jackboard.sch]
2021-07-16 hardware: Remove unused project-specific footprint library from the jackboard
2021-08-31 firmware: Add advanced LFO support.
    - Added WntrMixedPeriodicWaveform for combining multiple periodic waveforms together.
    - Added sawtooth & square waveshapes to wntr_waveforms.
    - Changed the LFO from a single, fixed sawtooth to a combination of two waveforms with control over waveshape, amplitude, and frequency.
    - Added new settings fields for the LFO, and logic to upgrade older settings.
    [gem_led_animation.c, gem_settings_load_save.c, main.c]
2021-08-31 factory: Update gem_settings.py to match current settings
2021-08-31 user guide: Re-draw LFO waveshape when loading settings from device
2021-09-13 firmware: Add support for MCP4728 devices with different addresses, since we used the A0 variant for rounds 1 & 2 and the A4 variant for round 3
2021-09-13 factory: Save full ADC/AFE measurement data
2021-09-18 hardware: add basic testkit adapter board
    [testkit-adapter.kicad_pcb, testkit-adapter.sch]
2021-09-19 firmware: print SysEx commands in debug mode
2021-09-20 factory: Update to use MIDI device singletons
2021-09-20 hardware: prepare testkit adapter for manufacturing
    [testkit-adapter.kicad_pcb]
2021-09-20 firmware: Fix unused variable warning when using debug_printf
    [gem_sysex_commands.c]
2021-10-01 user guide: fix string comparison for midi device names
2021-10-08 factory: speed up ADC calibration process
2021-10-26 Add basic panel without Winterbloom branding
    [panel.kicad_pcb]
2021-12-08 hardware/testkit-adapter: Add laser designs for pin holder, board guide, and pressure plate
    [testkit-adapter.kicad_pcb, testkit-adapter.sch]
2021-12-26 factory: fancier printing
2022-01-03 factory: change Hubble LEDs during factory setup
2022-01-14 factory: move ramp calibration to the end
2022-05-11 factory: don't print report if not all steps are run
2022-06-19 user guide: link to assembled and kit product pages
2022-07-06 Fix PWM and pitch "stepping" behavior
    Previously, Gemini used the MCP2748 DAC's sequential update command to update the control voltages for amplitude compensation and pulse width. This command actually waits for the DAC's EEPROM to update before allowing another change so it significantly lowered refresh rate of the DAC (to around 25 ms!). This switches to using the "fast update" command instead which bypasses the EEPROM and theoretically allows updating at 166 kHz. However, because Gemini's update loop is only run once the ADC has new data, the effective update rate is 1.4 kHz. This is *plenty* fast enough and completely eliminates the stepping behavior.
    [gem_mcp4728.c]
2022-07-06 Add firmware support for pulse width bitmasking
    This allows emulating the old behavior before the DAC refresh rate was fixed.
    [gem_oscillator.c, gem_oscillator.h, gem_settings_load_save.c, gem_sysex_commands.c, main.c]
2022-07-06 Add pulse width behavior settings
    Also changes the behavior of the "save" button to automatically soft reset the module. Closes #28.
2022-07-14 Remove jackboard
    [User Library-PJ301M-12 Thonkiconn v0_2.STEP, c-5787834-1-c-3d.step, eurorack-power.step, jackboard.kicad_pcb, jackboard.sch, ptv09a-2x20f-xxxx.stp, ptv09a-4x20f-xxxx.stp, ptv09a-4x20u-xxxx.stp]
2022-07-14 WIP revision of mainboard. Fully routed, DRC passing, more small things to do
    [analogins.kicad_sch, castor.kicad_sch, leds.kicad_sch, mainboard.kicad_pcb, mainboard.kicad_sch, mcu.kicad_sch, outputmixer.kicad_sch, power.kicad_sch]
2022-07-15 Get DRC passing
    [mainboard.kicad_pcb, mainboard.kicad_sch, power.kicad_sch]
2022-07-15 Cleanup silkscreen
    [mainboard.kicad_pcb, mainboard.kicad_sch, mcu.kicad_sch]
2022-07-15 More small silkscreen cleanups
    [mainboard.kicad_pcb]
2022-07-15 More refinements to the board design
    [mainboard.kicad_pcb]
2022-07-15 Add USB notch, PCB specifications
    [mainboard.kicad_pcb]
2022-07-15 Update stackup settings
    [mainboard.kicad_pcb]
2022-07-15 Swap ext connector for a vertical one
    [mainboard.kicad_pcb, mainboard.kicad_sch]
2022-07-15 Widen ground vias
    [mainboard.kicad_pcb]
2022-07-15 Pull power traces onto one layer
    [mainboard.kicad_pcb]
2022-07-15 Add ESD protection for inputs
    [analogins.kicad_sch, mainboard.kicad_pcb, mainboard.kicad_sch, power.kicad_sch]
2022-07-16 Progress on cleaning up the schematics
    [analogins.kicad_sch, castor.kicad_sch, leds.kicad_sch, mainboard.kicad_sch, mcu.kicad_sch, outputmixer.kicad_sch, power.kicad_sch]
2022-07-16 Fixup some wacked stuff from the schematic cleanup
    [castor.kicad_sch, mainboard.kicad_pcb, mainboard.kicad_sch, power.kicad_sch]
2022-07-16 Cleanup MCU schematic
    [analogins.kicad_sch, castor.kicad_sch, leds.kicad_sch, mainboard.kicad_pcb, mainboard.kicad_sch, mcu.kicad_sch, outputmixer.kicad_sch, power.kicad_sch]
2022-07-17 More schematic cleanup - nearly done!
    [analogins.kicad_sch, castor.kicad_sch, leds.kicad_sch, mainboard.kicad_pcb, mainboard.kicad_sch, mcu.kicad_sch, outputmixer.kicad_sch]
2022-07-17 Clear ERC
    [castor.kicad_sch, mainboard.kicad_pcb, mainboard.kicad_sch, mcu.kicad_sch, power.kicad_sch]
2022-07-17 Fix button footprint
    [mainboard.kicad_pcb, mainboard.kicad_sch, mcu.kicad_sch]
2022-07-17 Reannotate schematic
    [analogins.kicad_sch, castor.kicad_sch, leds.kicad_sch, mainboard.kicad_pcb, mainboard.kicad_sch, mcu.kicad_sch, outputmixer.kicad_sch, power.kicad_sch]
2022-07-17 Normalize component values
    [analogins.kicad_sch, castor.kicad_sch, mainboard.kicad_pcb, mainboard.kicad_sch, outputmixer.kicad_sch, power.kicad_sch]
2022-07-18 Switch audio filter caps to 0603. Start auditing BOM
    [analogins.kicad_sch, castor.kicad_sch, mainboard.kicad_pcb, mainboard.kicad_sch, mcu.kicad_sch, outputmixer.kicad_sch, power.kicad_sch]
2022-07-18 Audit BOM, replace some parts with alts
    [analogins.kicad_sch, castor.kicad_sch, leds.kicad_sch, mainboard.kicad_sch, mcu.kicad_sch, outputmixer.kicad_sch, power.kicad_sch]
2022-07-18 Switch EXT header to a 2x5 1.27mm pitch IDC header
    [mainboard.kicad_pcb, mainboard.kicad_sch, outputmixer.kicad_sch]
2022-07-19 A little more schematic cleanup
    [analogins.kicad_sch, castor.kicad_sch, leds.kicad_sch, mcu.kicad_sch, outputmixer.kicad_sch, power.kicad_sch]
2022-07-19 Finalize resistor mpns
    [analogins.kicad_sch, castor.kicad_sch, mainboard.kicad_pcb, outputmixer.kicad_sch]
2022-07-26 * Added versions strapping pins * Added VBUS power * Filled out regulator thermal calculations
    [analogins.kicad_sch, castor.kicad_sch, leds.kicad_sch, mainboard.kicad_pcb, mainboard.kicad_sch, mcu.kicad_sch, outputmixer.kicad_sch, power.kicad_sch]
2022-07-28 Update some MPNs
    [analogins.kicad_sch, mainboard.kicad_pcb, mcu.kicad_sch, power.kicad_sch]
2022-08-05 hardware: Updated jack footprints so they have f.fab markings
    [mainboard.kicad_pcb]
2022-08-06 firmware: initial work to support revision 5
    Completely changes `gem_config.h` and moves configuration from defines to structs.
    Each peripheral (adc, i2s, spi, dotsar, etc.) has its own config struct type.
    `main.c` selects between the rev1-4 config structs or the rev5 config struct instances.
    Much more to be done, but this is a good starting point.
2022-08-06 firmware: Add pin-based hardware revision determination
2022-08-06 firmware: account for differences in adc input inversion between hardware revisions
2022-08-06 hardware: note correct waveform outputs for TCC
    [mcu.kicad_sch]
2022-08-06 hardware: fix sercom pads for dotstar SPI
    [mainboard.kicad_pcb, mcu.kicad_sch, power.kicad_sch]
2022-08-06 hardware: ignore kicad_prl files
2022-08-06 hardware: remove legacy kicad files
    [analogins.sch, castor.sch, mainboard.sch, mcu.sch, outputmixer.sch, power.sch]
2022-08-06 Remove unused / old footprints
    [mainboard.kicad_pcb]
2022-08-06 hardware: remove unused 3dmodels
    [User Library-1x6 TH Pitch 2_54mm.STEP, User Library-2_54mmheader14.STEP, c-5787834-1-c-3d.step, smt_tact.step]
2022-08-07 hardware: add fancy labels
    [mainboard.kicad_pcb]
2022-08-08 hardware: add rating field to schematic
    [analogins.kicad_sch, castor.kicad_sch, mainboard.kicad_sch, mcu.kicad_sch, outputmixer.kicad_sch, power.kicad_sch]
2022-08-08 hardware: fixup schematic fields
    [analogins.kicad_sch, castor.kicad_sch, leds.kicad_sch, mainboard.kicad_sch, mcu.kicad_sch, outputmixer.kicad_sch, power.kicad_sch]
2022-08-08 hardware: fixup the last few funky symbols
    [mcu.kicad_sch, power.kicad_sch]
2022-08-08 hardware: minor tweaks to power schematic's layout
    [power.kicad_sch]
2022-08-08 hardware: update footprint properties from schematic
    [mainboard.kicad_pcb]
2022-08-08 hardware: use winterbloom footprints for C, R, and L
    [analogins.kicad_sch, castor.kicad_sch, mainboard.kicad_pcb, mainboard.kicad_sch, mcu.kicad_sch, outputmixer.kicad_sch, power.kicad_sch]
2022-08-08 hardware: update schematic pdf
    [mainboard.kicad_pcb]
2022-08-09 firmware: Adjust ADC input range for V5
2022-08-10 hardware: add alt usb header
    [analogins.kicad_sch, castor.kicad_sch, leds.kicad_sch, mainboard.kicad_pcb, mainboard.kicad_sch, mcu.kicad_sch, outputmixer.kicad_sch, potentiometers.kicad_sch]
2022-08-10 hardware: spruce up some labels
    [mainboard.kicad_pcb, mainboard.kicad_sch, power.kicad_sch]
2022-08-26 hardware: update 3d model for JST header
    [mainboard.kicad_pcb]
2022-09-26 hardware: update some labels, fix some fields, re-do fancytext
    [analogins.kicad_sch, castor.kicad_sch, leds.kicad_sch, mainboard.kicad_pcb, mainboard.kicad_sch, mcu.kicad_sch, outputmixer.kicad_sch, potentiometers.kicad_sch]
2022-09-26 hardware: change R22-R24 value to 100k, mark as optional
    [castor.kicad_sch, mainboard.kicad_sch]
2022-09-26 hardware: wire an ADC pin to 3v3 for self-calibration
    [mainboard.kicad_pcb, mainboard.kicad_sch, mcu.kicad_sch]
2022-09-26 hardware: bump issue date
    [analogins.kicad_sch, castor.kicad_sch, leds.kicad_sch, mainboard.kicad_pcb, mainboard.kicad_sch, mcu.kicad_sch, outputmixer.kicad_sch, potentiometers.kicad_sch]
2022-10-08 Add expander
    [expander.kicad_pcb, expander.kicad_sch]
2022-10-08 Add copper fills to front and back, swap usb header for solder wire pads
    [analogins.kicad_sch, castor.kicad_sch, leds.kicad_sch, mainboard.kicad_sch, mcu.kicad_sch, outputmixer.kicad_sch, potentiometers.kicad_sch, power.kicad_sch]
2022-10-08 Remove unused progboard, panel
    [panel.kicad_pcb, progboard.kicad_pcb, progboard.sch]
2022-10-24 hardware: Aadd expander and hubble lens
    [expander.kicad_pcb, hubble-lens.kicad_pcb, hubble-lens.kicad_sch]
2022-10-29 firmware: Fix SystemInit() and TCC initialization
    [gem_pulseout.c]
2022-10-31 firmware: Fix ADC channel order
    [gem_adc_channels.h]
2022-11-04 firmware: Fixup some small issues
    [gem_sysex.c, main.c]
2022-11-16 Revising part numbers
    [mainboard.kicad_sch, mcu.kicad_sch, power.kicad_sch]
2023-02-26 Add new hubble lens board guide
2023-02-26 Update mainboard schematic files to KiCAD 7
    [analogins.kicad_sch, castor.kicad_sch, leds.kicad_sch, mainboard.kicad_sch, mcu.kicad_sch, outputmixer.kicad_sch, potentiometers.kicad_sch, power.kicad_sch]
2023-02-26 Update mainboard pcb files to kicad 7
2023-03-14 Updating factory scripts to support v2 board and hubble lens
2023-03-20 hardware: update mechanical design for hubble lens
2023-03-20 hardware: add interposer board
    [interposer.kicad_pcb, interposer.kicad_sch, interposer.step]
2023-03-20 firmware: more work towards modal interface
    - Added GemMode enum
    - Added simple LED transition between modes
2023-03-21 firmware: improve mode switch animation and idle animation, use lfo value to control sparkle rate
2023-03-23 firmware: Keep track of the waveform amplitude in wntr_periodic_waveform
2023-03-23 firmware: when testing, print more detailed message when a f16 assertion fails
    [gem_test.h]
2023-03-23 firmware: fixup configure script for tests
    [configure.py]
2023-03-23 firmware: implement new pitch behaviors and oscillator modes
    [gem_oscillator.c, gem_oscillator.h, test_oscillator.c]
2023-03-24 firmware: add Oscillator.pitch_behavior for easier inspect of pitch behavior
    [gem_oscillator.c, gem_oscillator.h]
2023-03-24 factory: add clock calibration script
2023-03-24 factory: save clock calibration locally
2023-03-24 factory: add clock calibration to factory_setup
2023-03-26 firmware: Add LED indications for pitch adjustments
2023-03-27 firmware: Adjust ADC configuration to bump effective sample rate from 1.5 kHz to 5 kHz.
2023-03-27 firmware: place i2c_write into RAM
2023-03-27 user guide: Add ability to re-calibrate tuning
2023-03-29 firmware: add LED configuration for C&PI
2023-03-29 firmware: configuration fixes for rev4 boards
2023-04-02 factory: fixup clock calibration script
2023-04-02 factory: fix calculation of pitch offset
2023-04-05 firmware: Increase the FM deadzone to avoid FM still being applied even when the knob is fully CCW
    [test_oscillator.c]
2023-04-22 factory: Calibrate zero volt threshold
2023-06-29 factory: fix castor pitch range check in monitor.py
2023-09-11 firmware: Fix C&PI's configuration so that it properly inverts the pulse width CV ADC code.
2023-10-16 settings editor: fix ADC channel used for CV calibration
2024-02-07 setting editor: fix restore calibration functionality, add ability to swap ramp calibration tables
2024-02-07 firmware: Remove channel swap for SysEx set frequency
    [gem_sysex.c]
2024-02-10 firmware: Fix issue with fix16 rounding causing pitch glitches
    [gem_oscillator.c, test_oscillator.c]
2024-02-11 meta: fixup github actions
    [gem_test.h]
2024-02-28 user guide: add mode LED colors
2025-01-26 User guide: update calibratons to pull from github instead of cloud storage
2025-01-26 User guide: moved `mp3` sound samples from google cloud storage to git.
2025-01-30 Hardware: added faceplates for v1, v2, and the expander
    [faceplate.kicad_pcb]
2025-04-29 Update hardware designs to KiCad 9 (#32)
    * update mainboard to kicad 9
    * update expander to kicad 9
    * update expander faceplate to kicad 9
    * update faceplate-1 to kicad 9
    * update faceplate-2 to kicad 9
    * update hubble-lens to kicad 9
    * update interposer to kicad 9
    * update layout templates to kicad 9
    [analogins.kicad_sch, castor.kicad_sch, expander.kicad_pcb, expander.kicad_sch, faceplate.kicad_pcb, hubble-lens.kicad_pcb, hubble-lens.kicad_sch, interposer.kicad_pcb]
2025-09-22 docs: Create BASIC_FLASH_GUIDE.md (#33)
    This is based on the steps I followed when flashing my Castor and Pollux boards.
    I don't have the ability to verify if these steps work with Apple hardware of any description, but they should hopefully be similar enough to be usable.
