wntrblm/Castor_and_Pollux/(notices)

Notices in the files:
hardware/faceplate-1/faceplate.kicad_pcb:
CC BY-NC-ND 4.0
